IPrearo/PPOFs/README.md

# FIBRAS ÓPTICAS POR IMPRESSÃO 3D
Repositório para compartilhamento de dados do projeto "Fibras Ópticas por Impressão 3D," vigente de setembro de 2026 a agosto de 2029.
"PPOFs" é abreviação para "Printed Preform Optical Fibres."
