IPrearo/PPOFs/Relatorios de puxamento/PLT0019_no_core_petghf_vermelho_fdm/relatorio.pdf

Doc ID: PLT0019 Doc tipo: Relatório de fabricação

No core FDM PETG
Page 1 of 3

# 1 Pré-forma

A foto da pré-forma/tubo é mostrada em Fig. 1.

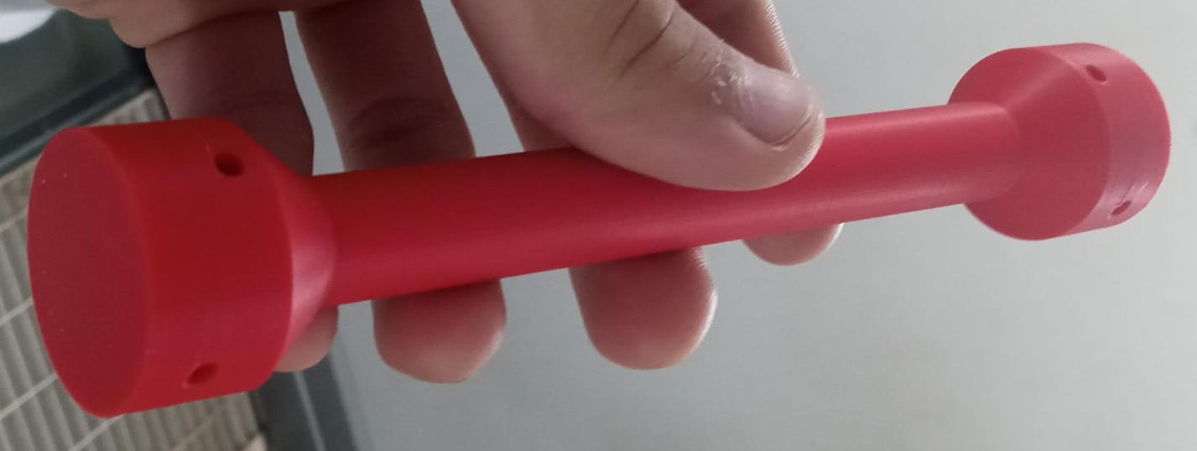
[picture p5: figure]

Figura 1: Tube.

Segue abaixo os principais parâmetros geométricos da pré-forma/do tubo.

- Participante(s) na confecção: Ivan Prearo.
- Objetivo: optimizar temperatura e velocidades de puxamento para amostra de PETG impressa na Bambum por FDM.
- Design: no core.
- As dimensões geométricas da pré-forma são mostrads no esquema da Fig. 2.

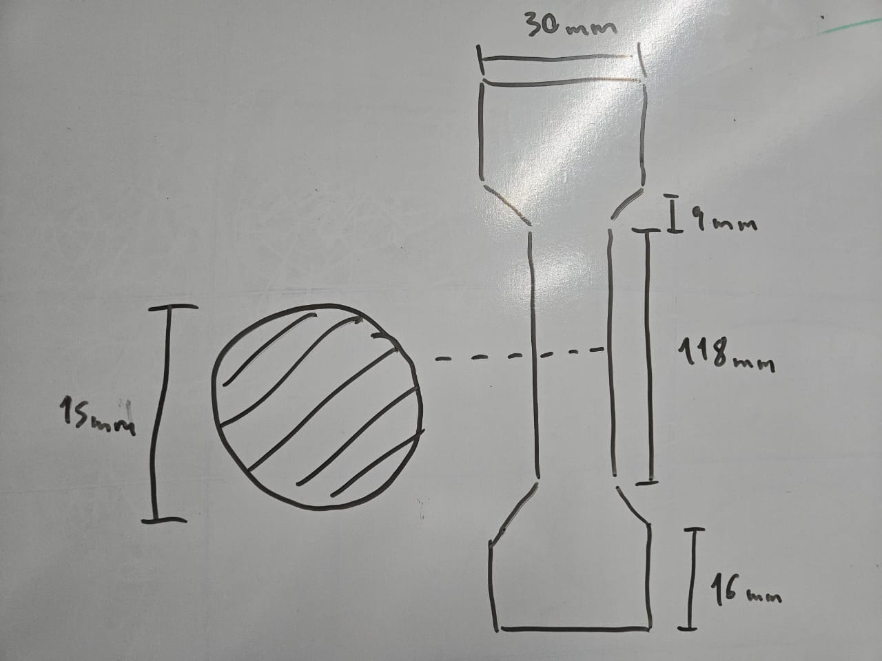
[picture p6: figure]

Figura 2: Tube.

Não houve condicionamento térmico da pré-forma nos fornos fora da torre de polímero, já que esse é um dos testes.

# 2 Primeiro puxamento

Não há primeiro puxamento para esta pré-forma.

# 3 Segundo puxamento

A rampa de temperatura do segundo puxamento é mostrada na Tab. 1.

© 2025 LaFE. All rights reserved. | Ultima data de revisão: 10/10/2025 ´

Doc ID: PLT0019 Doc tipo: Relatório de fabricação

Page 2 of 3
Temperature [°C] | Time [min]
120 130 | 30 5

Tabela 1: Rampa de temperatura no forno da torre para o segundo puxamento.

Segue abaixo alguns comentários gerais sobre o segundo puxamento.

- Data de puxamento: 10/10/2025.
- Participante(s): Eduardo Souza e Ivan Prearo.
- Iniciamos a rampa de temperatura a 120°C e após 30min fizemos o teste do unclamp/clamp. Notamos que a pré-forma começou a escorrer.
- Mudamos para 130°C e após a 5min iniciamos o puxamento.
- vfeed = 0.5mm/min.
- Inicamos vpull em 0.011m/min e fomos aumentando gradualmente.
- A amostra começou a ser puxada bem, no entando estouro depois de um tempo.
- A parte puxada é mostrada em Fig. 3a.
- Em Fig. 3b é possível ver a separação das camadas de impressão melhor, o que indica talvez que seja necessário aumentar o tempo da rampa de temperatura ou realizar condicionamento térmico de pré-rampa nos fornos fora da torre.
- Fig. 3c mostra que as paredes da pré-forma estavam sendo mais puxadas do que o núceo, o que indica uma inhomogeneidade de temperatura na pré-forma.
- Portanto, para o próximo puxamento desta a amostra, sugerimos:
– Realizar a rampa de temperatura proposta em Tab. 2.

– Variar mais lentamente vpull.

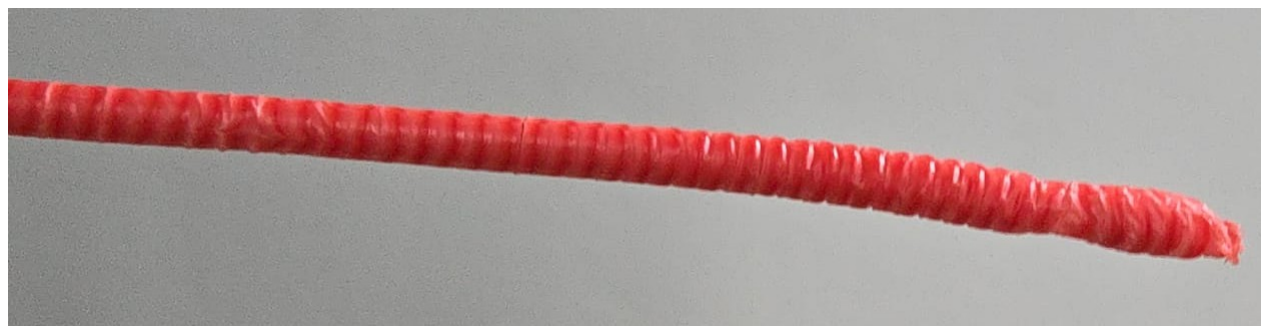
[picture p7: figure]
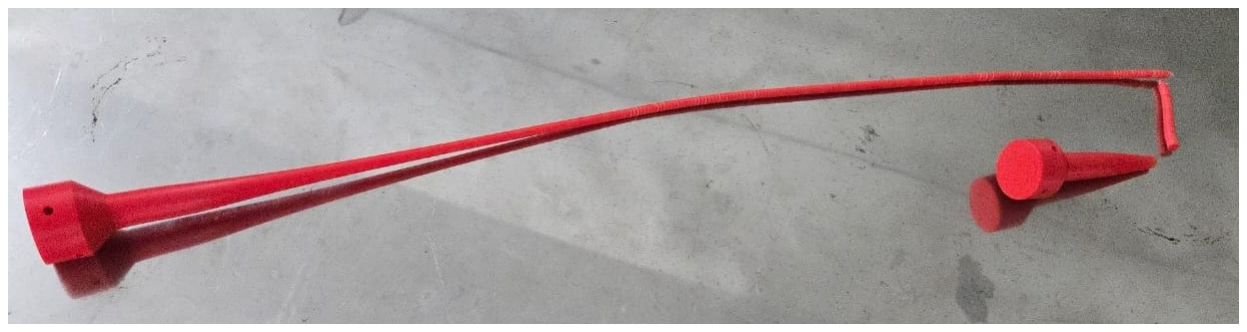
[picture p8: figure]

(a) Parte puxada. | (b) Separação das camadas de impressão.

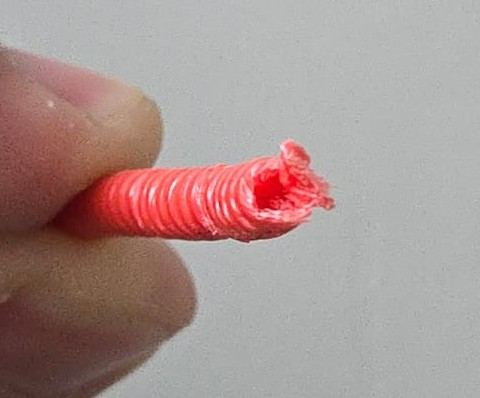
[picture p9: figure]

(c) Inomogeinedade de temperatura.

Figura 3: Fotos do resultado do segundo puxamento.

Doc ID: PLT0019 Doc tipo: Relatório de fabricação

Page 3 of 3
Temperature [°C] | Time [min]
90 100 110 120 130 | 30 30 30 5 2

Tabela 2: Proposta de rampa de temperatura no forno da torre para o próximo puxamento.
