IPrearo/PPOFs/Relatorios de puxamento/PLT0021_no_core_petghf_vermelho_fdm/relatorio.pdf

Doc ID: PLT0021 Doc tipo: Relatório de fabricação

FDM PETG
Page 1 of 4

# 1 Pré-forma

A foto da pré-forma é mostrada em Fig. 1.

Figura 1: Pré-forma.

Segue abaixo os principais parâmetros geométricos da pré-forma.

- Responsável pela confecção: Ivan Prearo.
- As dimensões desta pré-forma são as mesmas do relatório PLT0019 relatorio fabricacao fdm petg.
- Objetivo: optimizar a rampa de temperatura do puxamento, encontrar a temperatura de puxamento ideal e velocidades de alimentação e puxamento.

Não realizamos o condicionamento térmico da pré-forma nos fornos fora da torre de polímero, ou seja, após a impressão 3D a guardamos no armário.

# 2 Primeiro puxamento

Não se aplica!

# 3 Segundo puxamento

A rampa de temperatura do segundo puxamento é mostrada na Tab. 1. Possui uma duração total de 1h37min.
Temperature [°C] | Time [min]
90 100 110 120 130 | 45 30 15 5 2

Tabela 1: Rampa de temperatura no forno da torre para o segundo puxamento.

Segue abaixo alguns comentários gerais sobre o segundo puxamento.

- Data de puxamento: 17/10/2025.
- Participante(s): Eduardo Souza e Ivan Prearo.
- vfeed = 0.5mm/min.
- A amostra começou o puxamento bem, mas partiu após alguns minutos.
© 2025 LaFE. All rights reserved. | Ultima data de revisão: 17/10/2025 ´

Doc ID: PLT0021 Doc tipo: Relatório de fabricação

Page 2 of 4
- O resultado do puxamento é mostrado na Fig. 2
- A ponta partida parece ter sido puxada primariamente nas bordas e menos no centro (Fig. 3)
- A região mais puxada também parece ter separado as camadas de impressão da preforma (Fig. 4)
- Recomendamos realizar o puxamento a temperatura mais alta, possivelmente seguindo a rampa na Tabela 2.
- Para puxamentos a temperaturas maiores, pode ser necessário permitir a descida natural da fibra entre temperaturas da rampa, evitando a deformação vista no PLT0019, mas ainda atingindo temperaturas altas o suficiente para que as camadas de impressão não separem.

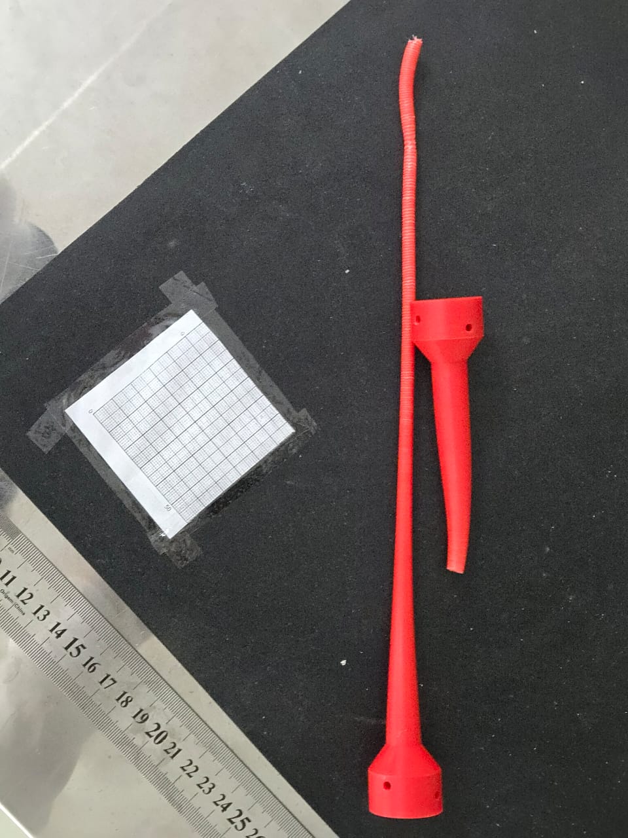
[picture p10: figure]

Figura 2: Resultado final do puxamento, com papel milimetrado para escala.

Doc ID: PLT0021 Doc tipo: Relatório de fabricação

Page 3 of 4

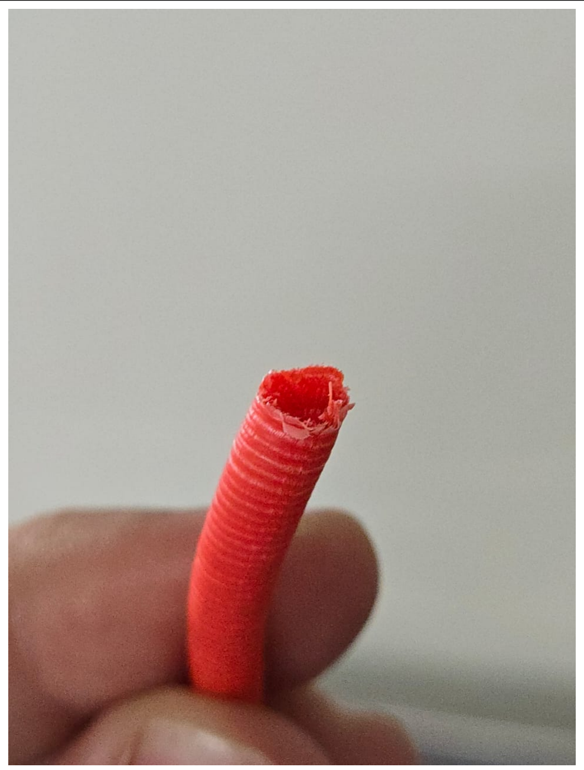
[picture p11: figure]

Figura 3: Ponto de falha do puxamento.

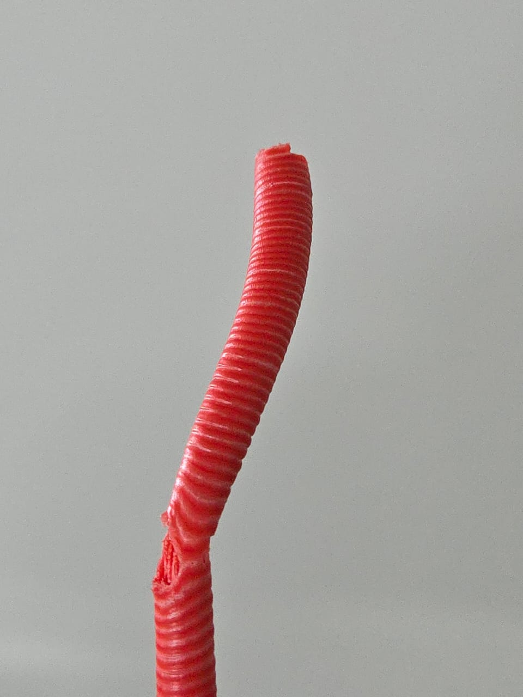
[picture p12: figure]

Figura 4: Região mais puxada do teste.

Doc ID: PLT0021 Doc tipo: Relatório de fabricação

Page 4 of 4
Temperature [°C] | Time [min]
90 110 130 140 150 | 45 30 15 5 2

Tabela 2: Rampa de temperatura no forno da torre recomendada.
