IPrearo/PPOFs/Relatorios de puxamento/PLT0024_no_core_petghf_vermelho_fdm/relatorio.pdf

Doc ID: PLT0024 Doc tipo: Relatório de fabricação

FDM PET-G HF Vermelho
Page 1 of 2

# 1 Pré-forma

A foto da pré-forma é mostrada em Fig. 1.

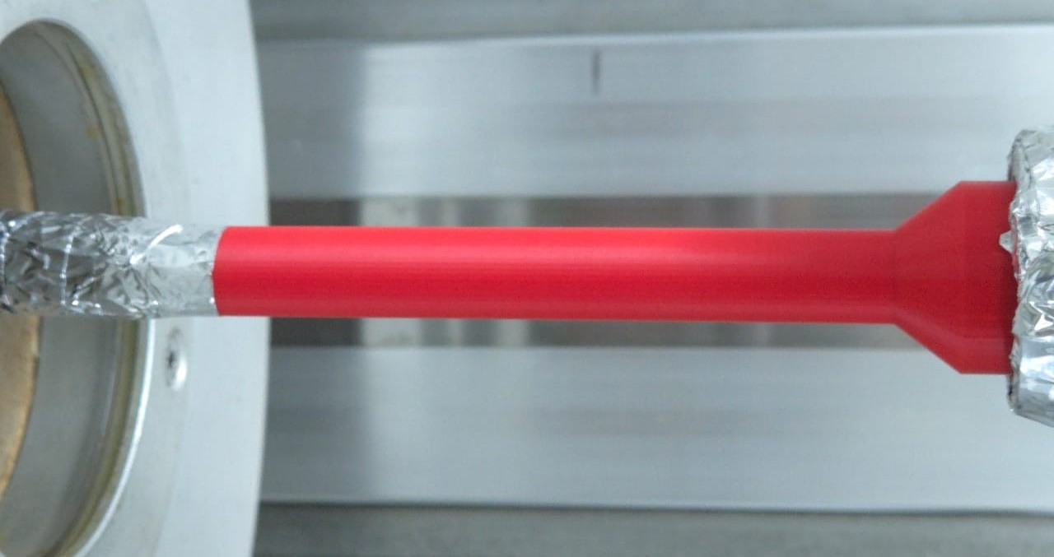
[picture p16: figure]

Figura 1: Pré-forma.

Segue abaixo os principais parâmetros geométricos da pré-forma.

- Participante(s) na confecção: Ivan Prearo;
- Design da pré-forma: no-core.
- Medidas semelhantes às descritas em PLT0019 preforma fdm petg hf vermelho, porém sem a parte de transição para 30mm na parte inferior para passar pelo Zumbach.
- Material: PET-G HF.
- Cor: vermelho.
- Método de fabricação: FDM.
- Objetivo: optimizar rampa de temperatura durante puxamento.

Não houve condicionamento térmico da pré-forma nos fornos fora da torre de polímero.

# 2 Primeiro puxamento

Não se aplica.

# 3 Segundo puxamento

A rampa de temperatura do segundo puxamento é mostrada na Tab. 1.
Temperature [°C] | Time [min]
90 120 150 170 190 | 45 30 15 5 2

Tabela 1: Rampa de temperatura no forno da torre para o segundo puxamento.

© 2025 LaFE. All rights reserved. | Ultima data de revisão: 30/10/2025 ´

Doc ID: PLT0024 Doc tipo: Relatório de fabricação

FDM PET-G HF Vermelho
Page 2 of 2
Podemos perceber por Fig. 2a que ocorre uma competição entre dois fenômenos para temperatura altas: a separação de camadas e a junção entre elas devido ao derretimento do polímero. Em Fig. 2b podemos perceber melhor o resultado final desta competição.

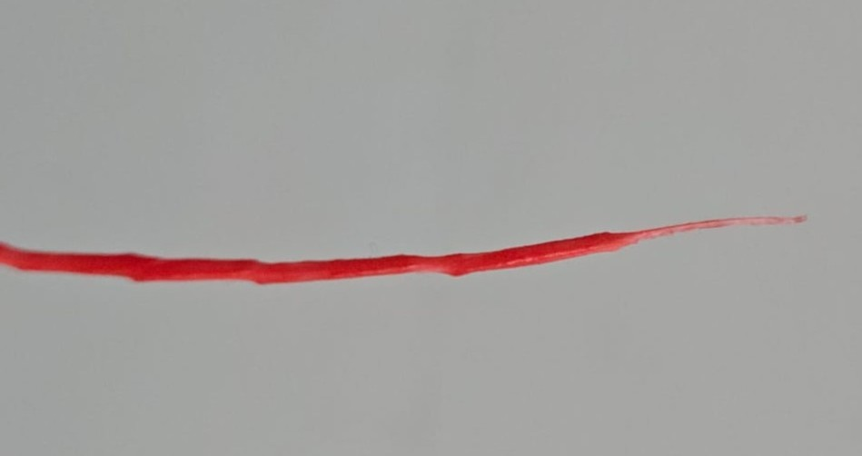
[picture p17: figure]
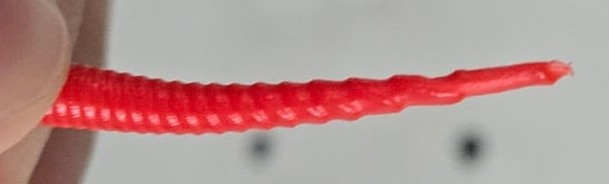
[picture p18: figure]

(a) Competição entre fenômenos. | (b) Separação das camadas.

Segue abaixo alguns comentários gerais sobre o segundo puxamento.

- Data de puxamento: 30/10/2025.
- Participante(s): Eduardo Souza e Ivan Prearo.
- vfeed = 0.5mm/min.
- Iniciamos com vpull = 0.018m/min e fomos aumentando gradualmente.
- A temperatura de puxamento ainda parece baixa pois é perceptível a separação entre as camadas da pré-forma.
- A pré-forma escorreu durante a rampa, ou seja, temos que reduzir o tempo em temperaturas a partir de 120°C e isso fez com que a fibra ficasse mais fina do que o desejado.
- Além disso, a tensão na fibra estava alta devido a baixa temperatura e esta arrebentou (Fig. 3).
- A nova rampa de tempratura é sugerida em Tab. 2.

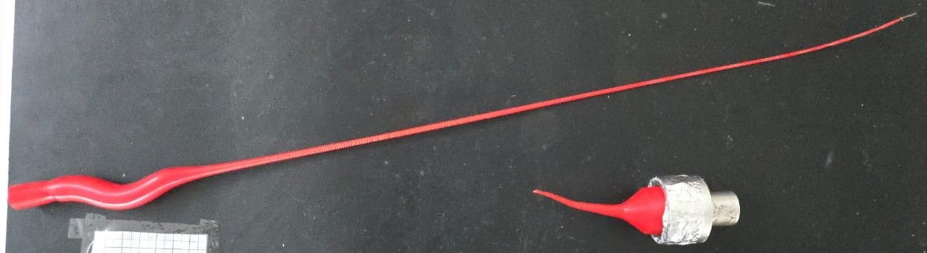
[picture p19: figure]

Figura 3: Rompimento da fibra durante o puxamento.

Temperature [°C] | Time [min]
90 120 150 170 190 200 | 45 15 5 5 2 2

Tabela 2: Rampa de temperatura no forno da torre para o segundo puxamento.

© 2025 LaFE. All rights reserved. | Ultima data de revisão: 30/10/2025 ´
