IPrearo/PPOFs/Relatorios de puxamento/PLT0032_no_core_petg_esverdeado_fdm/relatorio.pdf

Doc ID: PLT0030 Doc tipo: Relatório de fabricação

Título
Page 1 of 3

# 1 Pré-forma

A foto da pré-forma é mostrada em Fig. 1.

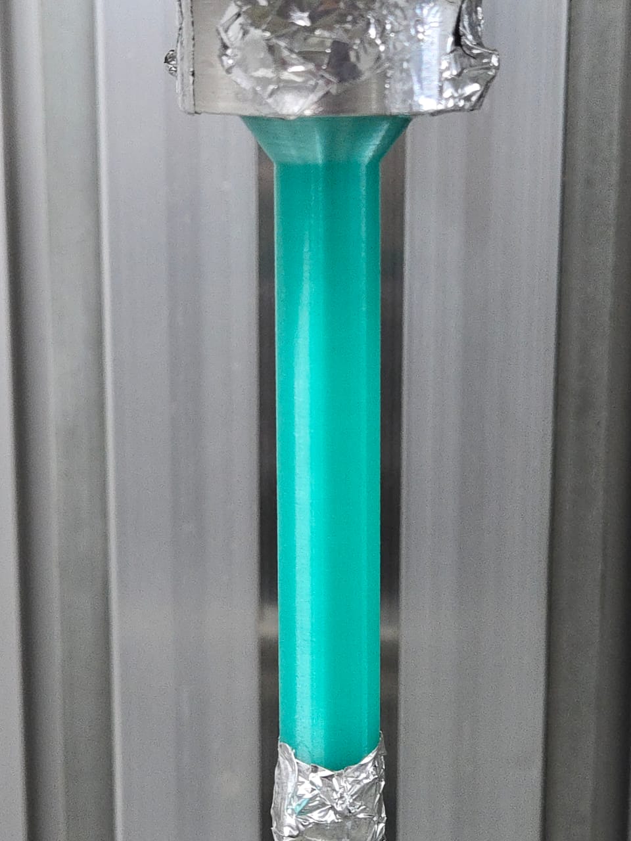
[picture p30: figure]

Figura 1: Pré-forma.

Segue abaixo os principais parâmetros geométricos da pré-forma/do tubo.

- Participante(s) na confecção: Ivan Prearo
- Altura/comprimento: 125 mm
- Diâmetro externo: 15 mm
- Objetivo: Caracterização da rampa de temperatura do material.

# 2 Segundo puxamento

A rampa de temperatura do segundo puxamento é mostrada na Tab. 1.
Temperature [°C] | Time [min]
90 120 190 | 60 10 2

Tabela 1: Rampa de temperatura no forno da torre para o segundo puxamento.

A foto das fibras produzidas é mostrada na Fig. 2.

© 2025 LaFE. All rights reserved. | Ultima data de revisão: 01/12/2025 ´

Doc ID: PLT0030 Doc tipo: Relatório de fabricação

Page 2 of 3

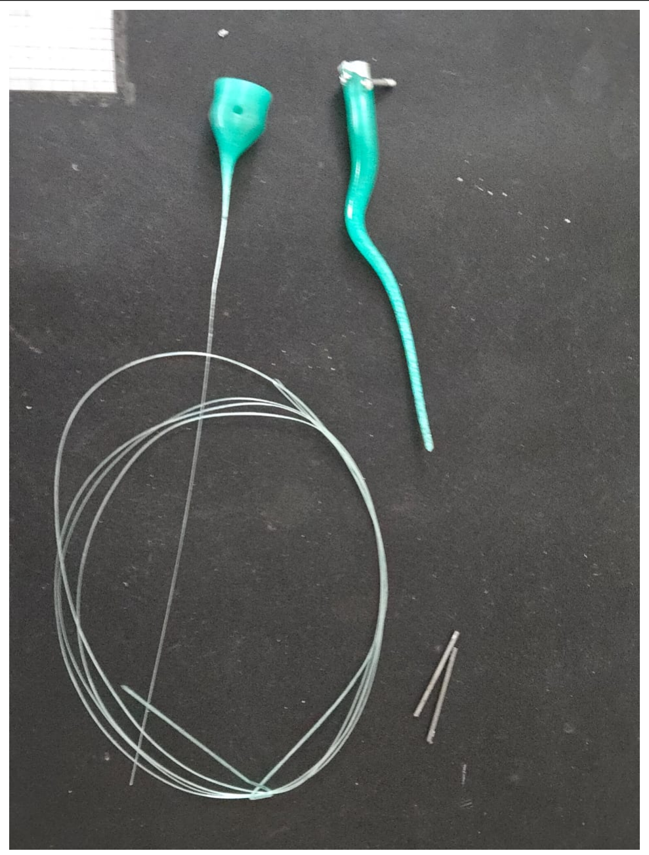
[picture p31: figure]

Figura 2: Fibras produzidas.

Segue abaixo alguns comentários gerais sobre o segundo puxamento.

- Data de puxamento: 29/11/2025
- Participante(s): Ivan Prearo
- A temperatura de puxamento de 200◦C se mostrou alta demais, pois a preforma deformou antes de ser puxada.

As fotos das micrografias são mostradas na Fig. 3. Nota-se que a fibra apresenta diversas bolhas, mas com geometria assimétrica na direção longitudinal.

Doc ID: PLT0030 Doc tipo: Relatório de fabricação

Page 3 of 3

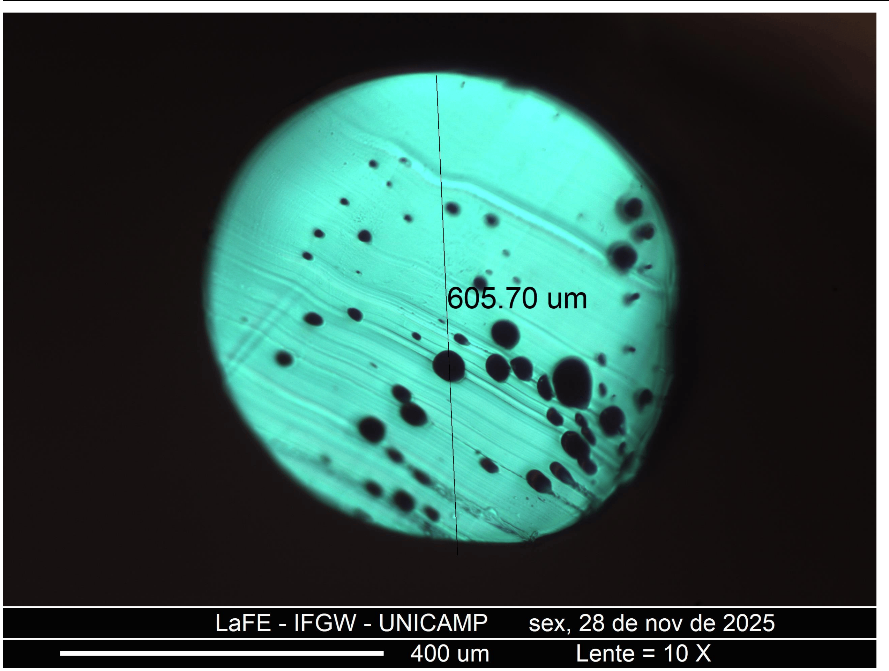
[picture p32: figure]
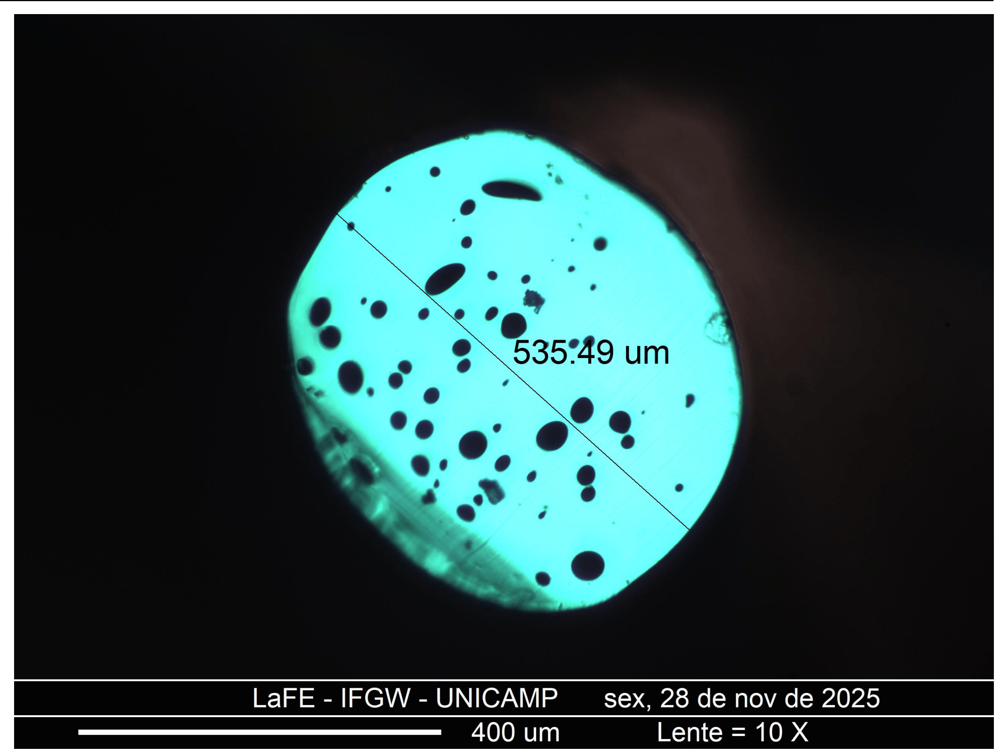
[picture p33: figure]

(a) Primeira clivagem. | (b) Segunda clivagem, maior eixo.

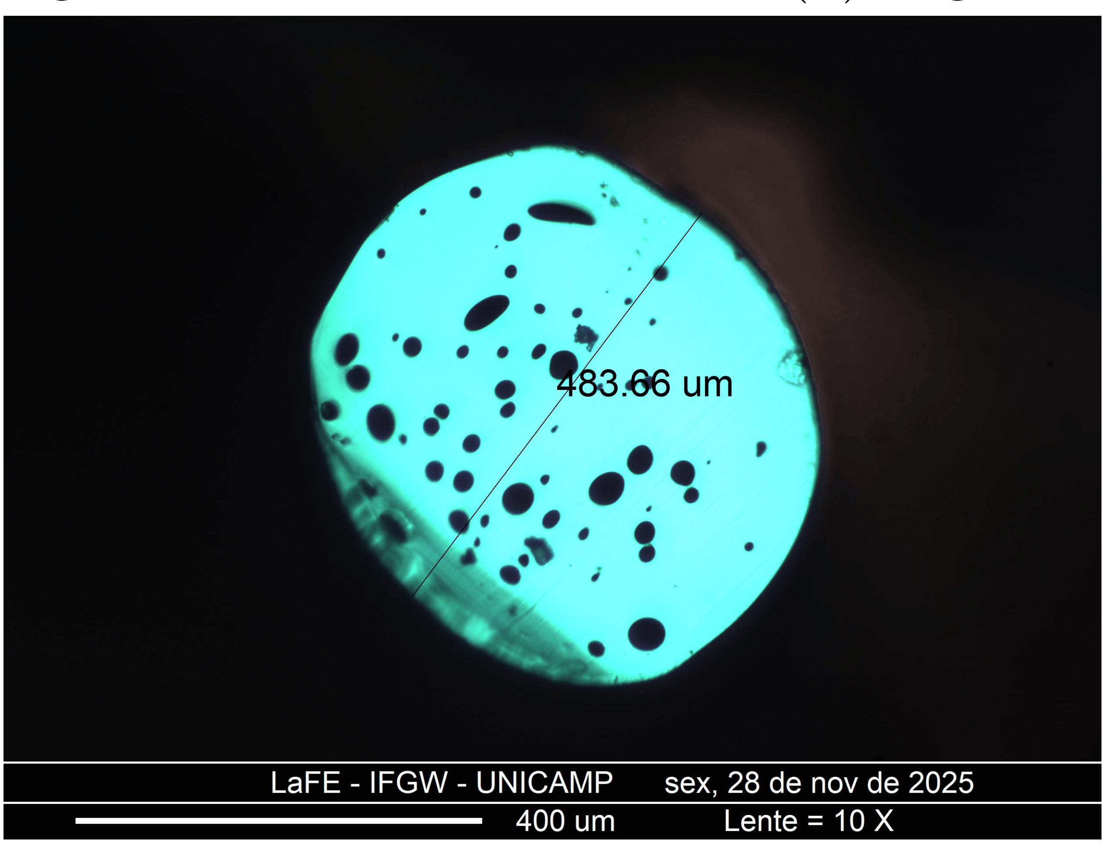
[picture p34: figure]

(c) Segunda clivagem, menor eixo.

Figura 3: Micrografias da fibra produzida em dois pontos próximos (≈ 5cm).
