IPrearo/PPOFs/Relatorios de puxamento/PLT0038_no_core_petg_translucido_fdm/relatorio.pdf

Doc ID: PLT0038 Doc tipo: Relatório de fabricação

No-core - PETG translucido ´ Page 1 of 3

# 1 Pré-forma/tubo

A foto da pré-forma/tubo é mostrada em Fig. 1.

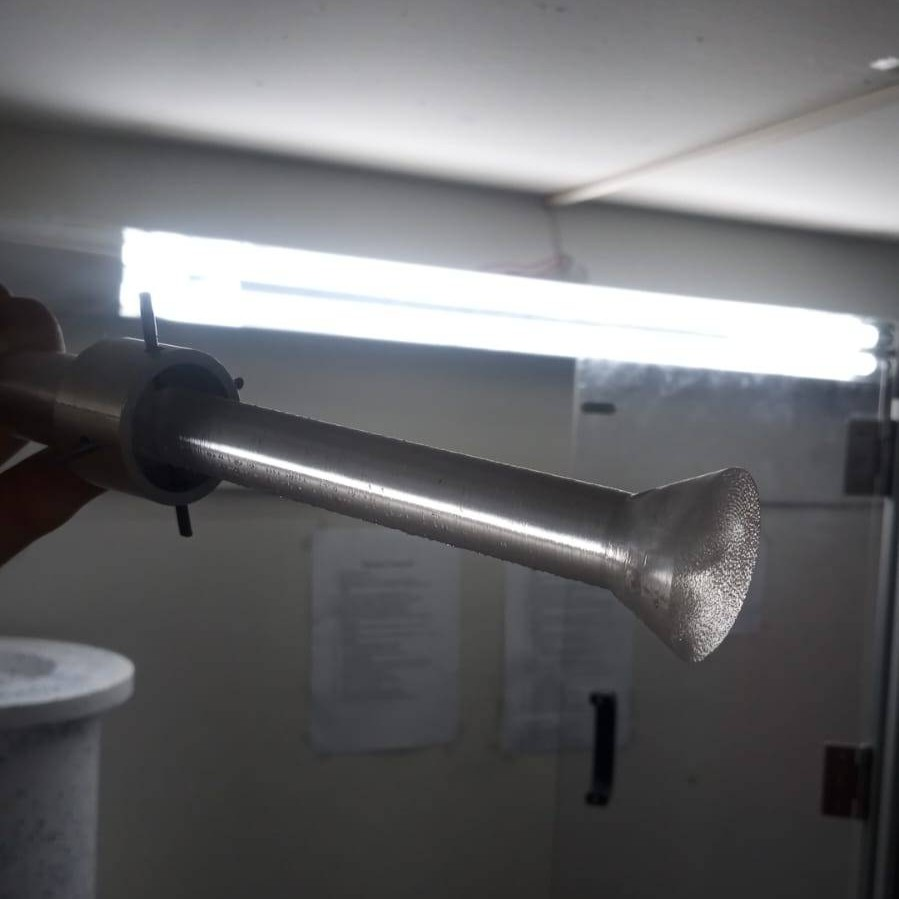
[picture p38: figure]

Figura 1: Pré-forma.

Segue abaixo os principais parâmetros geométricos da pré-forma/do tubo.

- Participante(s) na confecção: Ivan Prearo.
- Altura/comprimento: 100 mm.
- Diâmetro externo: 15 mm (30mm na base).
- Objetivo: Confecção de uma fibra no-core através de impressão 3D da preforma.

Os principais parâmetros de impressão usados para esta preforma são mostradas na Tabela 1.
Parâmetro | Valor
Preenchimento Temperatura de impressão Flow ratio Velocidade de impressão Largura da linha Altura da camada Diâmetro do bico | Concêntrico 280 °C 0.97 20 m/s 0.5/0.55 mm 0.08 mm 0.4 mm

Tabela 1: Principais parâmetros usados na impressão. A ordem dos parâmetros estão, aproximadamente, em importância decrescente para a transparência da amostra.

© 2025 LaFE. All rights reserved. | Ultima data de revisão: 10/02/2026 ´

Doc ID: PLT0038 Doc tipo: Relatório de fabricação

Page 2 of 3

# 2 Segundo puxamento

Segue abaixo alguns comentários gerais sobre o segundo puxamento.

- Data de puxamento: 03/02/2026
- Participante(s): Ivan Prearo, Eduardo Souza, Felipe Thomé.

A rampa de temperatura do segundo puxamento é mostrada na Tab. 2. Como a rampa teve de ser continuada durante o puxamento, a tabela também apresenta uma coluna de velocidade de puxamento para cada temperatura.
Temperature [°C] | Time [min] | vpull [m/min]
90 120 150 180 | 60 10 2 2 | 0 0 0 0

## Início do puxamento

190 | 4 | 0.017-0.04
200 | - | 0.04-0.07

Tabela 2: Rampa de temperatura no forno da torre para o segundo puxamento. vfeed foi mantida constante a 0.5 mm/min a partir do início do puxamento.

A foto das fibras produzidas é mostrada na Fig. 2, e uma foto da transição em Fig.
3. Nota-se que a transição apresentou alta rugosidade, mas a fibra final não.

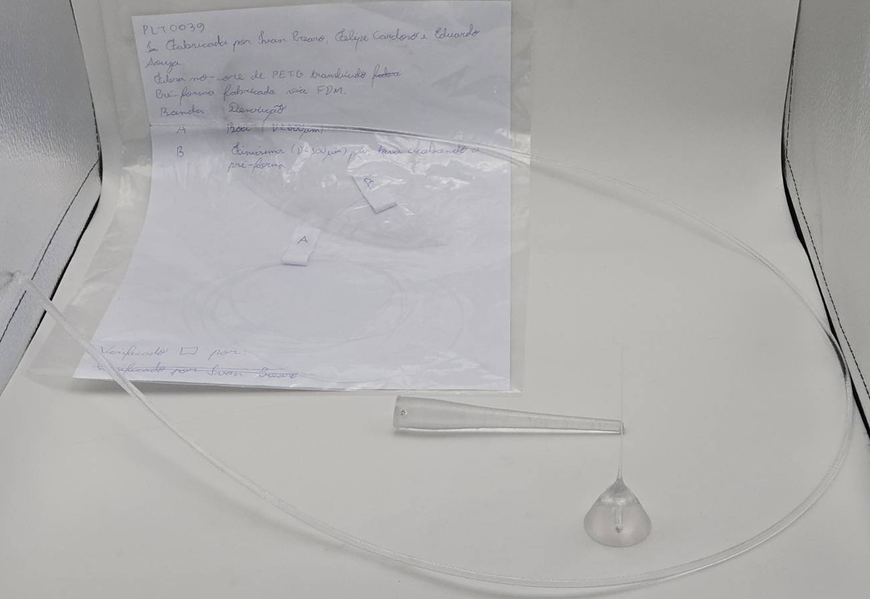
[picture p39: figure]

Figura 2: Fibras produzidas.

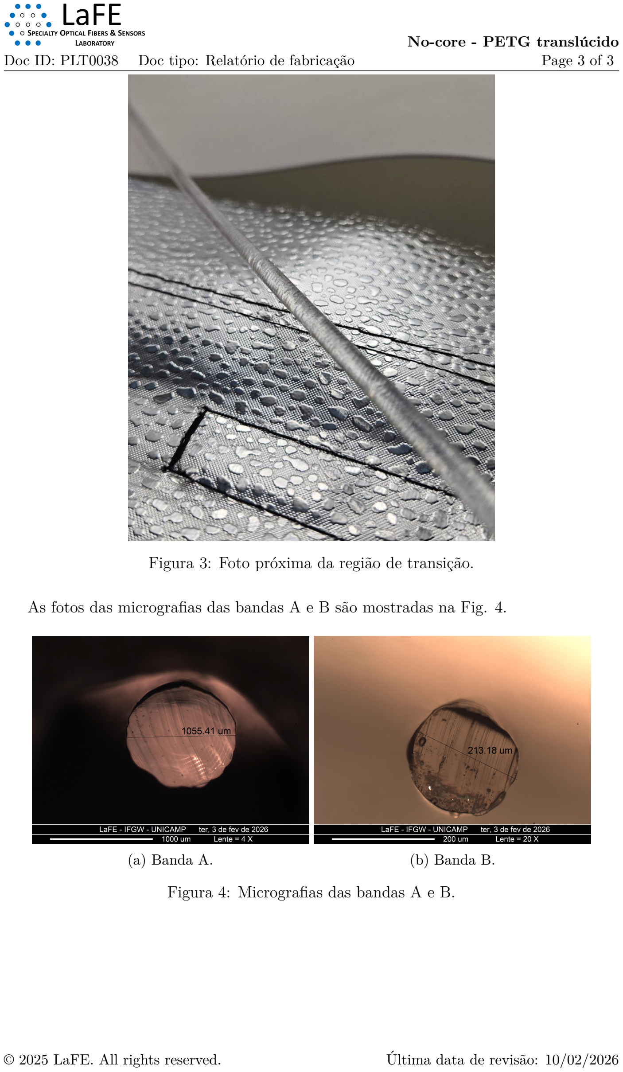
[picture p40: page 3]

Doc ID: PLT0038 Doc tipo: Relatório de fabricação

Page 3 of 3

Figura 3: Foto próxima da região de transição.

As fotos das micrografias das bandas A e B são mostradas na Fig. 4.

(a) Banda A. | (b) Banda B.

Figura 4: Micrografias das bandas A e B.
