IPrearo/PPOFs/Relatorios de puxamento/PLT0073_suspended_core_petg_esverdeado_fdm/relatorio.tex

\documentclass[12pt,a4paper]{article}

\usepackage[margin=2.5cm]{geometry}
\usepackage[utf8]{inputenc}
\usepackage[brazil]{babel}
\usepackage{lmodern}
\usepackage{fancyhdr}
\usepackage{tocloft}
\usepackage{amsmath}
\usepackage{graphicx}
\usepackage{booktabs}
\usepackage{array}
\usepackage{float}
\usepackage{hyperref}
\usepackage{lastpage}
\usepackage{subcaption}
\usepackage{multirow}

\newcommand{\diameter}{\phi}

\graphicspath{{../../../imagens_gerais/} {puxamento/}} 

\pagestyle{fancy}
\fancyhf{} 
\setlength{\headheight}{52pt}
\lhead{
   \\
  \small
  Doc ID: PLT0073 \quad
  Doc tipo: Relatório de fabricação \quad
}
\rhead{
  \small \textbf{PLT0073 Suspended core em PETG esverdeado} \\
  Page \thepage\ of \pageref{LastPage}
}
\lfoot{\small \textcopyright\ 2026 LaFE. All rights reserved.}
\rfoot{\small Última data de revisão: 13/07/2026}

\begin{document}

\tableofcontents
\newpage

  Descrição da participação dos envolvidos na fabricação desta fibra:
  \begin{itemize}
    \item Ivan Prearo: Fabricação e puxamento
  \end{itemize}

  \section{Geometria e material}
  \label{sec:geometria}

  Comentários gerais sobre esta etapa:
  \begin{itemize}
    \item Pré-forma:
    \begin{itemize}
      \item Material: PETG esverdeado;
      \item Comprimento total: \(L_T = 90 mm\);
      \item Comprimento útil: \(L = 58 mm\); 
      \item Diâmetro externo: \(\diameter_e = 70 mm\)
      \item Geometria da secção transversal: \textit{Suspended-core};
      \item Diâmetro do núcleo: \(\diameter_n = 9.6 mm\);
      \item Espessura do cladding: \(L_c = 12 mm\);
      \item Largura dos \textit{struts}: \(L_s = 0.6 mm\);
      \item Número de \textit{struts}: \(N_s = 3\);
      \item Razões entre medidas iniciais na Tabela \ref{tab:puxamento1_razoes_das_dimensoes}
    \end{itemize}
    \item Objetivo: Fabricação de fibra suspended-core com \textit{struts} finos.
    \item O esquema da geometria da secção transversal e a foto da pré-forma são mostrados em Fig.~\ref{fig:puxamento1_geometria_preforma}.
  \end{itemize}

  \begin{table}[H]
  \centering
  \begin{tabular}{c|c|c}
    Dimensão & Medida [mm] & Razão com $\diameter_e$ \\
    \hline
    $\diameter_c$ & 70 & 1 \\
    $\diameter_n$ & 9.6 & 0.137 \\
    $L_s$ & 0.6 & 0.0086 \\
    $L_c$ & 12 & 0.171
  \end{tabular}
  \caption{Relações entre medidas relevantes da preforma}
  \label{tab:puxamento1_razoes_das_dimensoes}
  \end{table}

  \begin{figure}[H]
    \centering
    \begin{subfigure}{0.45\textwidth}
      \centering
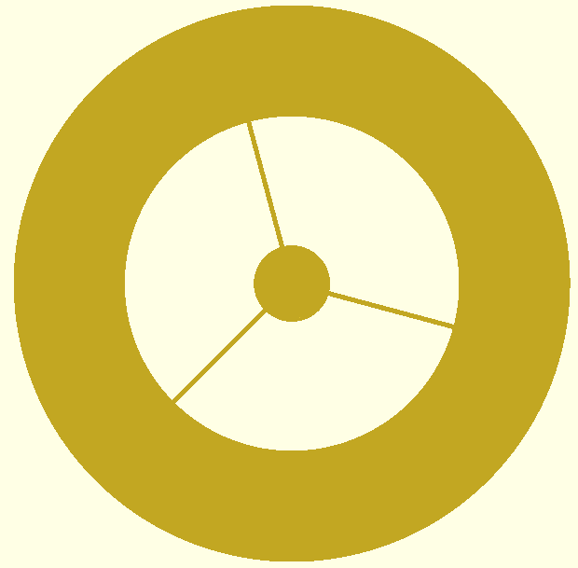
[picture p58: Relatorios de puxamento/PLT0073_suspended_core_petg_esverdeado_fdm/images/Esquema_sec_transversal.png]
      
      \caption{Seção transversal.}
    \end{subfigure}
    \hfill
    \begin{subfigure}{0.45\textwidth}
      \centering
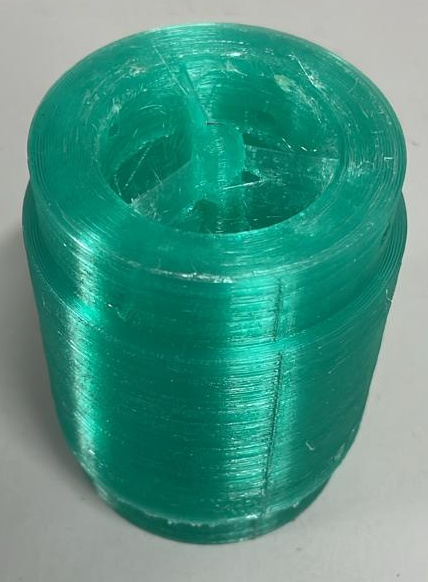
[picture p59: Relatorios de puxamento/PLT0073_suspended_core_petg_esverdeado_fdm/images/Preforma.jpeg]
      
      \caption{Foto.}
    \end{subfigure}
    \caption{Esquema do geometria da secção transversal e foto da pré-forma.}
    \label{fig:puxamento1_geometria_preforma}
  \end{figure}

  \section{Puxamento}
  \label{sec:puxamento}

  Por erros de informação das distâncias entre furos da tampa, não foi possível inserir ambos os pinos nas tampas.
  Portanto, a preforma foi puxada com um pino em cada extremidade.

  \subsection{Primeiro puxamento}
  \label{subsec:puxamento1}

    A rampa de secagem/recozimento é apresentada na Tab.~\ref{tab:puxamento1_fase1_etapa2_rampa}.
    Nota-se que após o primero escoamento, iniciou-se uma tentativa de puxamento que falhou pela preforma não estar na temperatura correta.
    Essa primeira tentativa causou uma deformação significativa na preforma, principalmente na direção sem pino como mostrado na Figura \ref{fig:puxamento_falho}, mas a preforma foi realinhada e mantida a 120$^\circ$C, testando se escoava ou não de 10 em 10 minutos.
    Após mais 40 minutos nessa temperatura, notou-se escoamento e uma nova tentativa de puxamento foi realizada.

    \begin{table}[H]
    \centering
    \begin{tabular}{ccc}   
      \toprule 
      \textbf{Fase} & \textbf{[°C]} & \textbf{Tempo [min]} \\ 
      \midrule
      \multirow{1}{*}{Secagem} & 60 & 60 \\
      \midrule
      \multirow{1}{*}{Amolecimento} & 80 & 60 \\
      \midrule
      \multirow{3}{*}{Escoamento} & 100 & 30 \\
                               & 110 & 15 \\ 
                               & 120 & 5 \\ 
      \midrule
      \multirow{1}{*}{Tentativa de puxamento} & 120 & 10 \\ 
      \midrule
      \multirow{1}{*}{Escoamento 2} & 120 & 40 \\ 
      \midrule
      \multirow{1}{*}{Puxamento} & 120 & \(\infty\) \\
      \bottomrule
    \end{tabular}
    \caption{Rampa de temperatura no forno da torre antes e durante o puxamento.}
    \label{tab:puxamento1_fase1_etapa2_rampa}
  \end{table}

  \begin{figure}[H]
    \centering
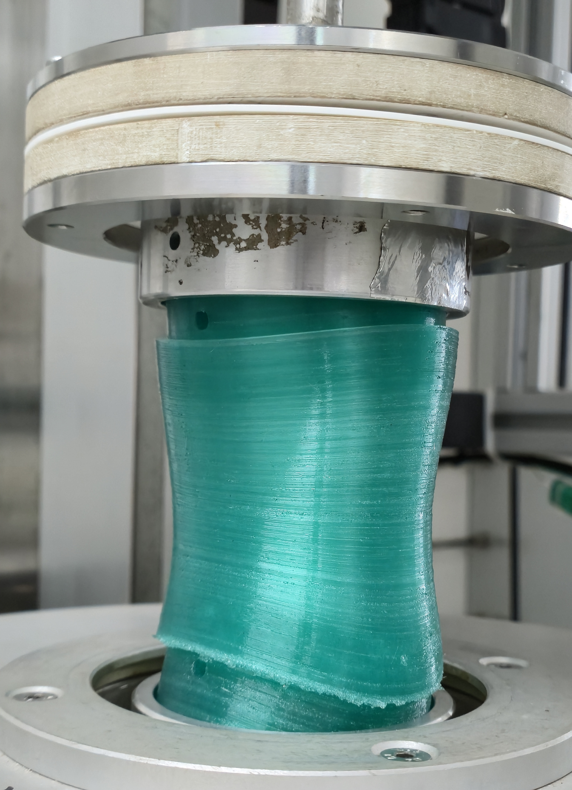
[picture p60: Relatorios de puxamento/PLT0073_suspended_core_petg_esverdeado_fdm/images/Falha_puxamento.jpg]
    
    \caption{Puxamento falho por rampa de temperatura curta demais.}
    \label{fig:puxamento_falho}
  \end{figure}

  Após a rampa total mostrada na Tabela \ref{tab:puxamento1_fase1_etapa2_rampa}, o puxamento ocorreu normalmente e o resultado foi um \textit{cane} de 56 cm de comprimento homogêneo com diâmetro de 9 a 11 cm (Fig. \ref{fig:cane_total}).

  \begin{figure}[H]
    \centering
    
    \begin{subfigure}{0.9\linewidth}
      \centering
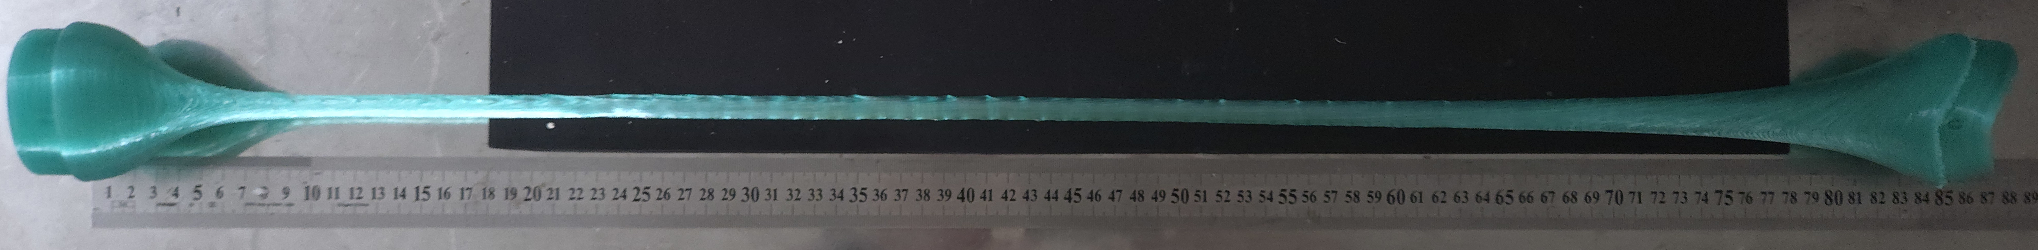
[picture p61: Relatorios de puxamento/PLT0073_suspended_core_petg_esverdeado_fdm/images/Cane_produzido.jpg]
      
      \caption{\textit{Cane} total.}
      \label{fig:cane_total}
    \end{subfigure}
    
    \begin{subfigure}{0.9\linewidth}
      \centering
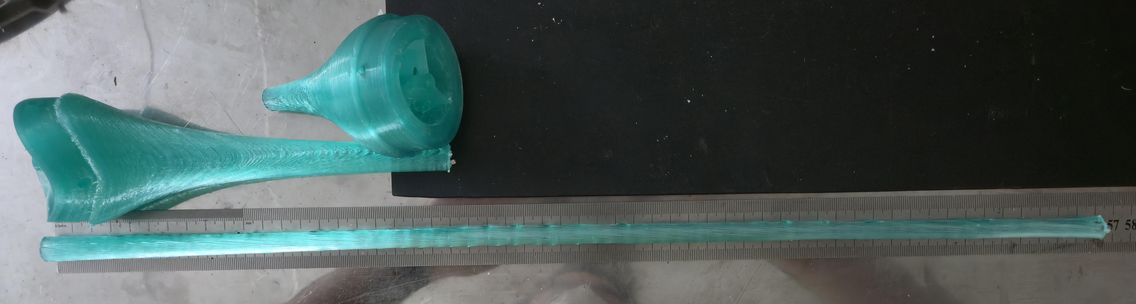
[picture p62: Relatorios de puxamento/PLT0073_suspended_core_petg_esverdeado_fdm/images/Cane_cortado_medida.jpg]
      
      \caption{Medida do \textit{cane} homogêneo.}
      \label{fig:cane_medida}
    \end{subfigure}

    \begin{subfigure}{0.9\linewidth}
      \centering
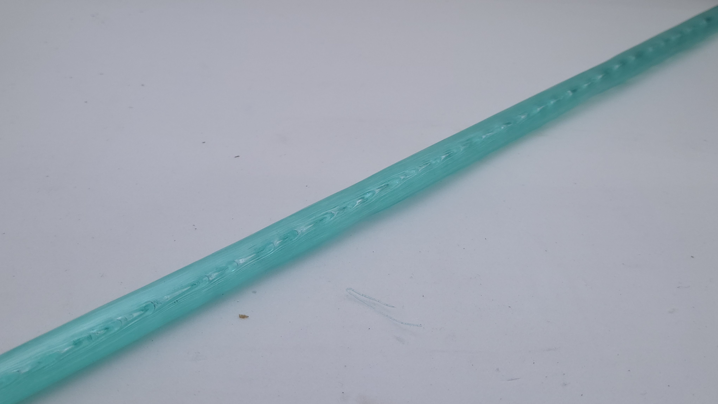
[picture p63: Relatorios de puxamento/PLT0073_suspended_core_petg_esverdeado_fdm/images/Cane_final.jpg]
      
      \caption{Foto aproximada.}
      \label{fig:cane_foto}
    \end{subfigure}

    \caption{\textit{Cane} produzido e sua respectiva medida de comprimento total.}
    \label{fig:cane_puxado}

  \end{figure}

  Durante o puxamento, por conta das deformações ocorridas antes do segundo período de escoamento, uma das struts se desfez (Fig. \ref{fig:sec_transversal_cane}).
  Além disso, é notável que os outros \textit{struts} ficaram demasiadamente finos e, em alguns locais, quebrados.
  Para amostras futuras, é recomendada a impressão de struts maiores.

  \begin{figure}[H]
    \centering
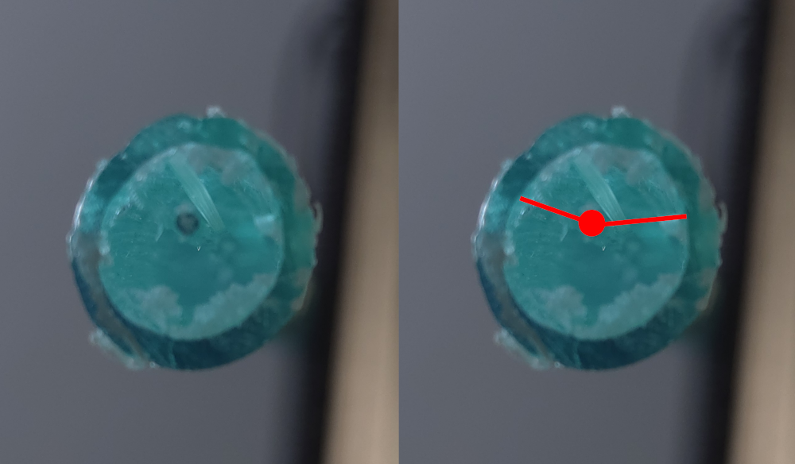
[picture p64: Relatorios de puxamento/PLT0073_suspended_core_petg_esverdeado_fdm/images/Cane_anotado.png]
    
    \caption{Seção transversal produzida. Em vermelho está anotada a estrutura restante no \textit{cane}.}
    \label{fig:sec_transversal_cane}
  \end{figure}

  \subsection{Armazenamento}
  \label{subsubsec:puxamento1_fase1_etapa3}

  \textit{Descrição desta etapa:} armazenamento da amostra

  Comentários gerais sobre esta etapa:
  \begin{itemize}
    \item Amostra armazenada a 60$^\circ$C, sem apresentar sinais de deterioração durante os 8 dias que foi mantida na estufa.
  \end{itemize}

  \subsection{Segundo puxamento}
  \label{subsec:puxamento2}

  \subsubsection{Primeira tentativa}
  \label{subsubsec:puxamento2_tentativa1}

  Comentários gerais sobre esta tentativa:
  \begin{itemize}
    \item Data de puxamento: 11/06/2026.
    \item A rampa de puxamento é mostrada na Tabela \ref{tab:puxamento1_fase2_tentativa1_rampa}.
    \item Resultou em falha.
  \end{itemize}

  O \textit{cane} produzido durante o primeiro puxamento teve furos feitos utilizando uma microrretífica para a inserção da tampa do extensor.
  Após os 10 minutos de escoamento a 120$^\circ$C, abriu-se o clamp do tractor a fim de testar a velocidade de escoamento pelo peso do extensor.
  Neste momento, o escoamento era rápido demais e, após 5 minutos de puxamento foi tomada a decisão de diminuir a temperatura ligeiramente, para 115$^\circ$C.
  No entanto, após a transição do extensor para a fibra no tractor, notou-se uma força contrária forte o suficiente para impedir o puxamento apenas do tractor.
  Após alguns minutos disso, a fibra sendo puxada com cerca de 1mm de diâmetro se rompeu (Figura \ref{fig:primeira_tentativa_res}).
  Há a teoria de que isso ocorreu pelo resfriamento da seção que estava sendo puxada, enquanto a tensão era mantida.
  Esse resfriamento foi primariamente atribuído à diminuição da temperatura durante o puxamento, mas há a possibilidade de que a amostra não estava sendo aquecida o suficiente durante a passagem pelo forno, diminuindo a temperatura real da amostra.

  \begin{table}[H]
    \centering
    \begin{tabular}{ccc}   
      \toprule 
      \textbf{Fase} & \textbf{[°C]} & \textbf{Tempo [min]} \\ 
      \midrule
      \multirow{1}{*}{Secagem} & 60 & 60 \\
      \midrule
      \multirow{1}{*}{Amolecimento} & 80 & 60 \\
      \midrule
      \multirow{3}{*}{Escoamento} & 100 & 30 \\
                                  & 110 & 15 \\
                                  & 120 & 10 \\
      \midrule
      \multirow{2}{*}{Puxamento} & 120 & 5 \\
                                 & 115 & $\infty$ \\
      \bottomrule
    \end{tabular}
    \caption{Rampa de temperatura no forno da torre antes do puxamento.}
    \label{tab:puxamento1_fase2_tentativa1_rampa}
  \end{table}

  \begin{figure}[H]
    \centering
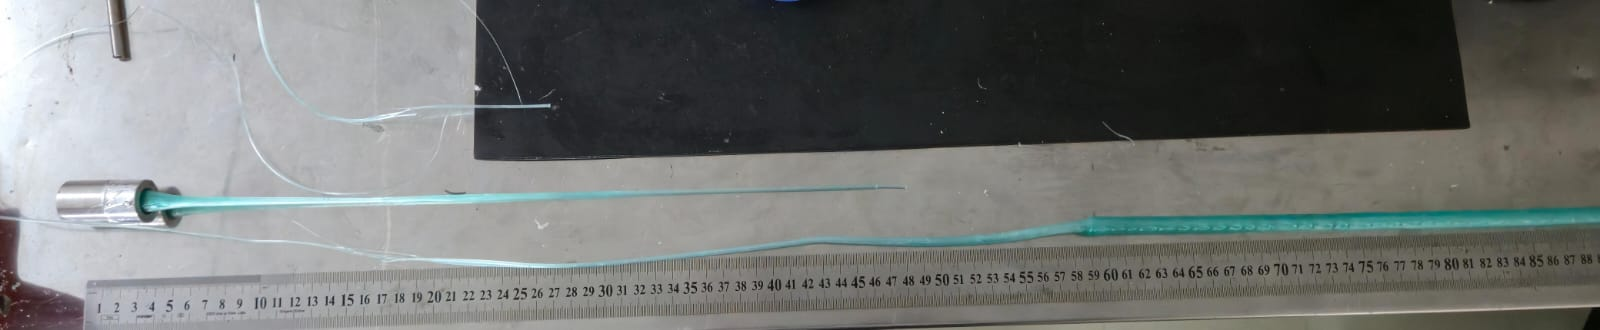
[picture p65: Relatorios de puxamento/PLT0073_suspended_core_petg_esverdeado_fdm/images/Resultado_primeira_tentativa.jpeg]
    
    \caption{Foto do resultado final da primeira tentativa.}
    \label{fig:primeira_tentativa_res}

  \end{figure}

  De qualquer maneira, a amostra foi mantida no forno parada a fim de recomeçar o puxamento, mas após diversos aumentos de temperatura ao longo de 1 hora, o teste de escoamento não demonstrava que a preforma havia chegado no ponto de puxamento.
  Isso indica que houve acúmulo de tensão interna no material, então a amostra foi cortada até a região de diâmetro constante e colocada novamente na estufa a 60$^\circ$C para puxamento posterior.
  O comprimento total de 56cm foi diminuído para 44cm durante este puxamento, o que ainda corresponde a uma amostra significativamente maior do que o atingido pela impressão direta em 15mm.

  \subsubsection{Segunda tentativa}
  \label{subsubsec:puxamento2_tentativa2}

  Comentários gerais sobre esta tentativa:
  \begin{itemize}
    \item Data de puxamento: 10/07/2026.
    \item A rampa de puxamento é mostrada na Tabela \ref{tab:puxamento1_fase2_tentativa2_rampa}.
    \item O puxamento resultou em sucesso parcial, produzindo dezenas de metros de fibra antes do rompimento.
    \item Ainda houve sobra significativa do \textit{cane} produzido no primeiro estágio, suficiente para uma terceira tentativa de puxamento.
  \end{itemize}

  A segunda tentativa de puxamento do \textit{cane} para fibra óptica utilizou uma rampa de temperatura mais demorada, mostrada na Tabela \ref{tab:puxamento1_fase2_tentativa2_rampa}.
  A intenção de uma rampa de temperatura mais longa é o maior amolecimento do \textit{cane} antes de puxá-lo.
  Durante o puxamento também foi verificada a tensão na fibra frequentemente.
  Caso a tensão aumentasse continuamente, a temperatura do forno era aumentada; e caso diminuísse continuamente, a temperatura do forno era diminuída.
  Essas mudanças são melhor visualizadas na Figura \ref{fig:puxamento2_tentativa2_temperaturas}.
  Isso foi feito para evitar a falha catastrófica que ocorreu na primeira tentativa de puxamento.

  \begin{table}[H]
    \centering
    \begin{tabular}{ccc}   
      \toprule 
      \textbf{Fase} & \textbf{[°C]} & \textbf{Tempo [min]} \\ 
      \midrule
      \multirow{1}{*}{Secagem} & 60 & 60 \\
      \midrule
      \multirow{1}{*}{Amolecimento} & 80 & 60 \\
      \midrule
      \multirow{3}{*}{Escoamento} & 100 & 30 \\
                                  & 110 & 20 \\
                                  & 120 & 15 \\
      \midrule
      \multirow{8}{*}{Puxamento} & 120 & 30 \\
                                 & 125 & 20 \\
                                 & 123 & 15 \\
                                 & 125 & 7 \\
                                 & 128 & 8 \\
                                 & 130 & 37 \\
                                 & 128 & 12 \\
                                 & 125 & -- \\
      \bottomrule
    \end{tabular}
    \caption{Rampa de temperatura no forno da torre antes do puxamento para a segunda tentativa.}
    \label{tab:puxamento1_fase2_tentativa2_rampa}
  \end{table}

  \begin{figure}[H]
    \centering
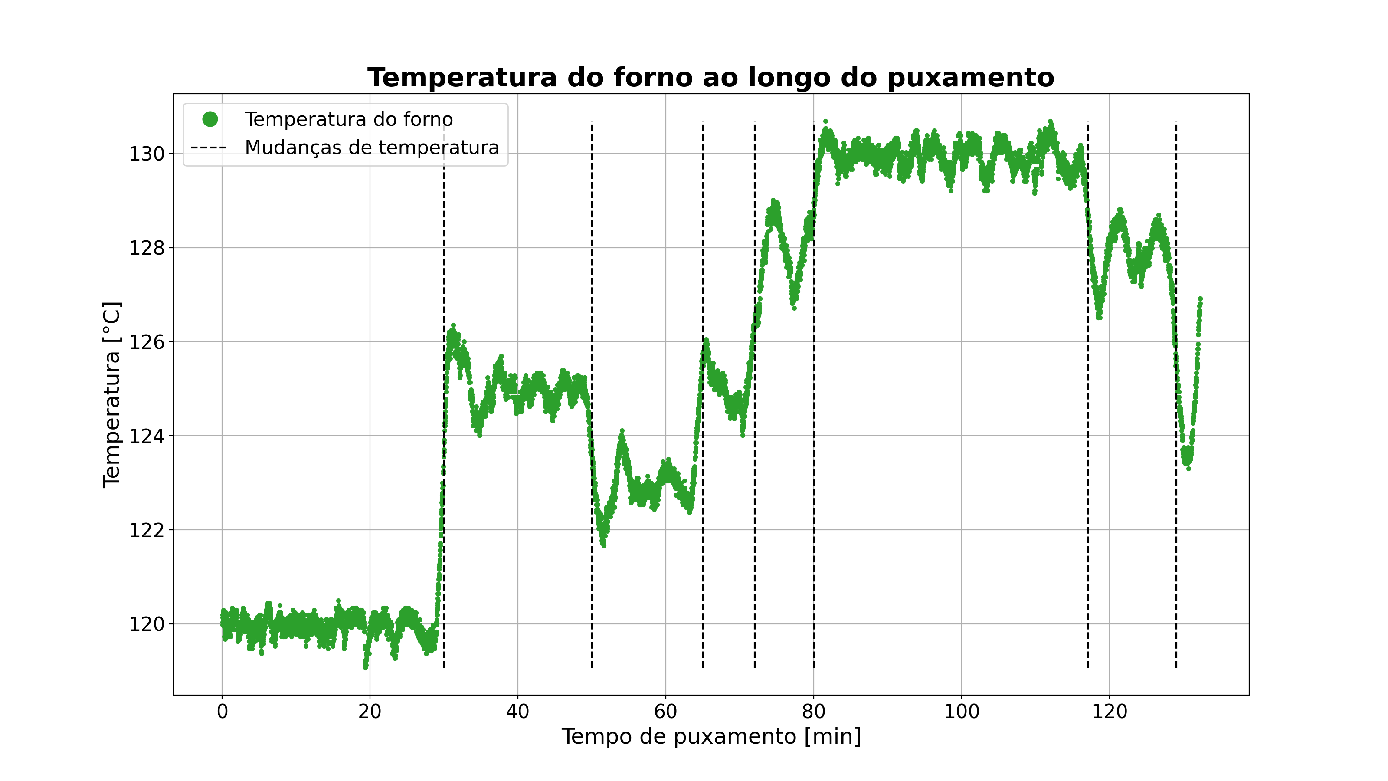
[picture p66: Relatorios de puxamento/PLT0073_suspended_core_petg_esverdeado_fdm/images/Temperatura.png]
    
    \caption{Gráfico de temperatura ao longo da fase de puxamento.}
    \label{fig:puxamento2_tentativa2_temperaturas}
  \end{figure}

  Durante o puxamento, após a transição da tampa no \textit{tractor}, houve o aumento de ambas a velocidades de \textit{feed} e \textit{pull}.
  O aumento dessas velocidades foi feito gradualmente e conjuntamente, a fim de manter a fibra puxada a um diâmetro de 1 mm.
  Essas mudanças de velocidades foram controladas para não coincidir exatamente com as mudanças de temperatura, a fim de deixar o puxamento mais estável, e estão graficadas na Figura \ref{fig:puxamento2_tentativa2_velocidades}.
  Nota-se que a razão entre velocidades não foi realizada de acordo com a teoria quando usa-se conversação de massa para encontrar os valores ideais.
  Isso se deve pela observação experimental da fibra puxada constar consistentemente abaixo do diâmetro previsto para cada par $(v_{feed}, v_{pull})$,
  essa observação pode ser visualizada nas Figuras \ref{fig:puxamento2_tentativa2_razoes} e \ref{fig:puxamento2_tentativa2_desvio} (até a marca de $\approx$60 minutos).

  \begin{table}[H]
    \centering
    \begin{tabular}{ccc}
      \toprule 
      \textbf{Tempo [min]} & $v_{feed}$ [mm/min] & $v_{pull}$ [m/min] \\ 
      \midrule
      5 & 0.05 & 0.01 \\
      3 & 0.05 & 0.015 \\
      3 & 0.05 & 0.02 \\
      2 & 0.05 & 0.025 \\
      33 & 0.05 & 0.03 \\
      7 & 0.6 & 0.035 \\
      5 & 0.75 & 0.04 \\
      5 & 0.85 & 0.045 \\
      10 & 1 & 0.05 \\
      4 & 1 & 0.06 \\
      3 & 1.15 & 0.07 \\
      20 & 1.25 & 0.09 \\
      10 & 1.25 & 0.1 \\
      10 & 1.5 & 0.13 \\
      3 & 2 & 0.3 \\
      3 & 2 & 0.5 \\
      2 & 2 & 0.7 \\
      -- & 2 & 1 \\
      \bottomrule
    \end{tabular}
  \end{table}

  \begin{figure}[H]
    \centering
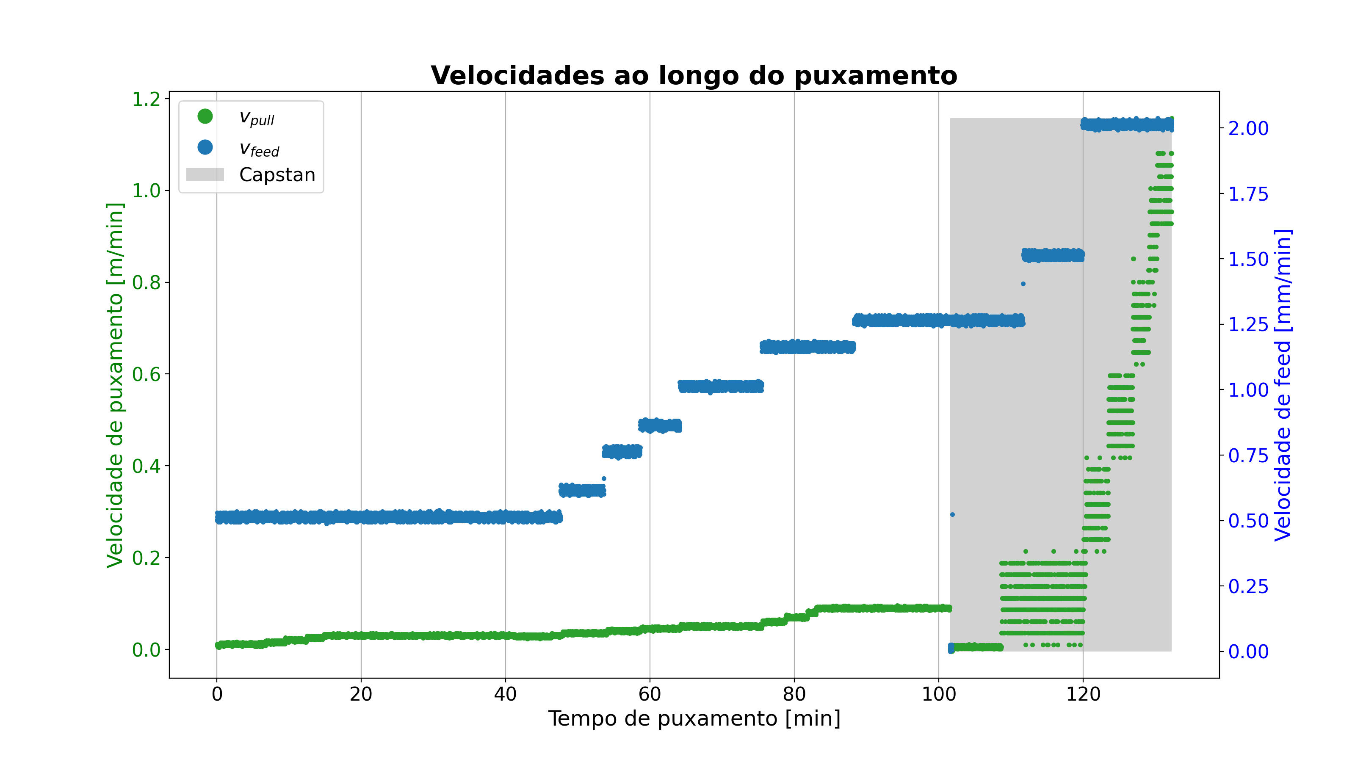
[picture p67: Relatorios de puxamento/PLT0073_suspended_core_petg_esverdeado_fdm/images/Velocidades.png]
    
    \caption{Gráfico de velocidades de \textit{feed} e \textit{pull} ao longo da fase de puxamento. Nota-se que a velocidade de puxamento está nula por um período próximo de 100 min. Isso ocorreu pela troca de puxamento do tractor para capstan e não é condizente com os valores reais.}
    \label{fig:puxamento2_tentativa2_velocidades}
  \end{figure}

  \begin{figure}[H]
    \centering
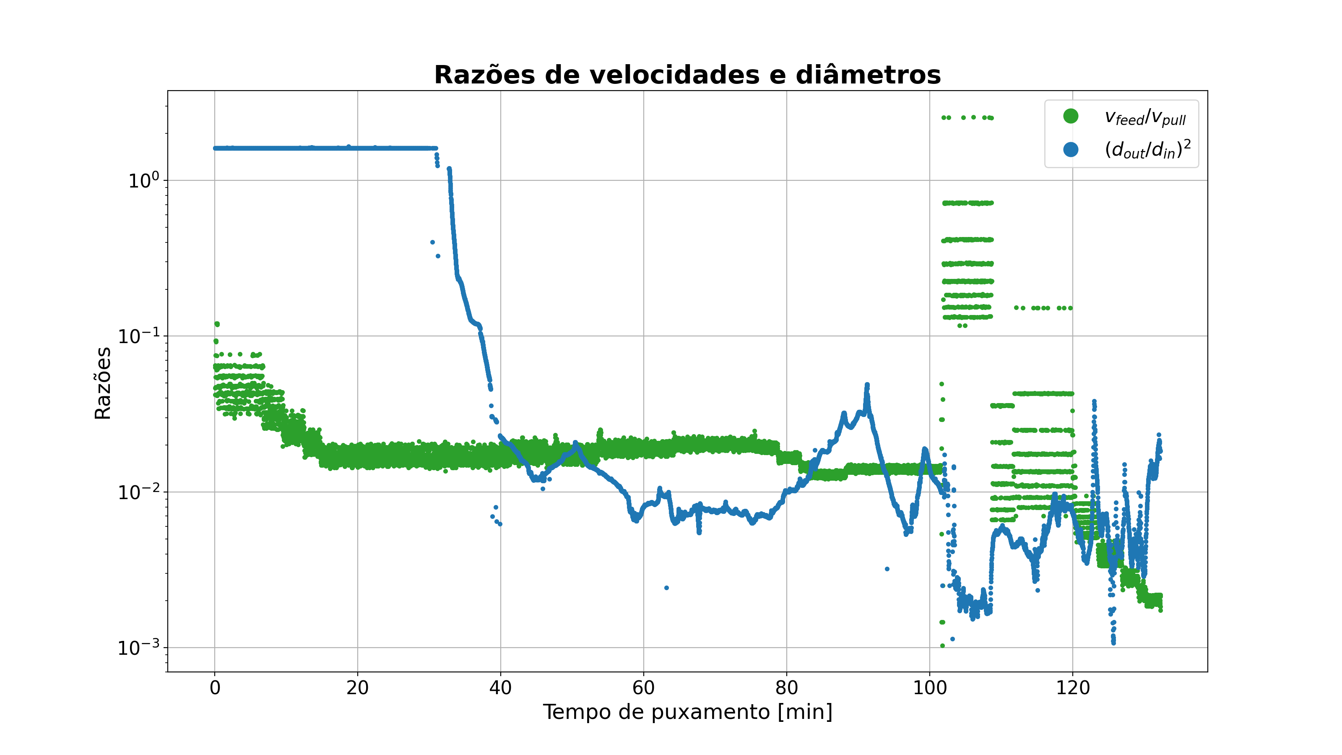
[picture p68: Relatorios de puxamento/PLT0073_suspended_core_petg_esverdeado_fdm/images/Razoes_vel_e_diam.png]
    
    \caption{Gráfico das razões das velocidades de alimentação e puxamento em relação ao diâmetro medido. A razão de diâmetros está quadrada pois a razão teórica depende quadraticamente da razão de velocidades.}
    \label{fig:puxamento2_tentativa2_razoes}
  \end{figure}

  \begin{figure}[H]
    \centering
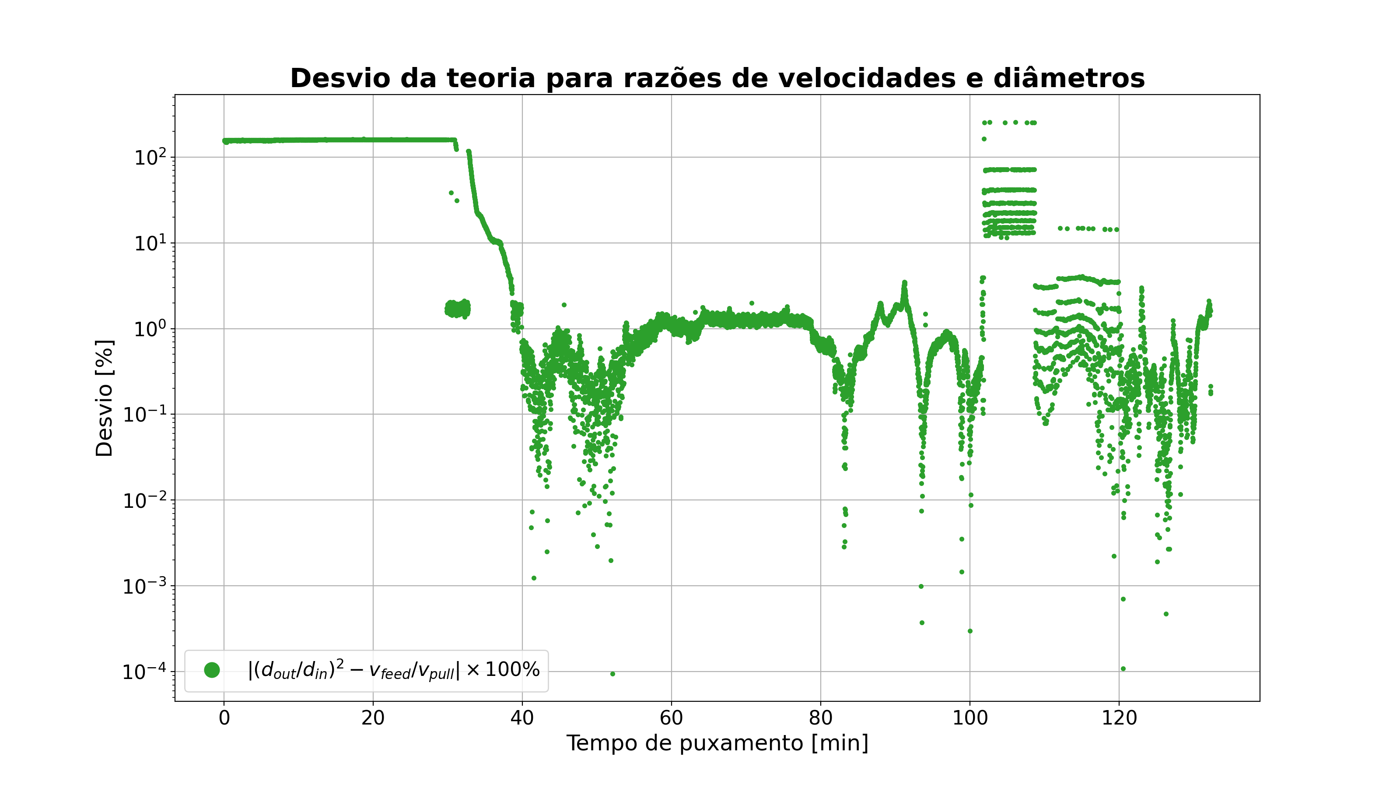
[picture p69: Relatorios de puxamento/PLT0073_suspended_core_petg_esverdeado_fdm/images/Desvio_vel_e_diam.png]
    
    \caption{Desvio dos diâmetros encontrados em relação à teoria.}
    \label{fig:puxamento2_tentativa2_desvio}
  \end{figure}

  A falha do puxamento com um súbito aumento da tensão na fibra após a última mudança de temperatura.
  Imagina-se que a temperatura ideal para o puxamento seja acima de 125$^\circ$C por conta disso.
  Mesmo assim, dezenas de metros de fibra foram fabricados. Mais detalhes serão discutidos na seção \ref{subsec:resultados_segunda_tentativa}.

  \section{Resultados}
  \label{sec:puxamento_resultados}

  A seção de resultados será dividida em subseções relacionadas com as tentativas de segundo puxamento.

  \subsection{Segunda tentativa}
  \label{subsec:resultados_segunda_tentativa}

  Comentários gerais dos resultados:
  \begin{itemize}
    \item As fotos das fibras produzidas estão na Figura \ref{fig:puxamento2_tentativa2}.
    \item A micrografia da Figura \ref{fig:puxamento2_tentativa2_micrografias} demonstra a qualidade e dimensão final da fibra atingida.
  \end{itemize}

  \begin{figure}[H]
    \centering
      \begin{subfigure}{0.7\textwidth}
      \centering
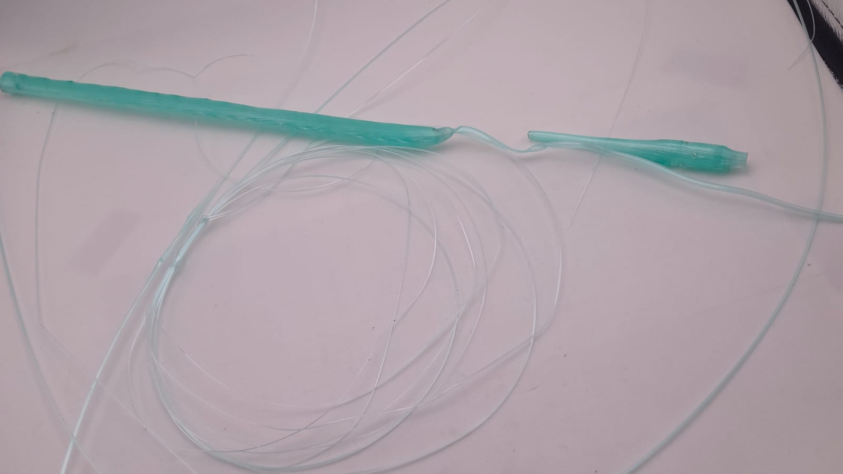
[picture p70: Relatorios de puxamento/PLT0073_suspended_core_petg_esverdeado_fdm/images/Fibras_segunda_tentativa.jpeg]
      
      \caption{Pequena coleção de fibras resultantes da segunda tentativa de puxamento.}
      \label{fig:puxamento2_tentativa2_colecao}
    \end{subfigure}
    \hfill
    \begin{subfigure}{0.9\textwidth}
      \centering
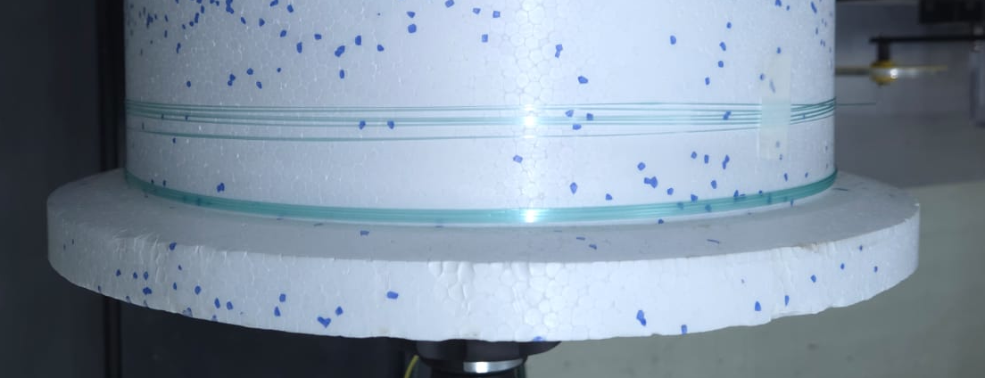
[picture p71: Relatorios de puxamento/PLT0073_suspended_core_petg_esverdeado_fdm/images/Rolo_fibra_segunda_tentativa.png]
      
      \caption{Dezenas de metros de fibra produzida na segunda tentativa.}
      \label{fig:puxamento2_tentativa2_rolo}
    \end{subfigure}
    \caption{Resultado da segunda tentativa de puxamento do \textit{cane}.}
    \label{fig:puxamento2_tentativa2}
  \end{figure}

  \begin{figure}[H]
    \centering
      \begin{subfigure}{0.48\textwidth}
      \centering
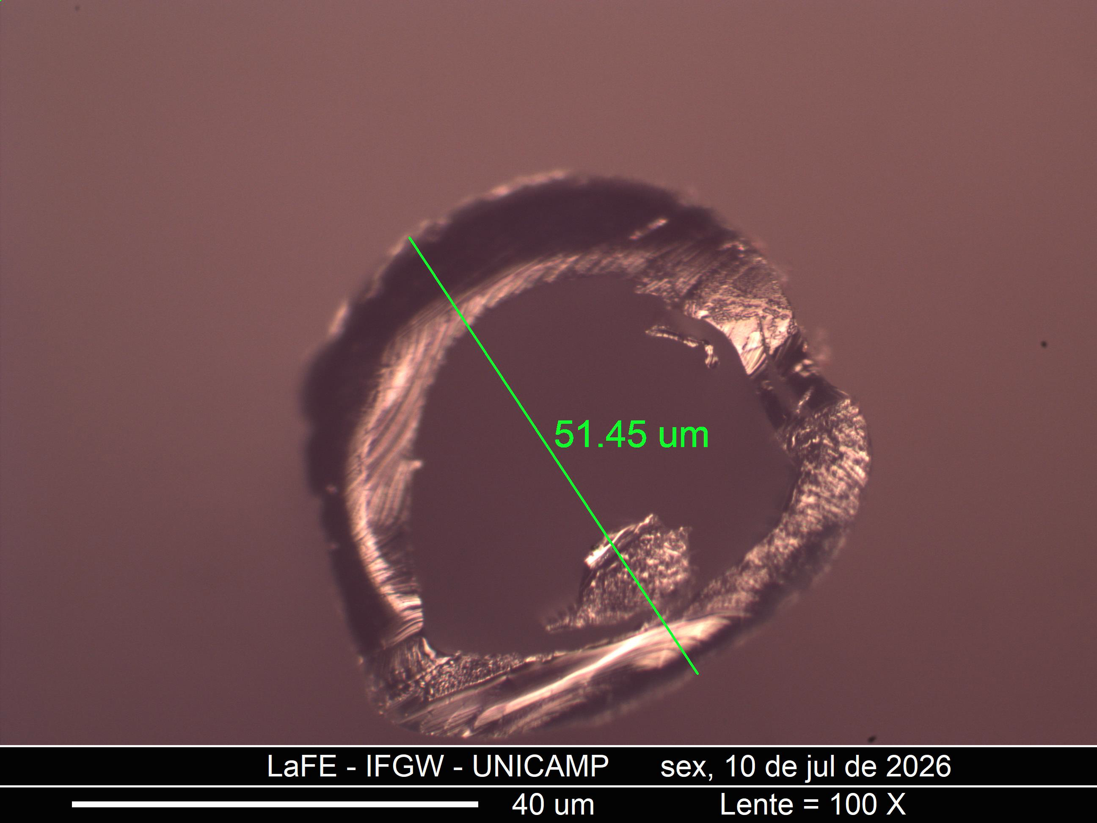
[picture p72: Relatorios de puxamento/PLT0073_suspended_core_petg_esverdeado_fdm/images/Diam_ext.png]
      
      \caption{Medida de um dos diâmetros externos da fibra.}
      \label{fig:puxamento2_tentativa2_micro_diam_ext1}
    \end{subfigure}
    \hfill
      \begin{subfigure}{0.48\textwidth}
      \centering
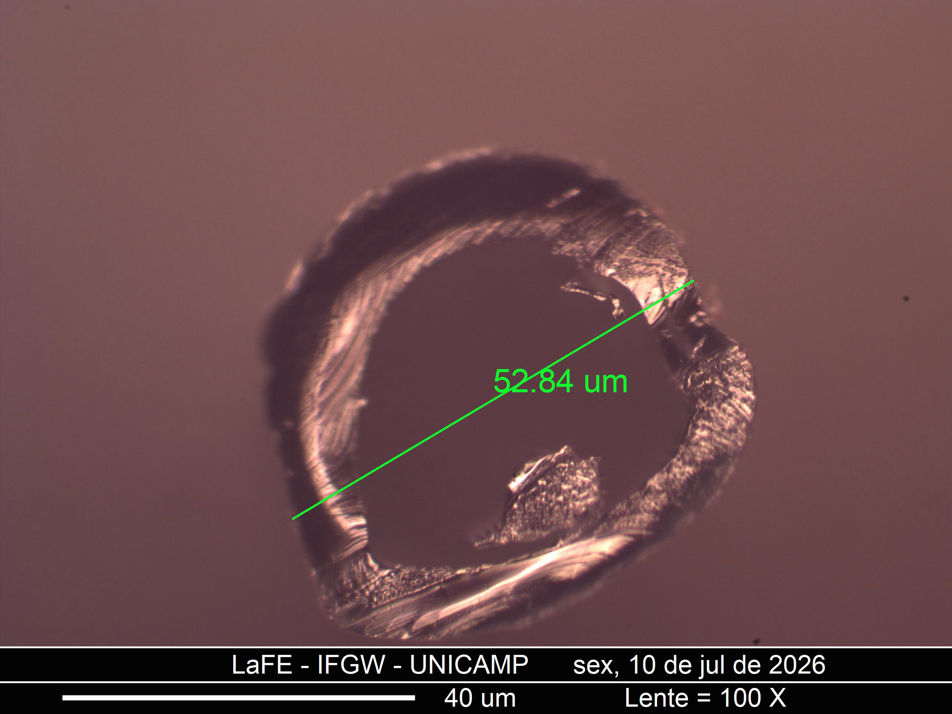
[picture p73: Relatorios de puxamento/PLT0073_suspended_core_petg_esverdeado_fdm/images/Diam_ext2.png]
      
      \caption{Medida do segundo diâmetro externo da fibra.}
      \label{fig:puxamento2_tentativa2_micro_diam_ext2}
    \end{subfigure}
    \hfill
      \begin{subfigure}{0.48\textwidth}
      \centering
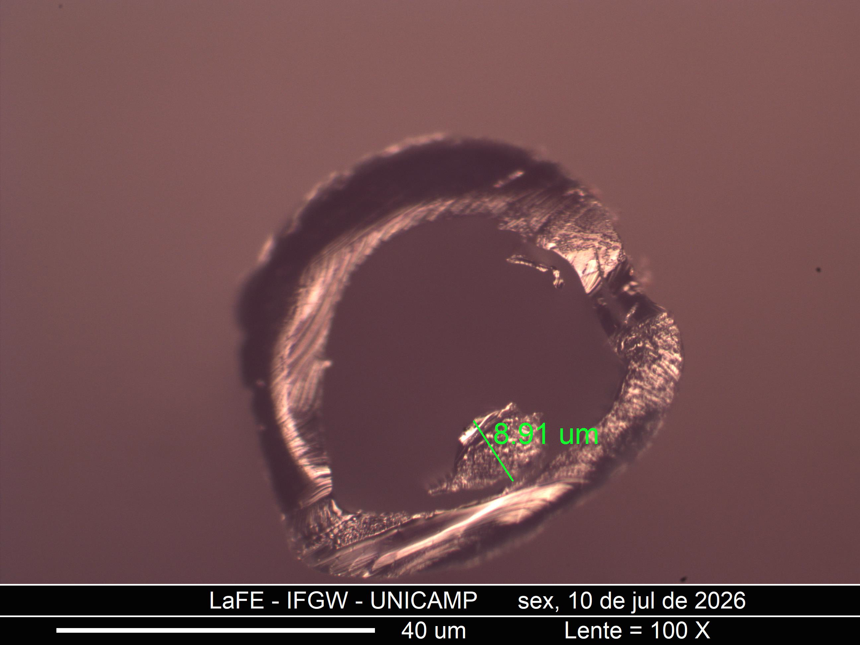
[picture p74: Relatorios de puxamento/PLT0073_suspended_core_petg_esverdeado_fdm/images/Diam_int1.png]
      
      \caption{Medida de um dos diâmetros do núcleo da fibra.}
      \label{fig:puxamento2_tentativa2_micro_diam_int1}
    \end{subfigure}
    \hfill
      \begin{subfigure}{0.48\textwidth}
      \centering
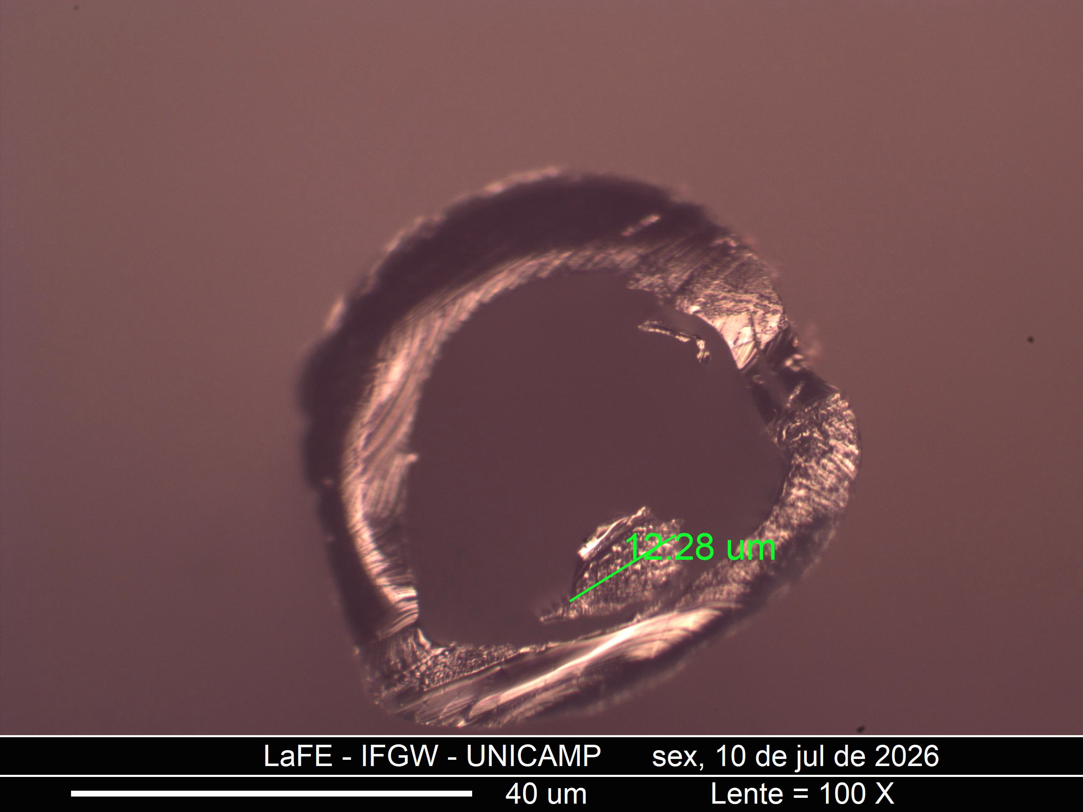
[picture p75: Relatorios de puxamento/PLT0073_suspended_core_petg_esverdeado_fdm/images/Diam_int2.png]
      
      \caption{Medida do segundo diâmetro do núcleo da fibra.}
      \label{fig:puxamento2_tentativa2_micro_diam_int2}
    \end{subfigure}
    \hfill
    \caption{Micrografia de uma seção de fibra da segunda tentativa de puxamento do \textit{cane}.}
    \label{fig:puxamento2_tentativa2_micrografias}
  \end{figure}

  % \section*{Puxamento 2}
  % \label{sec:puxamento2}

  % Data de puxamento: dd/mm/aaaa.

  % A rampa de temperatura do segundo puxamento é mostrada na Tab.~\ref{tab:puxamento2_fase2_rampa}.

  % \begin{table}[H]
  %   \centering
  %     \begin{tabular}{|c|c|} \hline
  %       \textbf{ [°C]} & \textbf{Tempo [min]} \\ \hline
  %       120 & 30 \\
  %       150 & 30 \\
  %       170 & 30 \\ 
  %       190 & 5 \\ 
  %       200 & 2 \\ \hline
  %     \end{tabular}
  %   \caption{Rampa de temperatura no forno da torre para o segundo puxamento.}
  %   \label{tab:puxamento2_fase2_rampa}
  % \end{table}

  % \subsection*{Resultados}
  % \label{subsec:puxamento2_resultados}

  % Comentários gerais dos resultados:
  % \begin{itemize}
  %   \item A foto das fibras catalogadas é mostrada na Fig.~ \ref{fig:puxamento2_fase2_resultados_catalogacao}.
  %   \item As micrografias das bandas ? são mostradas na Fig. ~\ref{fig:puxamento2_fase2_resultados_micrografias}.
  %   \item Os parâmetros de puxamento de cada banda estão organizados na Tab.~\ref{tab:puxamento2_fase2_resultados_parametros}.
  %   \item Os principais gráficos de fabricação gerados pela torre de polímero com todas as bandas juntas são mostrados em Fig.~\ref{fig:puxamento2_fase2_resultados_graficosjuntos}. 
  % \end{itemize}

  % \begin{figure}[H]
  %   \centering
  %   \includegraphics[scale=0.2]{}
  %   \caption{Fibras catalogadas.}
  %   \label{fig:puxamento2_fase2_resultados_catalogacao}
  % \end{figure}

  % \begin{figure}[H]
  %   \centering
  %   \begin{subfigure}{0.45\textwidth}
  %     \centering
  %     \includegraphics[scale=0.1]{}
  %     \caption{Banda ?.}
  %   \end{subfigure}
  %   \begin{subfigure}{0.45\textwidth}
  %     \centering
  %     \includegraphics[scale=0.1]{}
  %     \caption{Banda ?.}
  %   \end{subfigure}
  %   \caption{Micrografias das bandas ?.}
  %   \label{fig:puxamento2_fase2_resultados_micrografias}
  % \end{figure}

  % \begin{table}[H]
  %   \centering
  %     \begin{tabular}{|c|c|c|c|c|c|c|} \hline
  %       \textbf{Band} & $\mathbf{D_{ext} [\mu m]}$ & \textbf{T [°C]} & \textbf{P [mbar]} & $\mathbf{\tau [g]}$ & $\mathbf{\epsilon_{norm}}$ & $\mathbf{\epsilon_{geo}}$ \\ \hline
  %       ? & $ \pm  $ & $  \pm  $ & $  \pm  $ & $ \pm  $ & $ \pm  $ & $ \pm  $ \\
  %       ? & $ \pm $ & $ \pm $ & $ \pm $ & $ \pm $ & $ \pm  $ & $ \pm  $ \\ \hline
  %     \end{tabular}
  %   \caption{Parâmetros de puxamentos para bandas ?.}
  %   \label{tab:puxamento2_fase2_resultados_parametros}
  % \end{table}

  % \begin{figure}[H]
  %   \centering
  %   \begin{subfigure}{0.45\textwidth}
  %     \centering
  %     \includegraphics[scale=0.5]{}
  %     \caption{Pressão.}
  %   \end{subfigure}
  %   \hfill
  %   \begin{subfigure}{0.45\textwidth}
  %     \centering
  %     \includegraphics[scale=0.5]{}
  %     \caption{Tensão.}
  %   \end{subfigure}
  %   \begin{subfigure}{0.45\textwidth}
  %     \centering
  %     \includegraphics[scale=0.5]{}
  %     \caption{Diâmetro médio.}
  %   \end{subfigure}
  %   \caption{Principais gráficos dos parâmetros de puxamentos com todas bandas juntas.}
  %   \label{fig:puxamento2_fase2_resultados_graficosjuntos}
  % \end{figure}

\end{document}
