IPrearo/PPOFs/Relatorios de puxamento/PLT0079_HC4_eliptico_petg_translucido/relatorio.pdf

lafe_logo_ingles.jpg
Doc ID: PLT0079 Doc tipo: Relatório de fabricação PLT0079 Hollow-core elíptica (4 internos) - PETG translucido ´ Page 1 of ??

Descrição da participação dos envolvidos na fabricação desta fibra:

- Ivan Prearo: Fabricação e puxamento

# 1 Geometria e material

Comentários gerais sobre esta etapa:

- Pré-forma:

– Material: PETG esverdeado;

– Geometria da secção transversal: Hollow-core elíptica;

– Comprimento total: LT = 132mm;

– Comprimento útil: L = 100mm;

– Diâmetro externo: ϕout = 15mm

– Espessura do cladding: Lc = 3mm;

– Diâmetro dos capilares internos (eixo menor): ϕin = 3.98mm

– Espessura dos capilares internos: Lin = 0.6mm;

– Número de capilares internos: Nin = 3;

– Excentricidade dos capilares internos: ein = 2;

– Distância entre capilares internos¹
: Din = 0.2mm
– Raio do eixo maior de rin ≡ ein · ϕin/2 = 3.98mm;

– Razões entre medidas iniciais na Tabela ??

- Objetivo: Fabricação de fibra hollow-core com capilares elípticos e pressurização.
- O esquema da geometria da secção transversal e a foto da pré-forma são mostrados em Fig. ??.
Dimensão | Medida [mm] | Razão com ϕe
ϕout | 70 | 1
Lc | 12 | 0.171
ϕin | 9.6 | 0.137
Lin | 0.6 | 0.0086

Tabela 1: Relações entre medidas relevantes da preforma

1Essa distância é calculada como se os capilares internos fossem cilíndricos (ein = 1), no entanto a distância real é, em geral, maior do que a escrita aqui. Estout trabalhando para obter cálculos mais precisos.

© 2026 LaFE. All rights reserved. | Ultima data de revisão: 30/07/2026 ´

Doc ID: PLT0079 Doc tipo: Relatório de fabricação

Page 2 of ??

images/Secao_transversal.png

(a) Seção transversal da fibra.

images/Medidas_anotadas.png

(b) Medidas relevantes da estrutura.

Figura 1: Detalhamento da seção transversal da preforma.

Como um dos objetivos principais desse puxamento é a pressurização da amostra de acordo com a Figura ??. Para isso, a parte da preforma voltada à tampa de posicionamento foi fechada de acordo com a Figura ??, mantendo um volume aberto entre os capilares internos para que haja pressurização igual entre eles (Figs. ?? e ??).

Doc ID: PLT0079 Doc tipo: Relatório de fabricação

Page 3 of ??

images/Pressurizacao_anotada.png

(a) Seções de pressurização da fibra.

images/Secao_pressurizacao.png

(b) Tampa da preforma.

images/Vistas.png

(c) Vistas relevantes da preforma.

images/Vistas_anotadas.png

(d) Fig. ?? com anotações.

Figura 2: Detalhamento da seção transversal da preforma.

# 2 Puxamento

Comentários gerais sobre esse puxamento:

- Data de puxamento: 30/07/2026.
- A rampa de puxamento é mostrada na Tabela ??.
- O puxamento resultou em sucesso, produzindo dezenas de metros de fibra a diferentes condições de pressurização antes do rompimento.

O puxamento ocorreu normalmente até a estabilização razoável do diâmetro da fibra enquanto puxada no capstan, que inclui a banda lixo e de transição (Fig. ??). Após a

estabilidade no diâmetro, foram fabricadas três bandas com pressões incrementais, sendo

Doc ID: PLT0079 Doc tipo: Relatório de fabricação

Page 4 of ??

2, 3 e 4 mBar para as bandas A, B e C, respectivamente (Fig. ??). Durante a fabricação

da banda C, próximo ao alvo de pressurização, houve o rompimento da fibra.
Fase | [°C] Tempo [min]
Secagem | 60 | 60
| 80 | 20
Escoamento | 100 | 5
| 110 | 2
Puxamento | 120 | —

Tabela 2: Rampa de temperatura no forno da torre antes e durante o puxamento.

Graficos/Diametro.png

Figura 3: Diâmetro da fibra ao longo do puxamento.

Doc ID: PLT0079 Doc tipo: Relatório de fabricação

Page 5 of ??

Graficos/Pressao.png

Figura 4: Pressão na preforma ao longo do puxamento.

# 3 Resultados

Comentários gerais dos resultados:
- As medidas absolutas e relativas relevantes estão na Tabela ??.
- As micrografias das fibras produzidas estão na Figura ??.
E bastante notável que, de acordo com a Tabela ´ | ??, a excentricidade dos capilares

internos aumentam consistentemente com a pressão. No entanto, é necessário tomar tal informação com cautela, uma vez que a excentricidade dos capilares de uma mesma micrografia variam consideravelmente. No caso da banda C (Fig. ??), a menor excentricidade

encontrada foi 1.34, enquanto a maior foi 1.68. Mesmo com a excentricidade variando para valores inferiores aos sem aplicação de pressão, a média das excentricidades aumentar é significativo.

Doc ID: PLT0079 Doc tipo: Relatório de fabricação

Page 6 of ??

Também é importante manter em mente que os valores de excentricidade são calculados considerando uma elípse (como na Fig. ??), mas algumas micrografias mostram os capilares internos formando formatos mais circulares (Fig. ??), devido a tensão superficial

do PETG.

Medida | Inicial | Transição | Banda A | Banda B | Banda C
| Rel. | Abs. | Rel. | Abs. | Rel. | Abs. | Rel. | Abs. | Rel.
ϕout | 1.000 | 596 | 1.000 | 364 | 1.000 | 369 | 1.000 | 331 | 1.000
rin | 0.265 | 122 | 0.205 | 78.8 0.216 | 76.6 0.208 | 77.4 0.234
ϕin | 0.265 | 176 | 0.296 | 109 | 0.298 | 104 | 0.282 | 101 | 0.306
Lin | 0.040 | 54.8 0.090 | 30.0 0.083 | 34.9 0.095 | 26.3 0.079
Lc | 0.200 | 125 | 0.210 | 72.2 0.198 | 71.7 0.194 | 60.4 0.182
ein | 2.00 | 1.38 | — | 1.45 | — | 1.49 | — | 1.52 | —

Tabela 3: Medidas absolutas e relativas de cada banda para todas as grandezas relevantes. A medida de excentricidade não contém unidades, enquanto as outras medidas absolutas estão em µm.

Doc ID: PLT0079 Doc tipo: Relatório de fabricação

Page 7 of ??

Fotos/Banda_transicao.png

(a) Banda de transição.

Fotos/Banda_A.png

(b) Banda A.

Fotos/Banda_B.png

(c) Banda B.

Fotos/Banda_C.png

(d) Banda C.

Figura 5: Micrografias do final de cada banda.
