IPrearo/PPOFs/Relatorios de puxamento/PLT0077_HC3_eliptico_petg_esverdeado/Dados/Medidas.ods

Banda A |  |  |  |  |  |  | Banda B |  |  |  |  |  |  | Banda C |  |  |  |  |  |  | Banda de transição
Média | 363.97 | 78.78 | 108.61 | 30.05 | 72.16 | 1.45 | Média | 368.91 | 76.65 | 103.87 | 34.89 | 71.67 | 1.49 | Média | 331.37 | 77.40 | 101.30 | 26.31 | 60.35 | 1.52 | Média | 595.58 | 122.23 | 176.01 | 53.85 | 125.10 | 1.38
Medida relativa | 1.000 | 0.216 | 0.298 | 0.083 | 0.198 |  | Medida relativa | 1.000 | 0.208 | 0.282 | 0.095 | 0.194 |  | Medida relativa | 1.000 | 0.234 | 0.306 | 0.079 | 0.182 |  | Medida relativa | 1.000 | 0.205 | 0.296 | 0.090 | 0.210
 | D_out | r_in (a) | D_in (b) | L_in | L_c | Excentricidade |  | D_out | r_in (a) | D_in (b) | L_in | L_c | Excentricidade |  | D_out | r_in (a) | D_in (b) | L_in | L_c | Excentricidade |  | D_out | r_in (a) | D_in (b) | L_in | L_c | Excentricidade
 | 366.83 | 92.36 | 108.93 | 29.55 | 75.91 | 1.70 |  | 370.73 | 77.50 | 105.29 | 27.93 | 58.87 | 1.47 |  | 323.35 | 62.93 | 94.26 | 20.93 | 49.98 | 1.34 |  | 587.13 | 111.69 | 169.52 | 40.54 | 115.70 | 1.32
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
