IPrearo/PPOFs/Relatorios de puxamento/PLT0077_HC3_eliptico_petg_esverdeado/relatorio.pdf

Doc ID: PLT0077 Doc tipo: Relatório de fabricação PLT0077 Hollow-core elíptica (3 internos) - PETG esverdeado Page 1 of 6

Descrição da participação dos envolvidos na fabricação desta fibra:

- Ivan Prearo: Fabricação e puxamento

# 1 Geometria e material

Comentários gerais sobre esta etapa:

- Pré-forma:

– Material: PETG esverdeado;

– Geometria da secção transversal: Hollow-core elíptica;

– Comprimento total: LT = 132mm;

– Comprimento útil: L = 100mm;

– Diâmetro externo: ϕout = 15mm

– Espessura do cladding: Lc = 3mm;

– Diâmetro dos capilares internos (eixo menor): ϕin = 3.98mm

– Espessura dos capilares internos: Lin = 0.6mm;

– Número de capilares internos: Nin = 3;

– Excentricidade dos capilares internos: ein = 2;

– Distância entre capilares internos¹
: Din = 0.2mm
– Raio do eixo maior de rin ≡ ein · ϕin/2 = 3.98mm;

– Razões entre medidas iniciais na Tabela 1

- Objetivo: Fabricação de fibra hollow-core com capilares elípticos e pressurização.
- O esquema da geometria da secção transversal e a foto da pré-forma são mostrados em Fig. 1.
Dimensão | Medida [mm] | Razão com ϕe
ϕout | 70 | 1
Lc | 12 | 0.171
ϕin | 9.6 | 0.137
Lin | 0.6 | 0.0086

Tabela 1: Relações entre medidas relevantes da preforma

1Essa distância é calculada como se os capilares internos fossem cilíndricos (ein = 1), no entanto a distância real é, em geral, maior do que a escrita aqui. Estout trabalhando para obter cálculos mais precisos.

© 2026 LaFE. All rights reserved. | Ultima data de revisão: 30/07/2026 ´

Doc ID: PLT0077 Doc tipo: Relatório de fabricação

Page 2 of 6


(a) Seção transversal da fibra. | (b) Medidas relevantes da estrutura.

Figura 1: Detalhamento da seção transversal da preforma.

Como um dos objetivos principais desse puxamento é a pressurização da amostra de acordo com a Figura 2a. Para isso, a parte da preforma voltada à tampa de posicionamento foi fechada de acordo com a Figura 2b, mantendo um volume aberto entre os capilares internos para que haja pressurização igual entre eles (Figs. 2c e 2d).

Doc ID: PLT0077 Doc tipo: Relatório de fabricação

Page 3 of 6

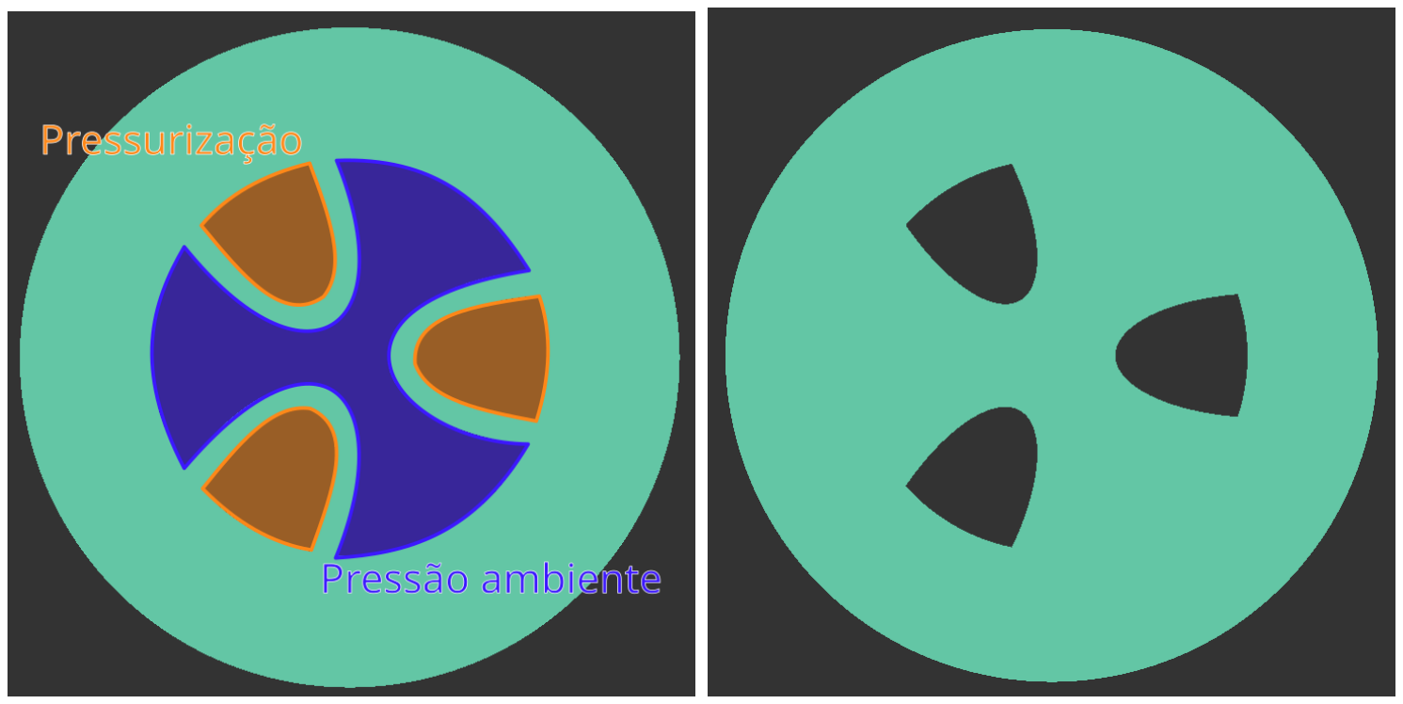
[picture p95: figure]

(a) Seções de pressurização da fibra. | (b) Tampa da preforma.

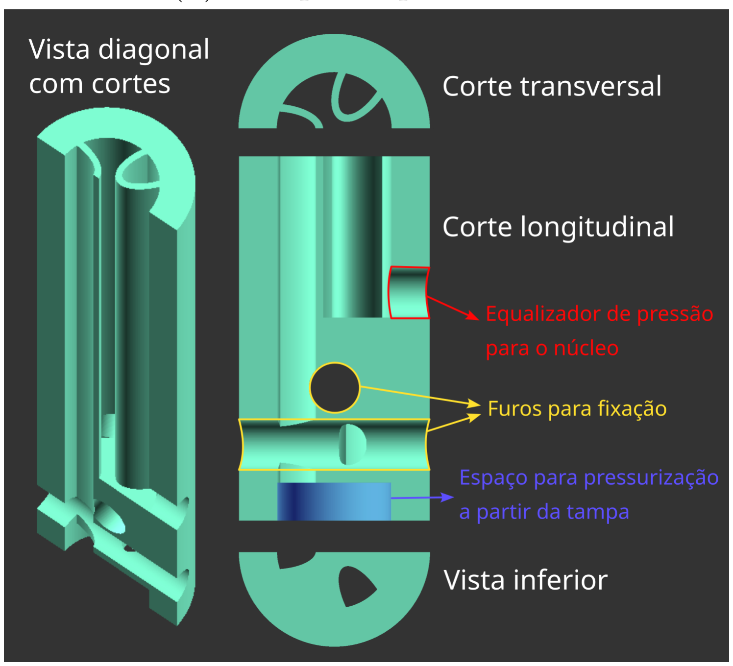
[picture p96: figure]

(c) Vistas relevantes da preforma. | (d) Fig. 2c com anotações.

Figura 2: Detalhamento da seção transversal da preforma.

# 2 Puxamento

Comentários gerais sobre esse puxamento:

- Data de puxamento: 30/07/2026.
- A rampa de puxamento é mostrada na Tabela 2.
- O puxamento resultou em sucesso, produzindo dezenas de metros de fibra a diferentes condições de pressurização antes do rompimento.

O puxamento ocorreu normalmente até a estabilização razoável do diâmetro da fibra enquanto puxada no capstan, que inclui a banda lixo e de transição (Fig. 3). Após a estabilidade no diâmetro, foram fabricadas três bandas com pressões incrementais, sendo

Doc ID: PLT0077 Doc tipo: Relatório de fabricação

Page 4 of 6

2, 3 e 4 mBar para as bandas A, B e C, respectivamente (Fig. 4). Durante a fabricação da banda C, próximo ao alvo de pressurização, houve o rompimento da fibra.
Fase | [°C] Tempo [min]
Secagem | 60 | 60
| 80 | 20
Escoamento | 100 | 5
| 110 | 2
Puxamento | 120 | —

Tabela 2: Rampa de temperatura no forno da torre antes e durante o puxamento.

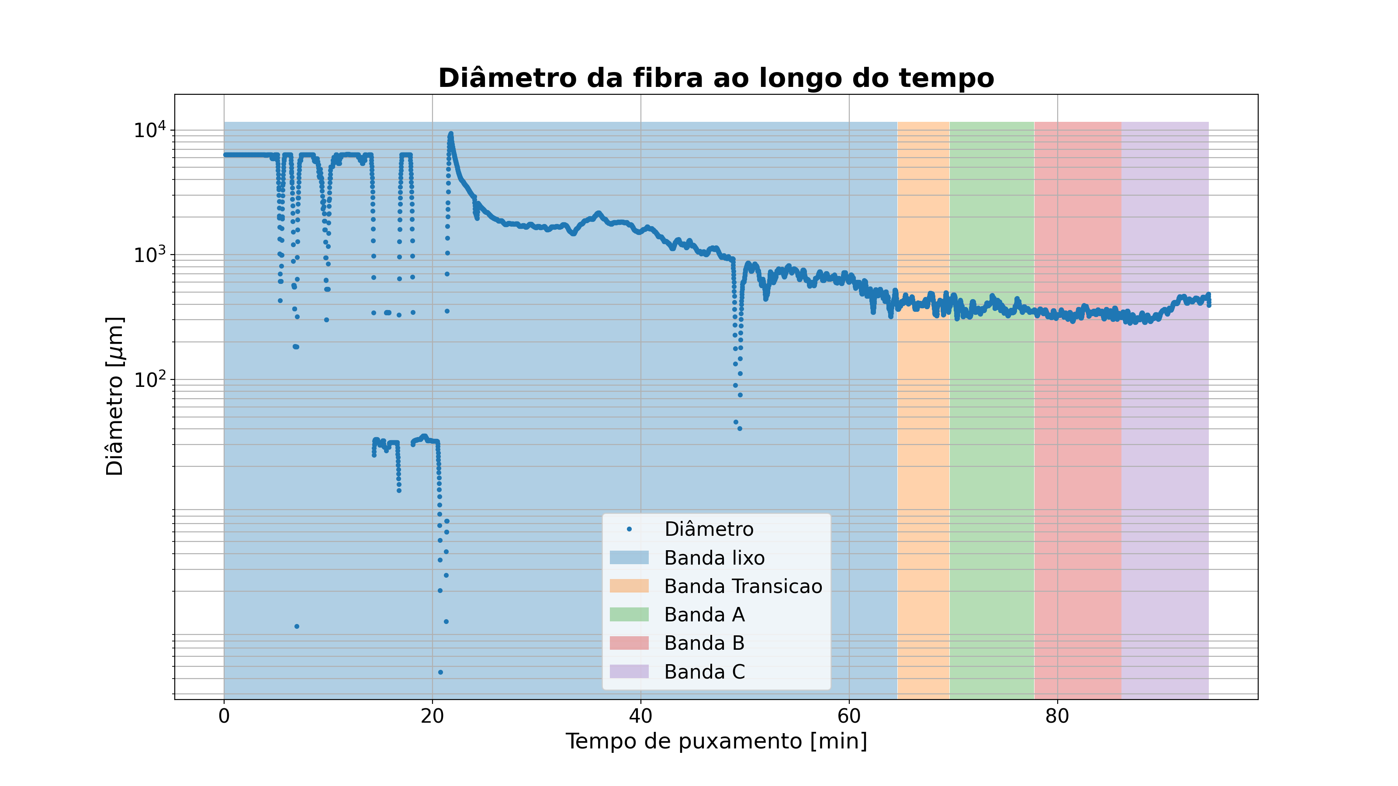
[picture p97: figure]

Figura 3: Diâmetro da fibra ao longo do puxamento.

Doc ID: PLT0077 Doc tipo: Relatório de fabricação

Page 5 of 6


Figura 4: Pressão na preforma ao longo do puxamento.

# 3 Resultados

Comentários gerais dos resultados:

- As medidas absolutas e relativas relevantes estão na Tabela 3.
- As micrografias das fibras produzidas estão na Figura 5.

E bastante notável que, de acordo com a Tabela 3, a excentricidade dos capilares ´ internos aumentam consistentemente com a pressão. No entanto, é necessário tomar tal informação com cautela, uma vez que a excentricidade dos capilares de uma mesma micrografia variam consideravelmente. No caso da banda C (Fig. 5d), a menor excentricidade encontrada foi 1.34, enquanto a maior foi 1.68. Mesmo com a excentricidade variando para valores inferiores aos sem aplicação de pressão, a média das excentricidades aumentar é significativo.
Também é importante manter em mente que os valores de excentricidade são calculados considerando uma elípse (como na Fig. 1b), mas algumas micrografias mostram os capilares internos formando formatos mais circulares (Fig. 5c), devido a tensão superficial do PETG.

Doc ID: PLT0077 Doc tipo: Relatório de fabricação

Page 6 of 6

Medida | Inicial | Transição | Banda A | Banda B | Banda C
| Rel. | Abs. | Rel. | Abs. | Rel. | Abs. | Rel. | Abs. | Rel.
ϕout | 1.000 | 596 | 1.000 | 364 | 1.000 | 369 | 1.000 | 331 | 1.000
rin | 0.265 | 122 | 0.205 | 78.8 0.216 | 76.6 0.208 | 77.4 0.234
ϕin | 0.265 | 176 | 0.296 | 109 | 0.298 | 104 | 0.282 | 101 | 0.306
Lin | 0.040 | 54.8 0.090 | 30.0 0.083 | 34.9 0.095 | 26.3 0.079
Lc | 0.200 | 125 | 0.210 | 72.2 0.198 | 71.7 0.194 | 60.4 0.182
ein | 2.00 | 1.38 | — | 1.45 | — | 1.49 | — | 1.52 | —

Tabela 3: Medidas absolutas e relativas de cada banda para todas as grandezas relevantes. A medida de excentricidade não contém unidades, enquanto as outras medidas absolutas estão em µm.

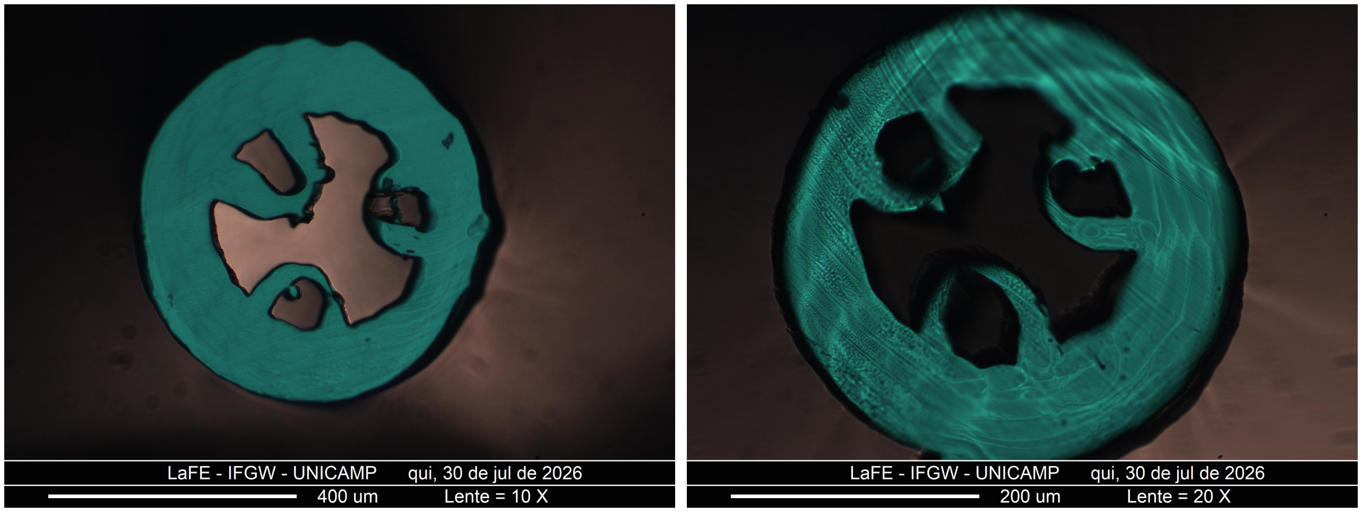
[picture p98: figure]

(a) Banda de transição. | (b) Banda A.

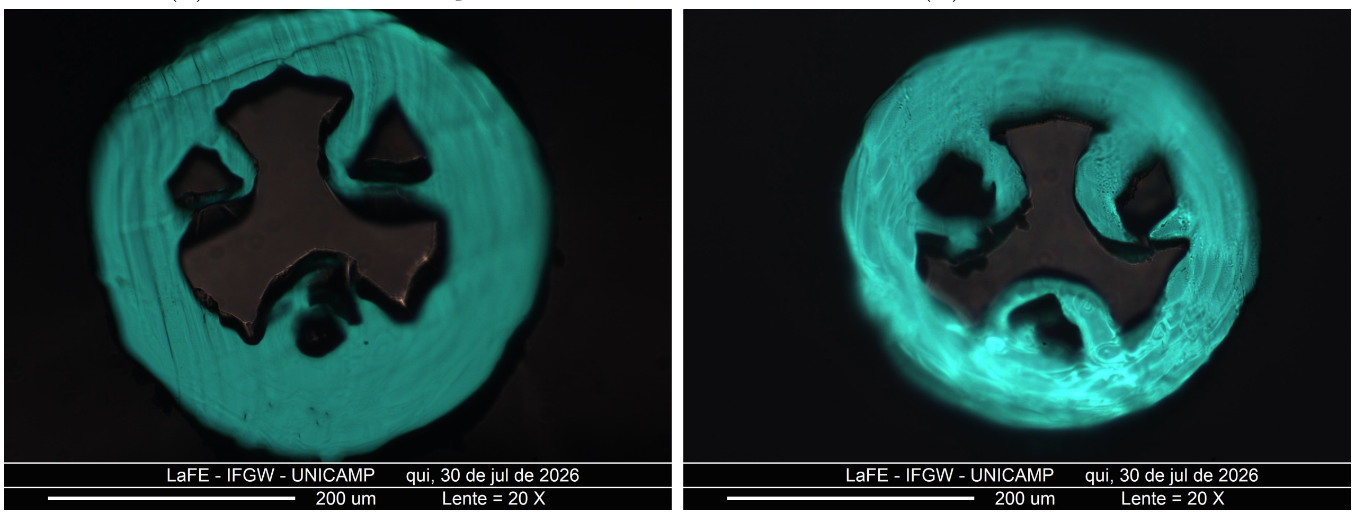
[picture p99: figure]

(c) Banda B. | (d) Banda C.

Figura 5: Micrografias do final de cada banda.
