IPrearo/PPOFs/Relatorios de puxamento/PLT0074_HC3_petg_esverdeado_fdm/relatorio.pdf

Doc ID: PLT0074 Doc tipo: Relatório de fabricação

PLT0074 Suspended core em PETG esverdeado Page 1 of 4
Descrição da participação dos envolvidos na fabricação desta fibra:
- Ivan Prearo: Fabricação e puxamento

# Puxamento

Este puxamento é de uma preforma do tipo hollow-core com dimensões mostradas na Tabela 1, com a notação de cada dimensão mostrada na Fig 1b. A preforma é mostrada na Figura 1c, e tem microestrutura hollow-core da Figura 1a.

## Medida Medida absoluta [mm] Medida relativa

ϕout | 15 | 1.000
Lout | 2.5 | 0.167
ϕin | 1.45 | 0.097
Lin | 0.6 | 0.040
dint | 1 | 0.067

Tabela 1: Medidas na preforma.

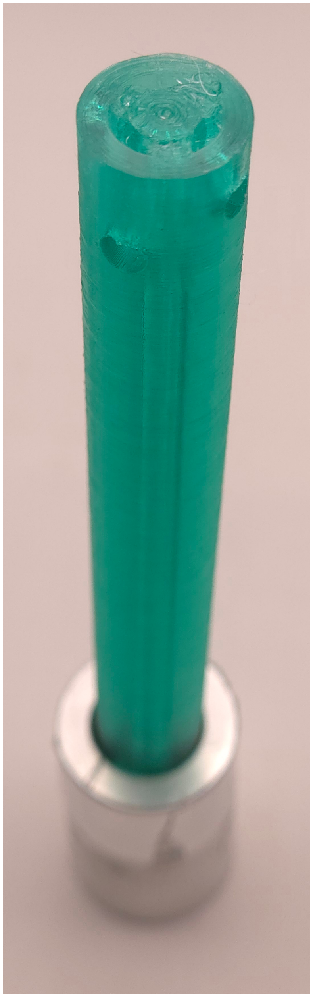
[picture p100: figure]

(a) Seção transversal da preforma. | (b) Dimensões especificadas. | (c) Preforma.

Figura 1: Especificações da microestrutura desenhada. Desenhos em escala.

Para realizar o puxamento utilizamos a rampa de temperatura descrita na Tabela 2.

© 2026 LaFE. All rights reserved. | Ultima data de revisão: 17/07/2026 ´

Doc ID: PLT0074 Doc tipo: Relatório de fabricação

Page 2 of 4
Fase | [°C] Tempo [min]
Secagem | 60 | 60
| 80 | 15
Escoamento | 100 | 5
| 110 | 2
Puxamento | 120 | 15
| 123 | –
Puxamento (Capstan) 120 | –

Tabela 2: Rampa de temperatura no forno da torre antes e durante o puxamento.

# Resultados

Foram produzidos cerca de 17 metros de fibra com diâmetro externo entre 1 mm e 0.2 mm (Fig. 2). Realizamos algumas microscopias para verificar a proporção da microestrutura na fibra final. Para isso, medimos as dimensões de cada atributo da fibra a fim de calcular a razão entre elas (Figura 3). Ambas as micrografias da Figura 3 são da banda A, uma vez que o diâmetro da fibra na banda B era demasiado pequeno e não permitia clivagens razoáveis (Fig. 4). Ainda, a microestrutura na fibra produzida estava irregular e portanto tomamos médias de diversas medições na mesma micrografia; por exemplo, medimos os diâmetros e larguras dos três capilares internos. Os diâmetros da fibra ao longo da fabricação estão graficados na Figura 5.

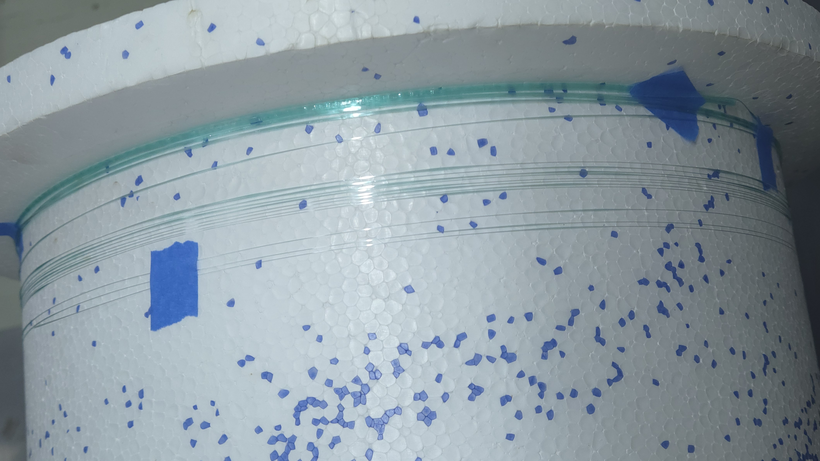
[picture p101: figure]

(a) Resultados avulsos do puxamento. | (b) Resultados do puxamento no drum winder.

Figura 2: Resultados do puxamento.

Doc ID: PLT0074 Doc tipo: Relatório de fabricação

Page 3 of 4

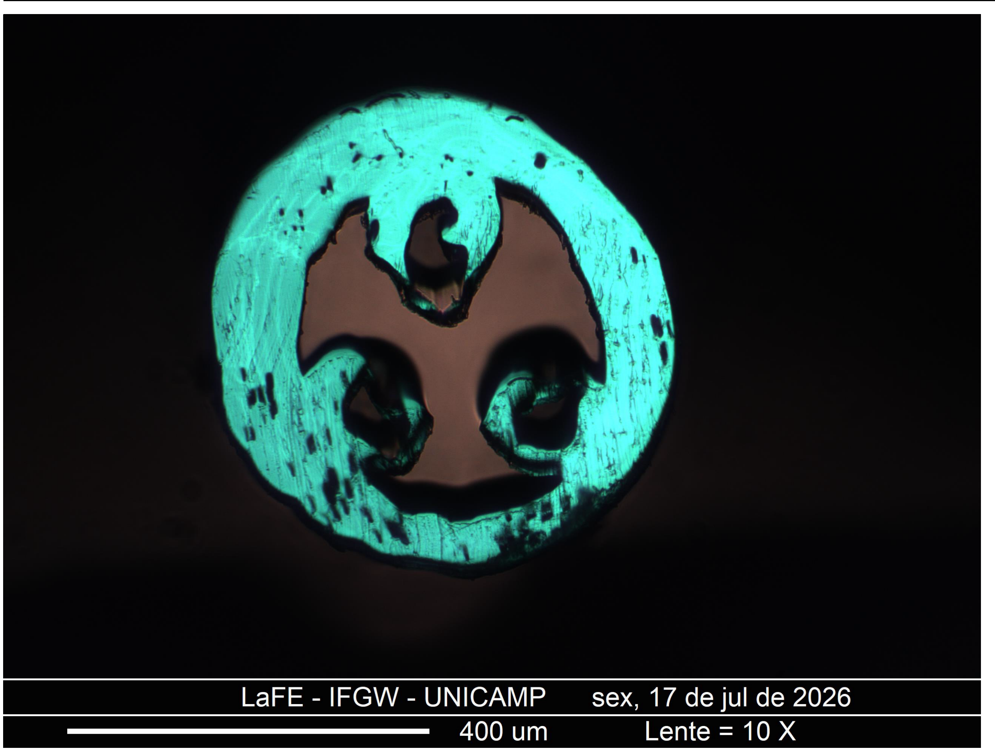
[picture p102: figure]
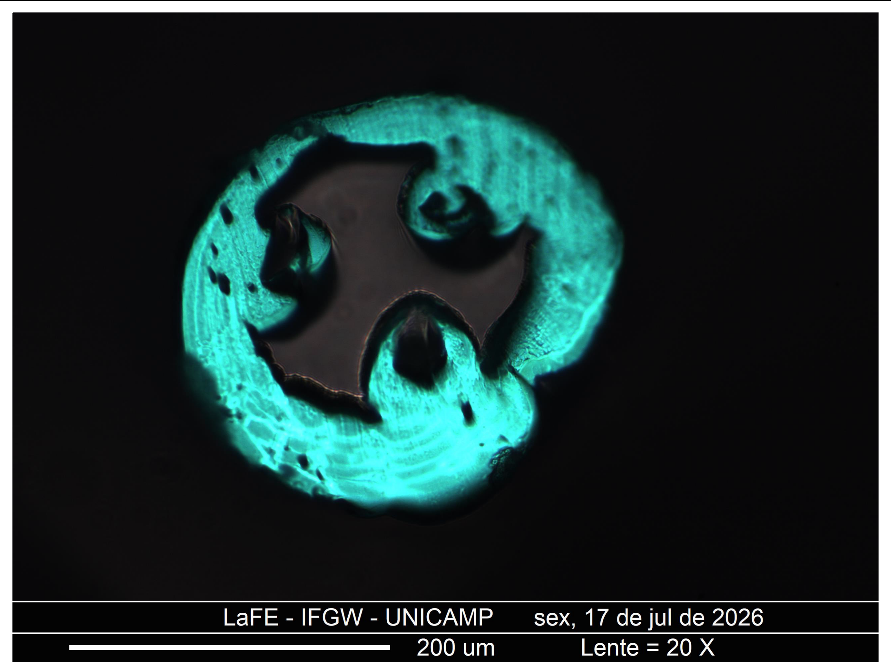
[picture p103: figure]

(a) Micrografia M1. | (b) Micrografia M2.

Figura 3: Micrografias da banda A.

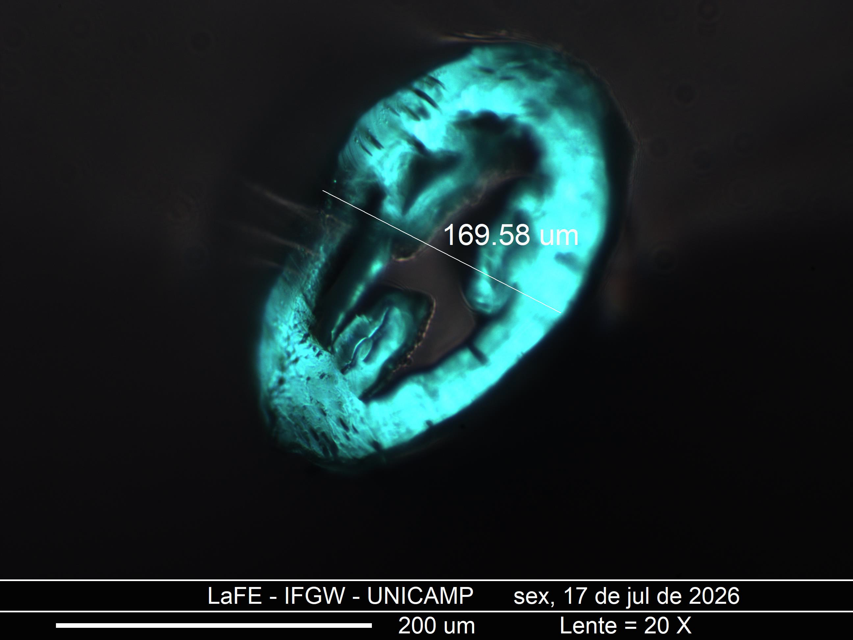
[picture p104: figure]

Figura 4: Micrografia da banda B.

Medida | Medidas relativas
| Inicial | M1 | M2
ϕout | 1.000 | 1.0000 | 1.0000
Lout | 0.167 | 0.195 | 0.197
ϕin | 0.097 | 0.262 | 0.257
Lin | 0.040 | 0.086 | 0.077
dint | 0.067 | 0.128 | 0.131

Tabela 3: Medidas na fibra produzida.

Doc ID: PLT0074 Doc tipo: Relatório de fabricação

Page 4 of 4

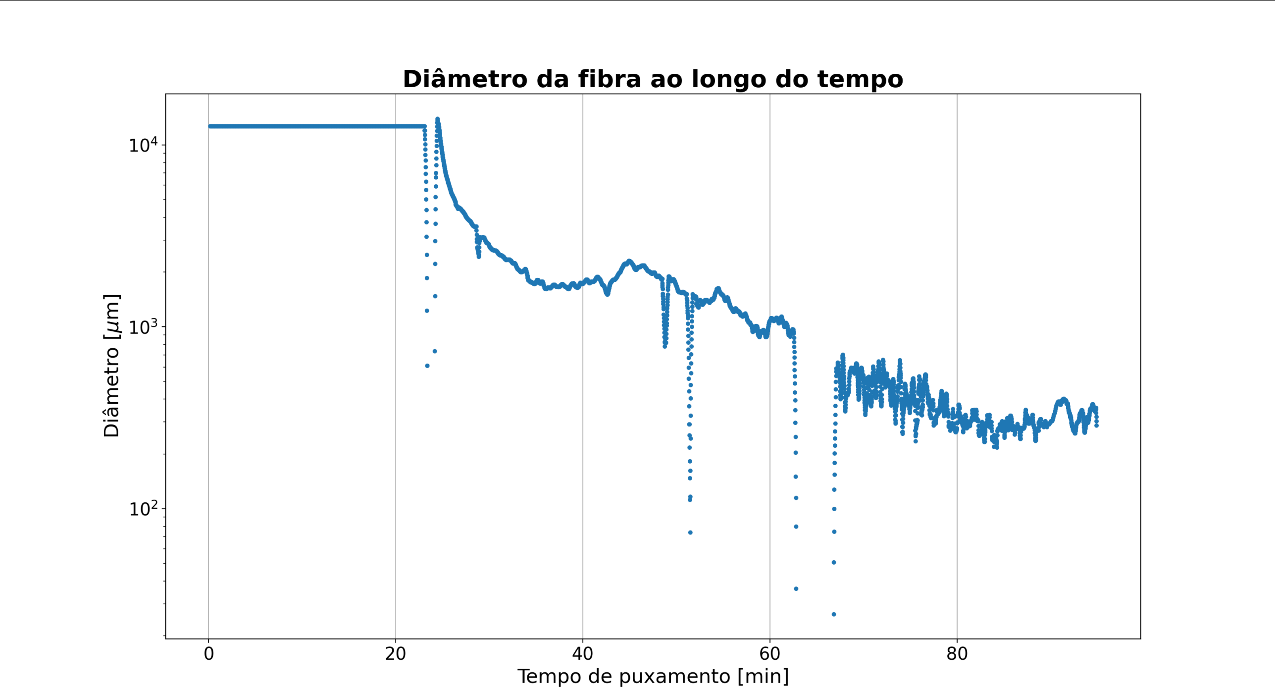
[picture p105: figure]

Figura 5: Diâmetro medido no Zumbach ao longo do puxamento.
