IPrearo/PPOFs/Codigos/Plot_dados_puxamento/Graficos/Desvio_vel_e_diam.png

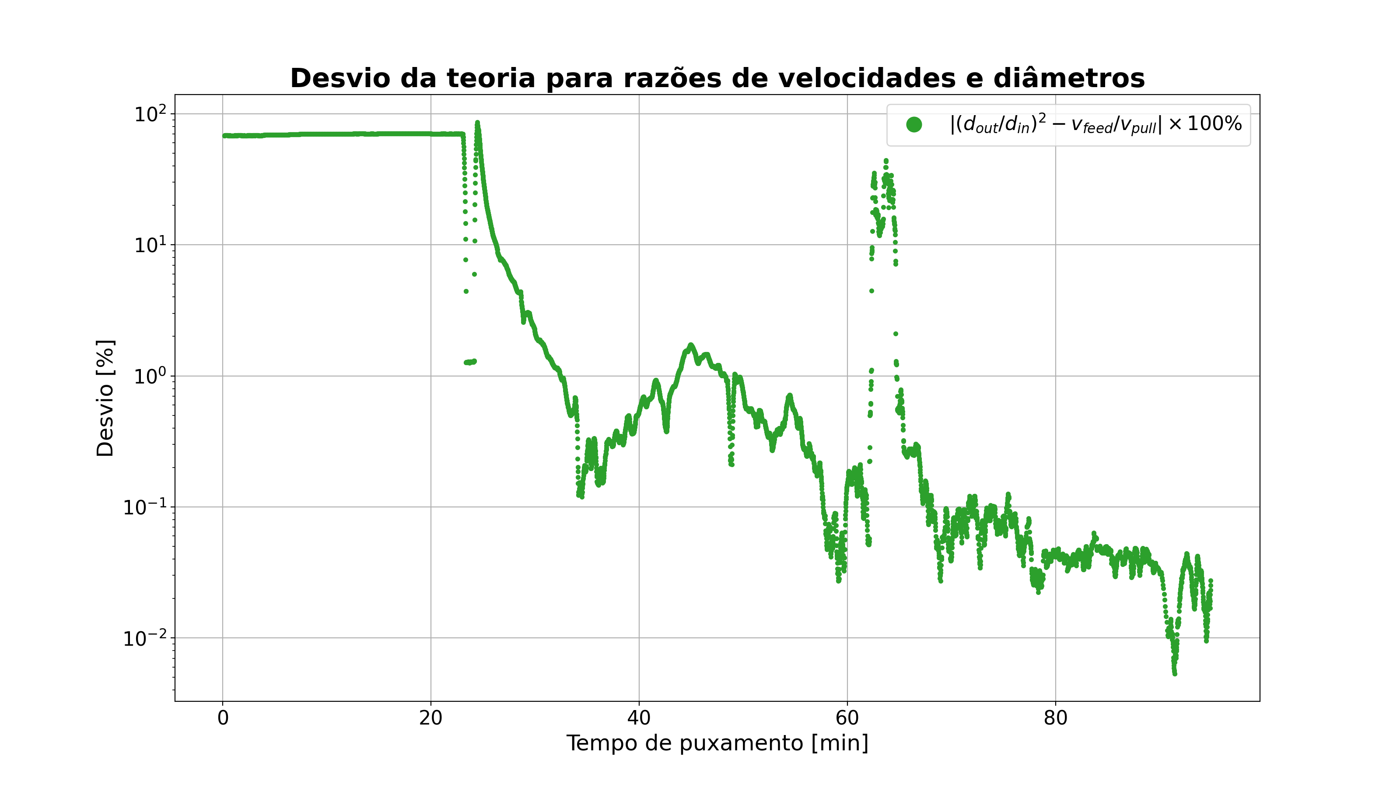
Codigos/Plot_dados_puxamento/Graficos/Desvio_vel_e_diam.png
