IPrearo/PPOFs/Codigos/Plot_dados_puxamento/Graficos/Diametro.png

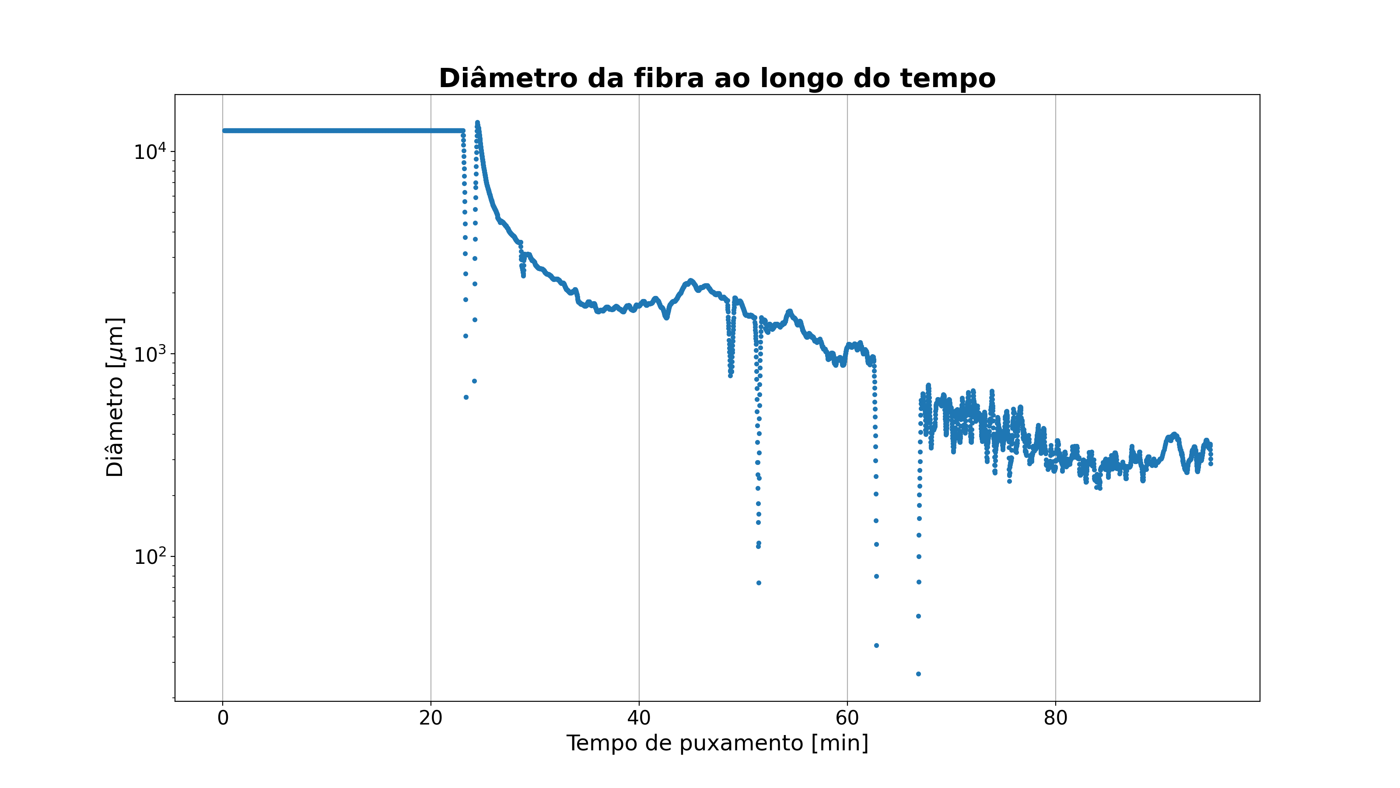
Codigos/Plot_dados_puxamento/Graficos/Diametro.png
