IPrearo/PPOFs/Codigos/Plot_dados_puxamento/Graficos/Razoes_vel_e_diam.png

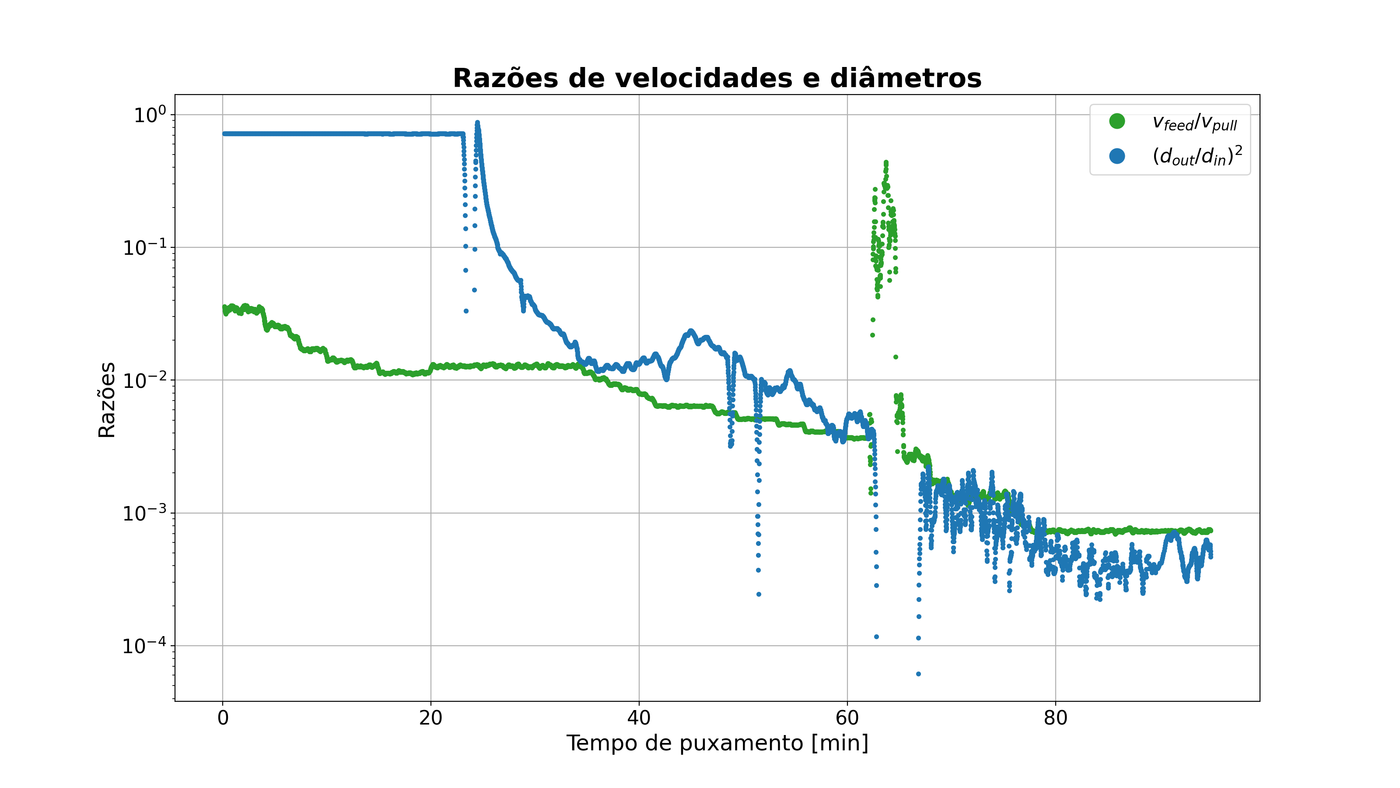
Codigos/Plot_dados_puxamento/Graficos/Razoes_vel_e_diam.png
