IPrearo/PPOFs/Codigos/Plot_dados_puxamento/Graficos/Temperatura.png

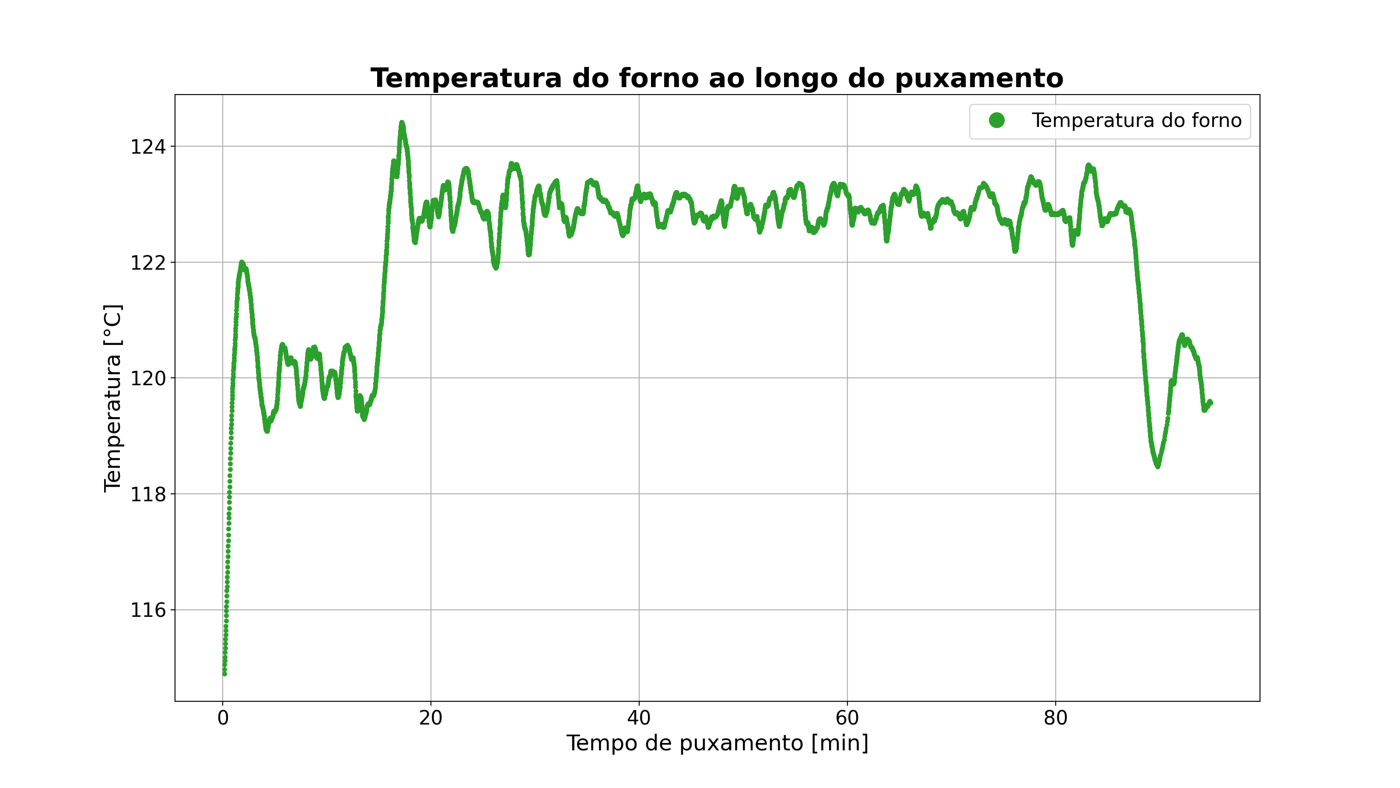
Codigos/Plot_dados_puxamento/Graficos/Temperatura.png
