IPrearo/PPOFs/Codigos/Plot_dados_puxamento/Graficos/Velocidade_e_diametro.png

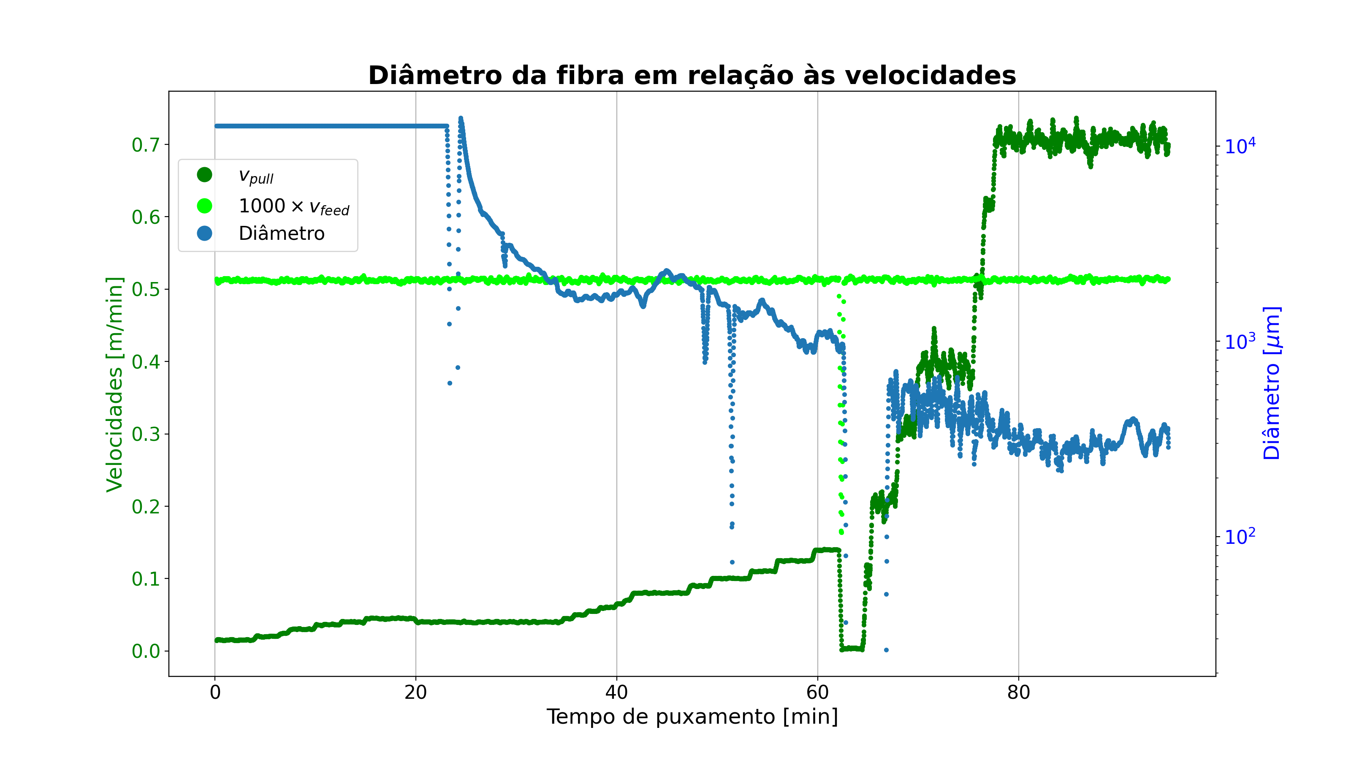
Codigos/Plot_dados_puxamento/Graficos/Velocidade_e_diametro.png
