IPrearo/PPOFs/Codigos/Plot_dados_puxamento/Graficos/Velocidades.png

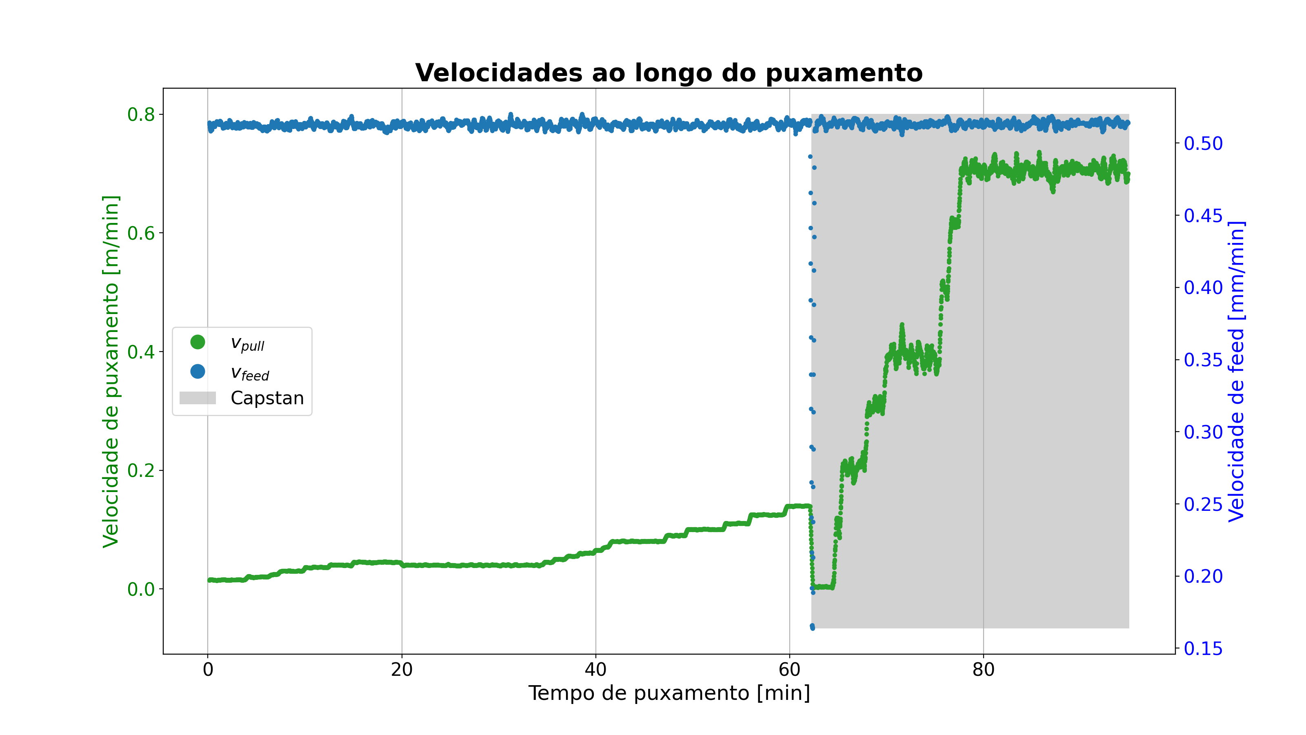
Codigos/Plot_dados_puxamento/Graficos/Velocidades.png
