IPrearo/PPOFs/Relatorios de puxamento/PLT0015_suspended_core_petghf_vermelho_fdm/puxamento/preforma_dimensoes.jpg

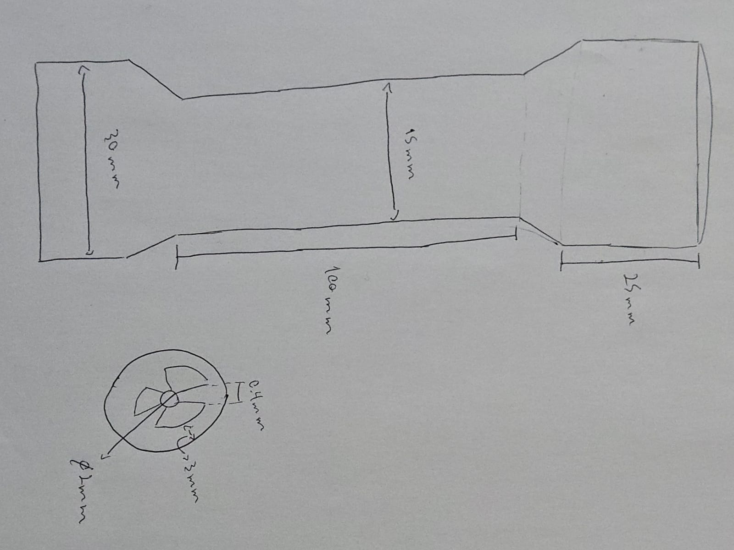
Relatorios de puxamento/PLT0015_suspended_core_petghf_vermelho_fdm/puxamento/preforma_dimensoes.jpg
