IPrearo/PPOFs/Relatorios de puxamento/PLT0019_no_core_petghf_vermelho_fdm/puxamento/degraus.jpg

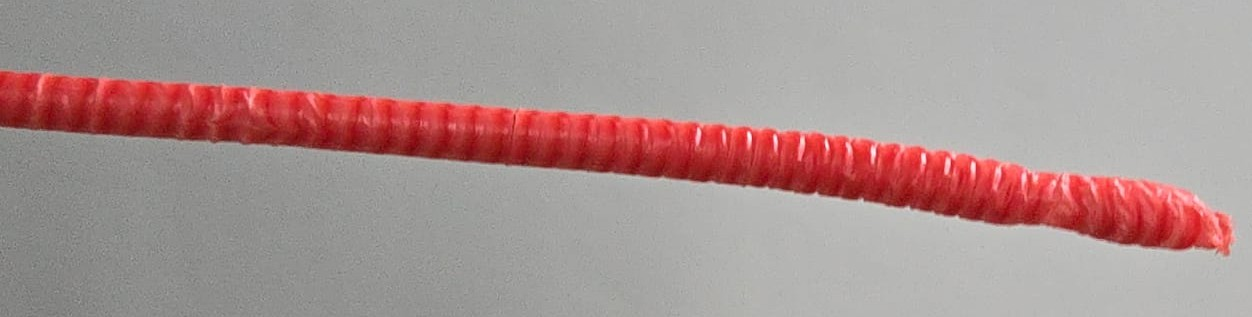
Relatorios de puxamento/PLT0019_no_core_petghf_vermelho_fdm/puxamento/degraus.jpg
