IPrearo/PPOFs/Relatorios de puxamento/PLT0021_no_core_petghf_vermelho_fdm/puxamento/ponto_de_falha.jpeg

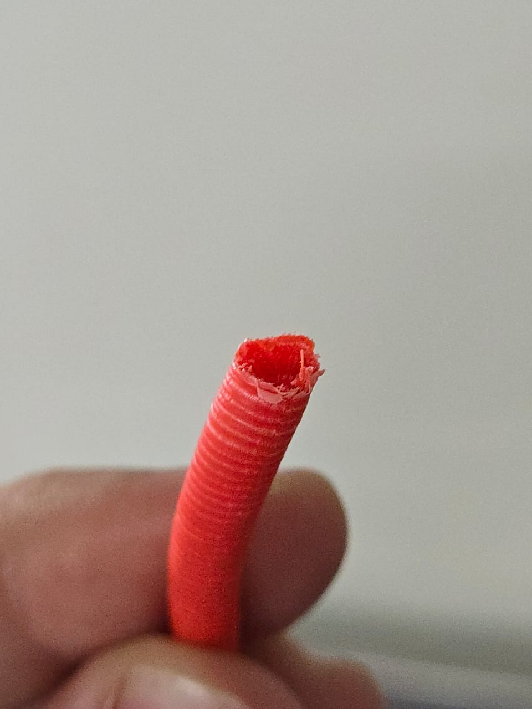
Relatorios de puxamento/PLT0021_no_core_petghf_vermelho_fdm/puxamento/ponto_de_falha.jpeg
