IPrearo/PPOFs/Relatorios de puxamento/PLT0021_no_core_petghf_vermelho_fdm/puxamento/preforma.jpg

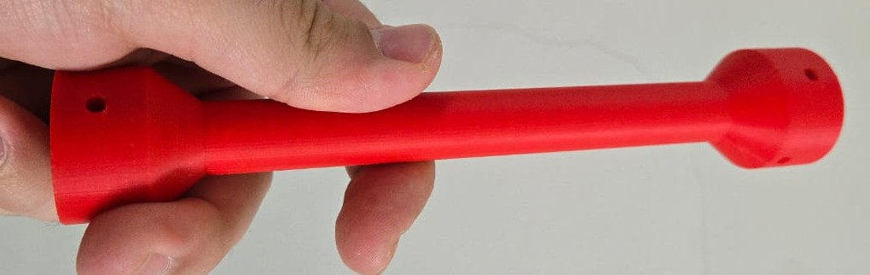
Relatorios de puxamento/PLT0021_no_core_petghf_vermelho_fdm/puxamento/preforma.jpg
