IPrearo/PPOFs/Relatorios de puxamento/PLT0028_no_core_petghf_vermelho_fdm/puxamento/PLT0028_separation_comparison.jpeg

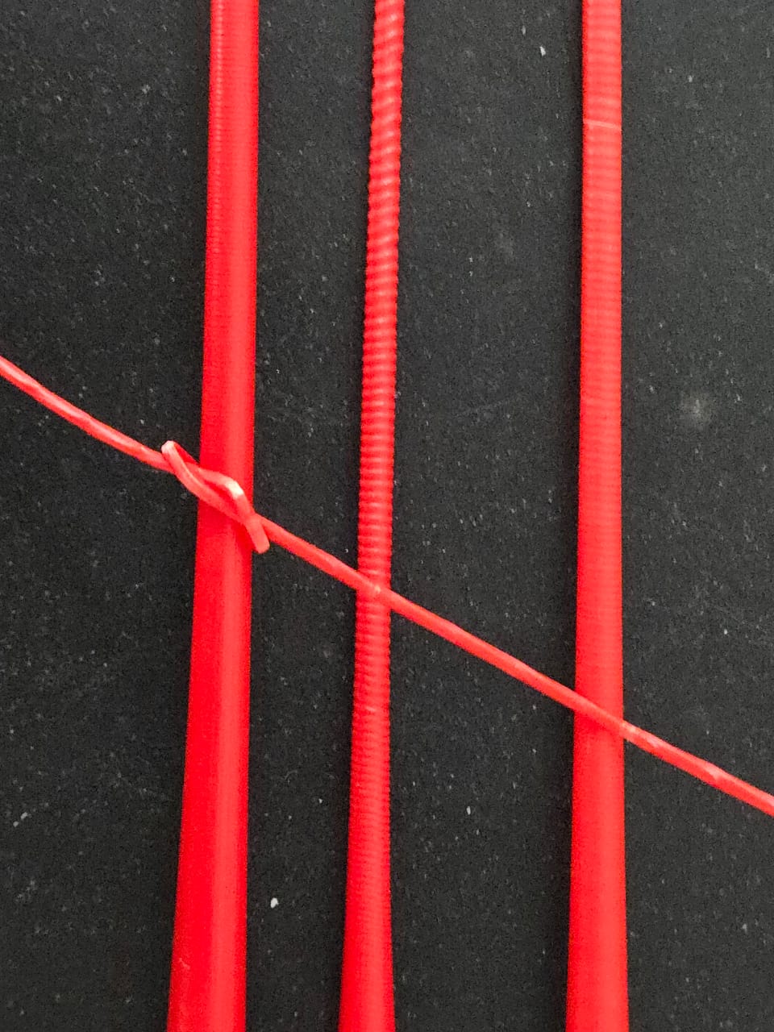
Relatorios de puxamento/PLT0028_no_core_petghf_vermelho_fdm/puxamento/PLT0028_separation_comparison.jpeg
