IPrearo/PPOFs/Relatorios de puxamento/PLT0029_no_core_petg_esverdeado_fdm/microscopia/130um_reflexao.png

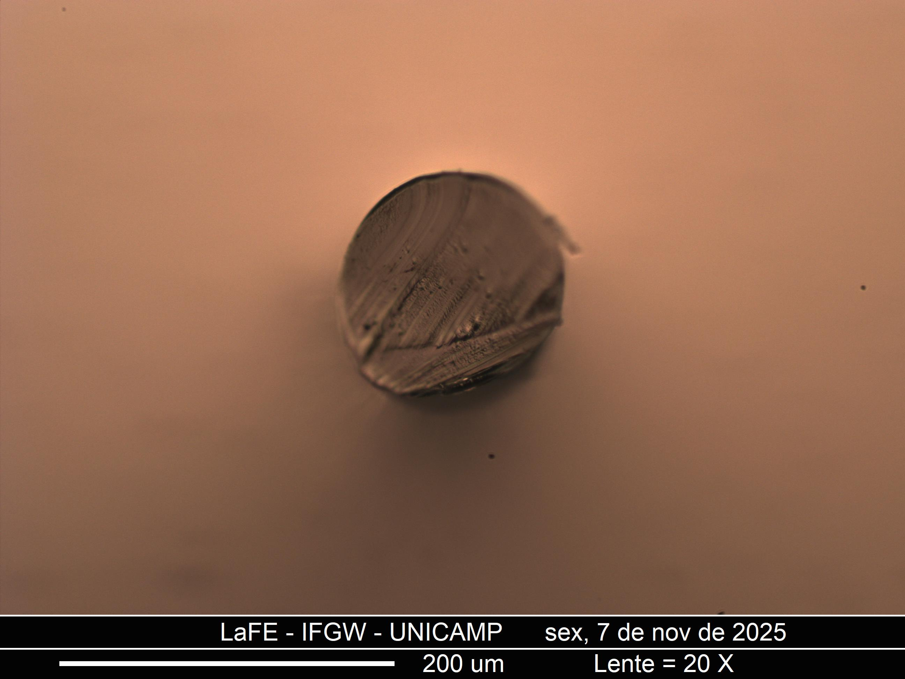
Relatorios de puxamento/PLT0029_no_core_petg_esverdeado_fdm/microscopia/130um_reflexao.png
