IPrearo/PPOFs/Relatorios de puxamento/PLT0029_no_core_petg_esverdeado_fdm/puxamento/cabeca_preforma.jpg

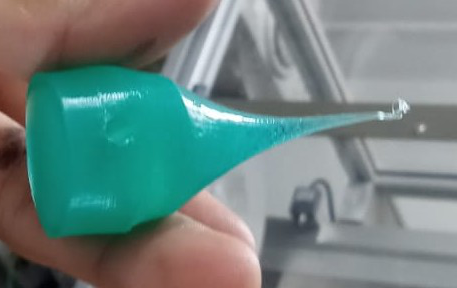
Relatorios de puxamento/PLT0029_no_core_petg_esverdeado_fdm/puxamento/cabeca_preforma.jpg
