IPrearo/PPOFs/Relatorios de puxamento/PLT0029_no_core_petg_esverdeado_fdm/puxamento/inicio_puxamento.jpg

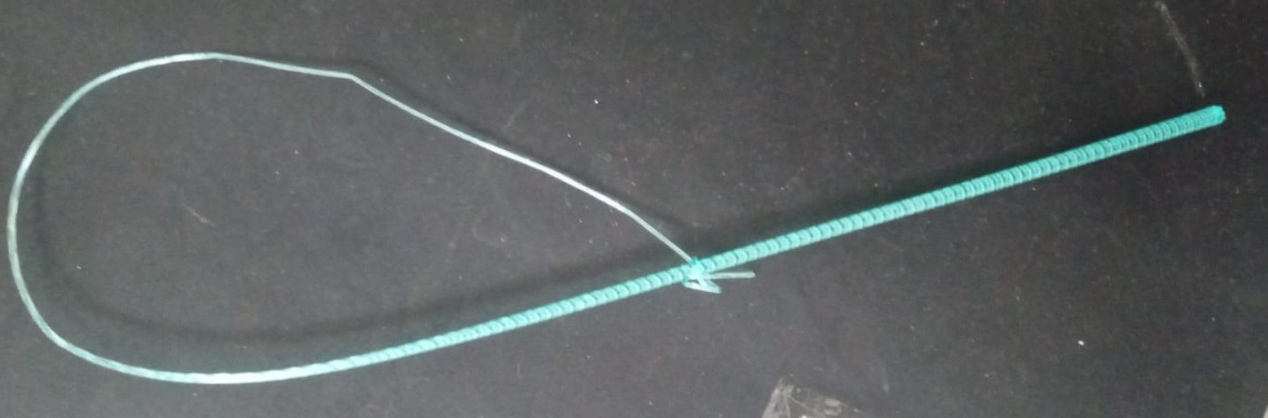
Relatorios de puxamento/PLT0029_no_core_petg_esverdeado_fdm/puxamento/inicio_puxamento.jpg
