IPrearo/PPOFs/Relatorios de puxamento/PLT0029_no_core_petg_esverdeado_fdm/puxamento/preforma_entortou.jpg

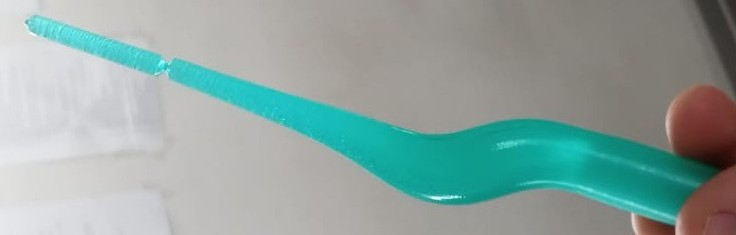
Relatorios de puxamento/PLT0029_no_core_petg_esverdeado_fdm/puxamento/preforma_entortou.jpg
