IPrearo/PPOFs/Relatorios de puxamento/PLT0030_no_core_petghf_vermelho_fdm/microscopia/CS1_foto.png

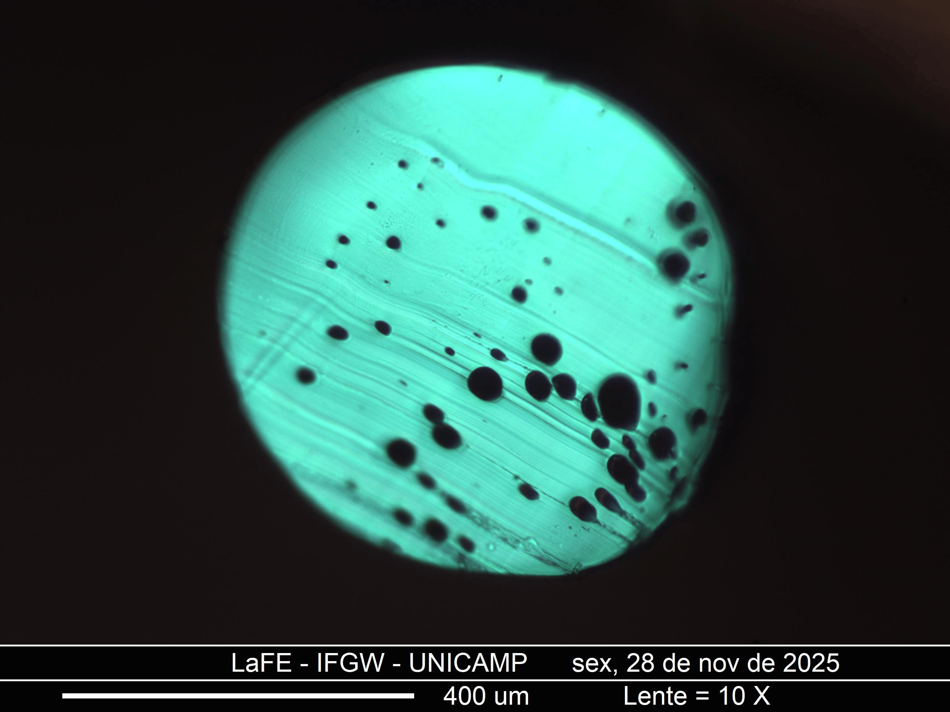
Relatorios de puxamento/PLT0030_no_core_petghf_vermelho_fdm/microscopia/CS1_foto.png
