IPrearo/PPOFs/Relatorios de puxamento/PLT0030_no_core_petghf_vermelho_fdm/microscopia/CS2_diam1.png

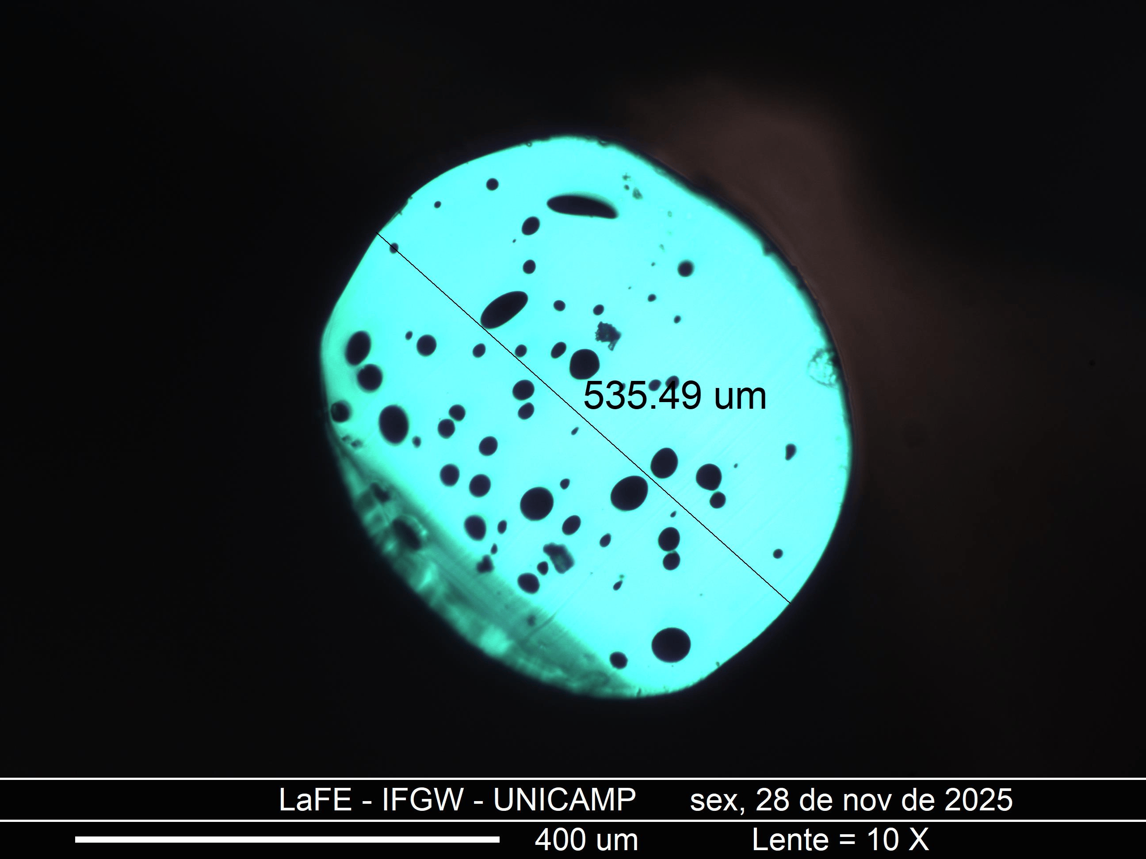
Relatorios de puxamento/PLT0030_no_core_petghf_vermelho_fdm/microscopia/CS2_diam1.png
