IPrearo/PPOFs/Relatorios de puxamento/PLT0038_no_core_petg_translucido_fdm/microscopia/Secao_espessa_medida.png

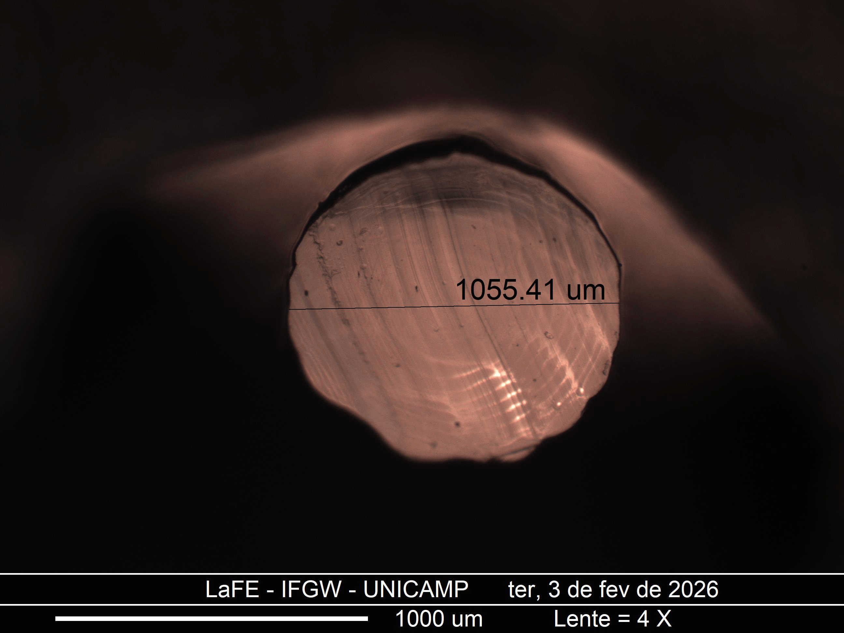
Relatorios de puxamento/PLT0038_no_core_petg_translucido_fdm/microscopia/Secao_espessa_medida.png
