IPrearo/PPOFs/Relatorios de puxamento/PLT0038_no_core_petg_translucido_fdm/microscopia/Secao_fina.png

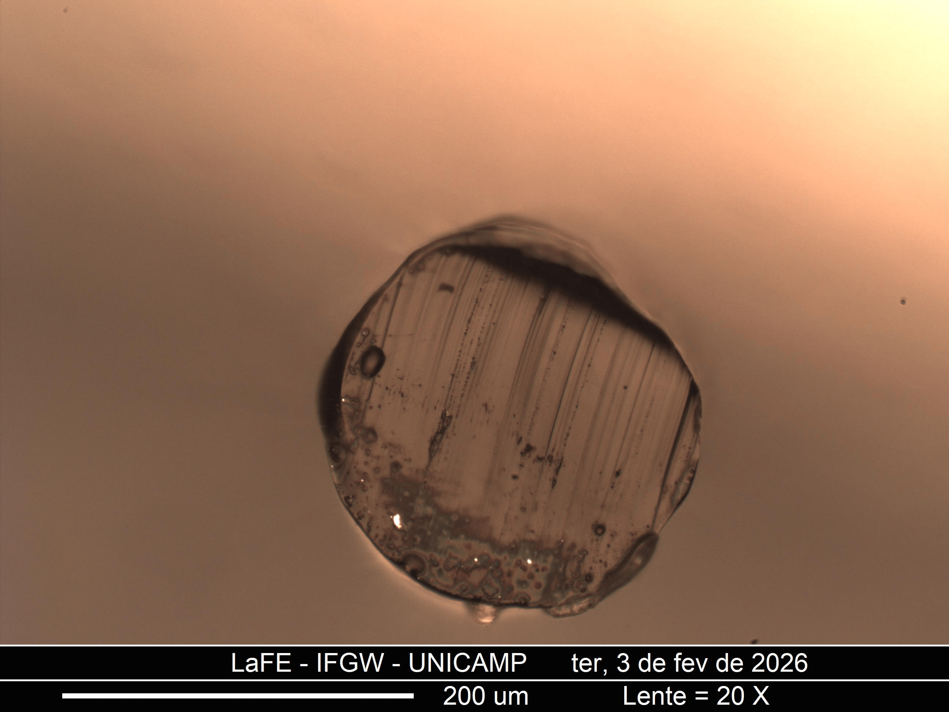
Relatorios de puxamento/PLT0038_no_core_petg_translucido_fdm/microscopia/Secao_fina.png
