IPrearo/PPOFs/Relatorios de puxamento/PLT0065_suspended_core_petg_esverdeado_fdm/images/Total.jpg

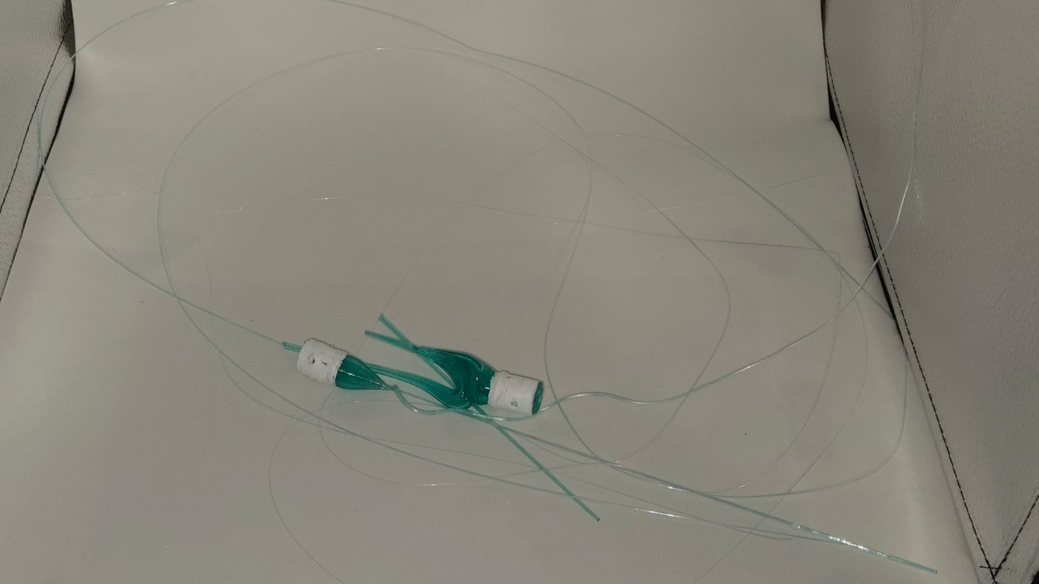
Relatorios de puxamento/PLT0065_suspended_core_petg_esverdeado_fdm/images/Total.jpg
