IPrearo/PPOFs/Relatorios de puxamento/PLT0072_suspended_core_petg_esverdeado_fdm/images/Fibra 1mm.jpeg

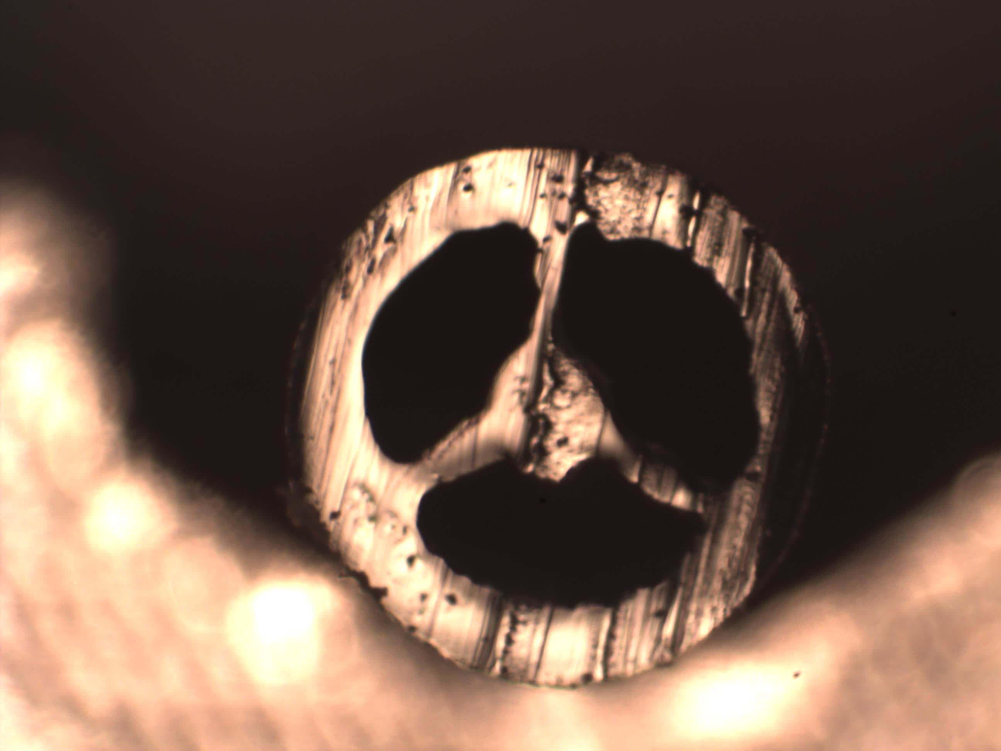
Relatorios de puxamento/PLT0072_suspended_core_petg_esverdeado_fdm/images/Fibra 1mm.jpeg
