IPrearo/PPOFs/Relatorios de puxamento/PLT0074_HC3_petg_esverdeado_fdm/images/Preforma.jpeg

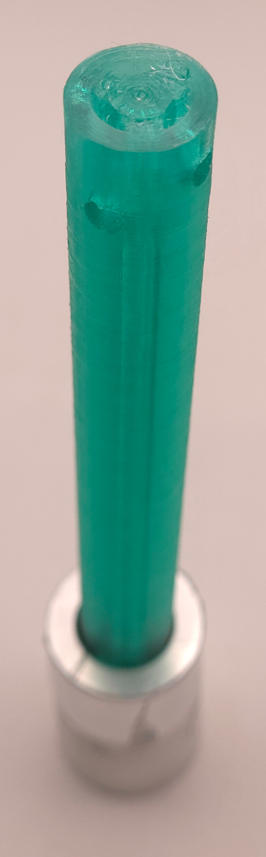
Relatorios de puxamento/PLT0074_HC3_petg_esverdeado_fdm/images/Preforma.jpeg
