IPrearo/PPOFs/Relatorios de puxamento/PLT0077_HC3_eliptico_petg_esverdeado/images/Cortes_long_trans_visao_diagonal.png

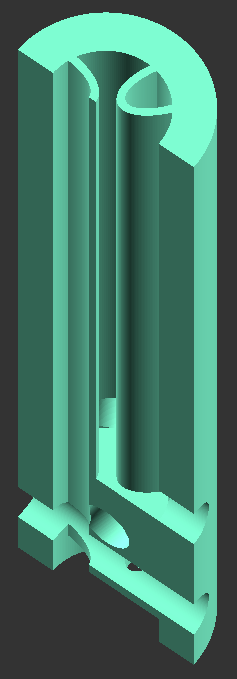
Relatorios de puxamento/PLT0077_HC3_eliptico_petg_esverdeado/images/Cortes_long_trans_visao_diagonal.png
