IPrearo/PPOFs/Relatorios de puxamento/PLT0077_HC3_eliptico_petg_esverdeado/images/Secao_longitudinal_zoom.png

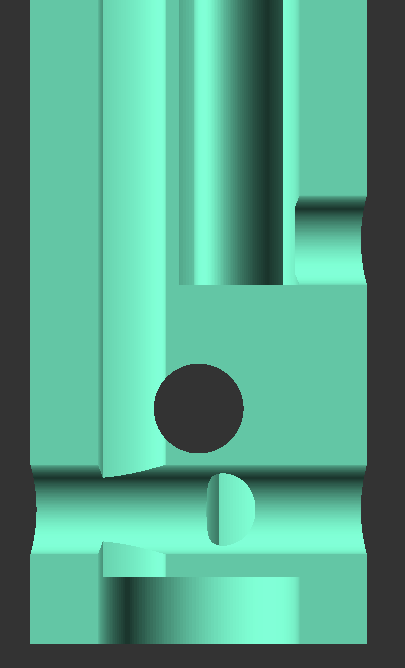
Relatorios de puxamento/PLT0077_HC3_eliptico_petg_esverdeado/images/Secao_longitudinal_zoom.png
