IPrearo/PPOFs/Relatorios de puxamento/PLT0080_staircase_core_petg_translucido/images/Banda_B.png

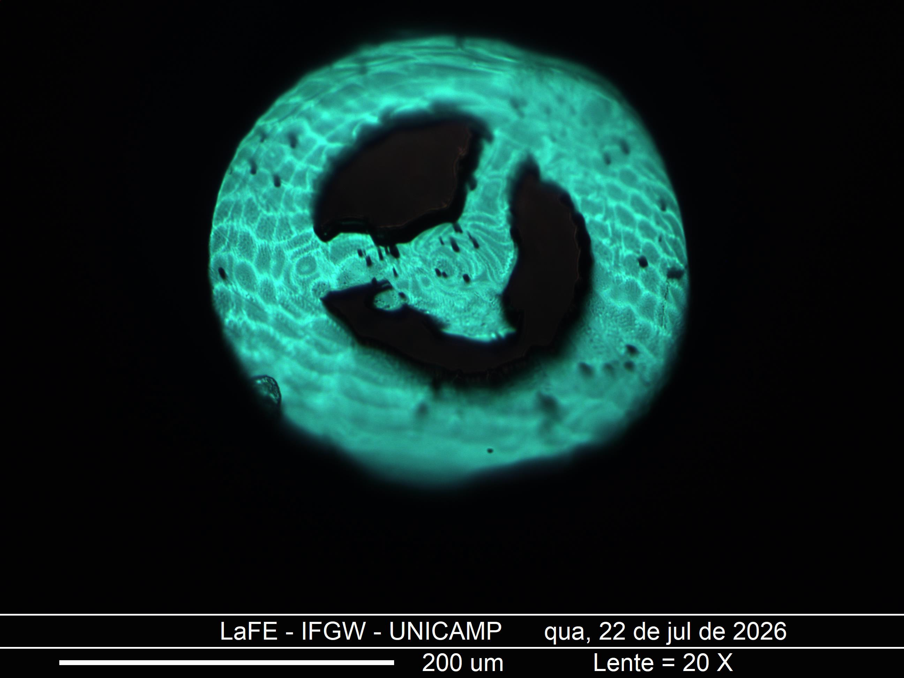
Relatorios de puxamento/PLT0080_staircase_core_petg_translucido/images/Banda_B.png
