IPrearo/PPOFs/Relatorios de puxamento/PLT0080_staircase_core_petg_translucido/images/Preforma.jpeg

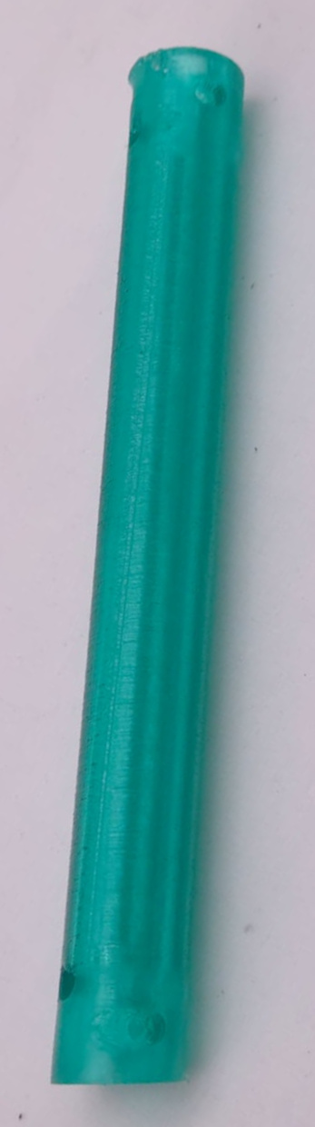
Relatorios de puxamento/PLT0080_staircase_core_petg_translucido/images/Preforma.jpeg
