IPrearo/PPOFs/Modelos de fibra/Staircase-core/Staircase-core/Staircase-core_0deg.3mf

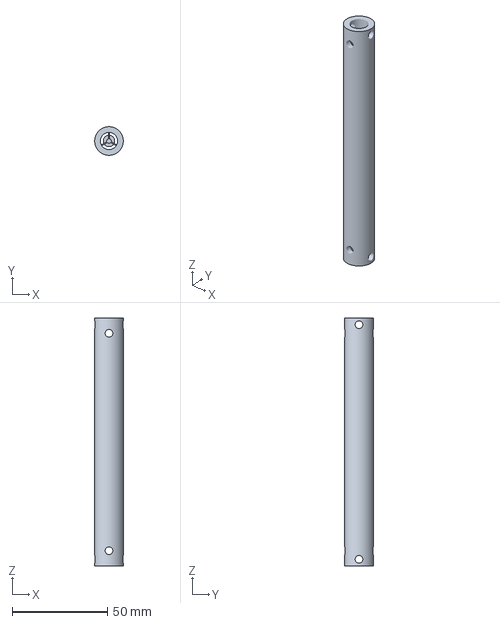
[picture p143: CAD file, 2026-08-21]
Modelos de fibra/Staircase-core/Staircase-core/Staircase-core_0deg.3mf
15.0 x 15.0 x 130.0 mm
