IPrearo/PPOFs/Modelos de fibra/Staircase-core/Tests/RSC_direction_test.3mf

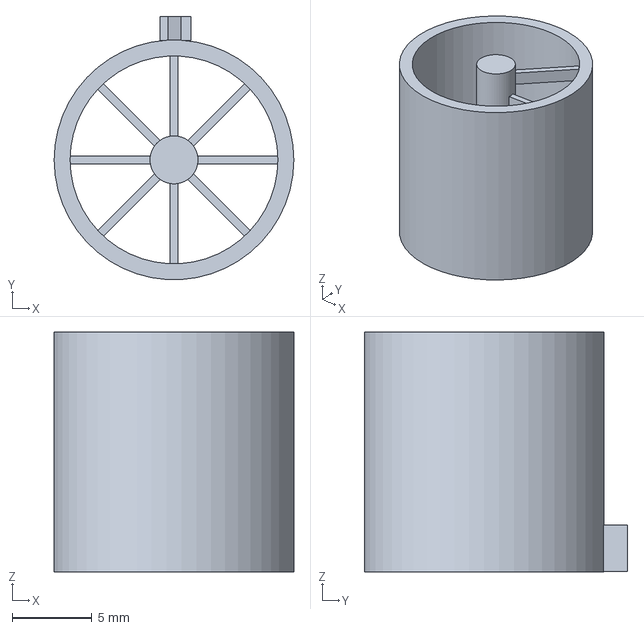
[picture p144: CAD file, 2026-07-07]
Modelos de fibra/Staircase-core/Tests/RSC_direction_test.3mf
15.0 x 16.5 x 15.0 mm
