IPrearo/PPOFs/Modelos de fibra/Staircase-core/Tilted_suspended_core/Tilted_suspended_core_test_V2.0.3mf

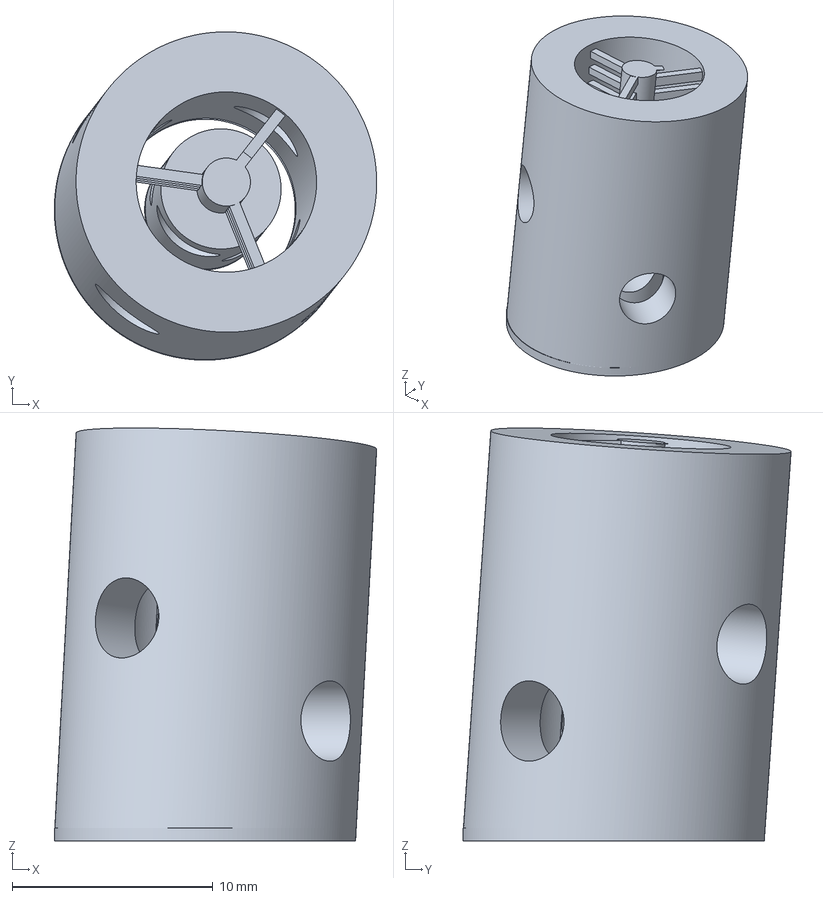
[picture p145: CAD file, 2026-07-07]
Modelos de fibra/Staircase-core/Tilted_suspended_core/Tilted_suspended_core_test_V2.0.3mf
16.1 x 16.4 x 20.6 mm
