IPrearo/PPOFs/Modelos de fibra/V2/Demonstrations/HC3_pressurized.stl

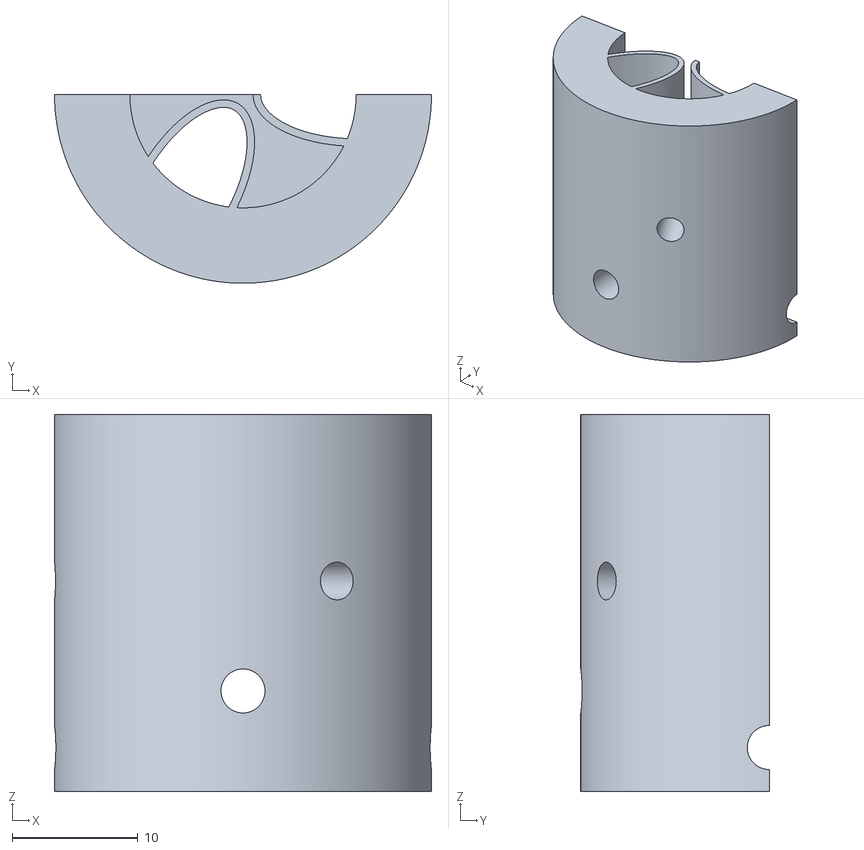
[picture p146: CAD file, 2026-08-21]
Modelos de fibra/V2/Demonstrations/HC3_pressurized.stl
30.0 x 15.0 x 30.0
