IPrearo/PPOFs/Modelos de fibra/V2/V2.4_diversas_dimensoes/V2.4_70mm.3mf

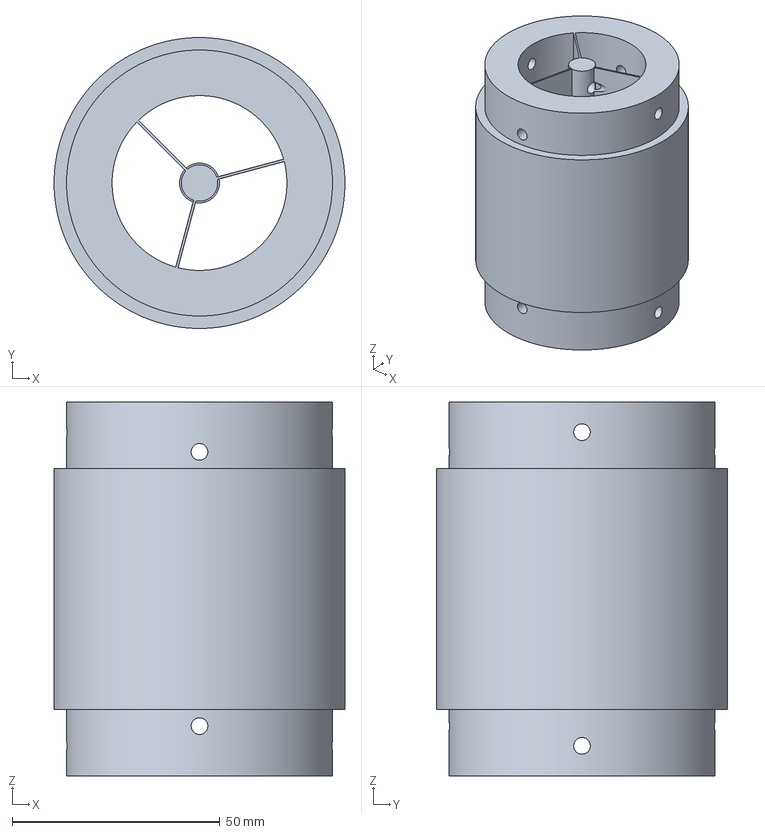
[picture p147: CAD file, 2026-06-10]
Modelos de fibra/V2/V2.4_diversas_dimensoes/V2.4_70mm.3mf
70.0 x 70.0 x 90.0 mm
