IPrearo/PPOFs/Modelos de fibra/V2/V2.5/V2.5_Solid_core_resin.stl

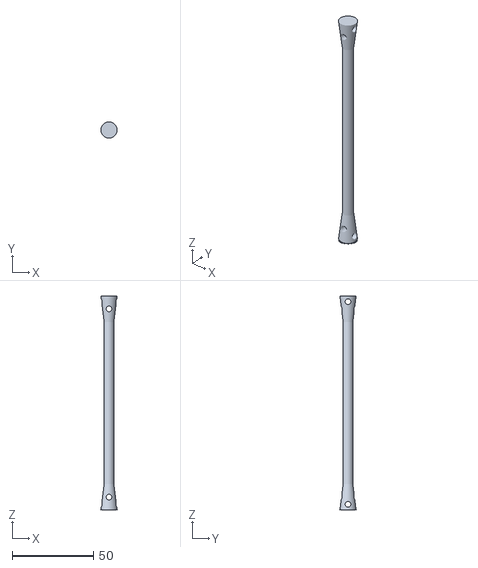
[picture p148: CAD file, 2026-08-20]
Modelos de fibra/V2/V2.5/V2.5_Solid_core_resin.stl
10.0 x 10.0 x 132.0
