IPrearo/PPOFs/Testes de transparência/Structures/Preform_bits/Foot.stl

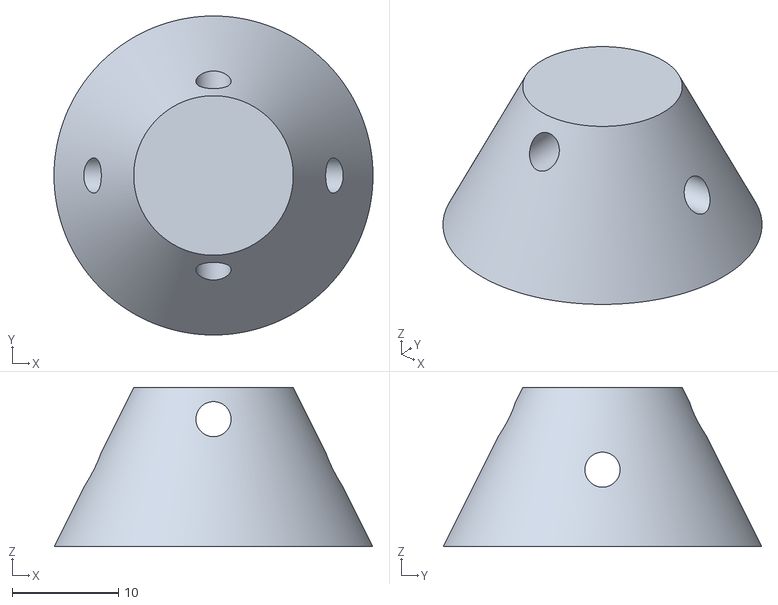
[picture p149: CAD file, 2026-06-10]
Testes de transparência/Structures/Preform_bits/Foot.stl
30.0 x 30.0 x 15.0
