IPrearo/PPOFs/Modelos de fibra/Staircase-core/Demonstrations/Water_test.stl

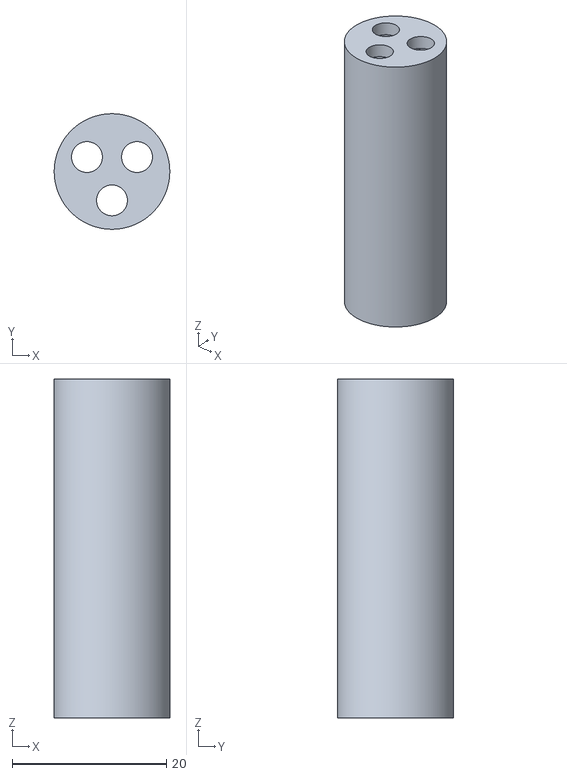
[picture p150: CAD file, 2026-08-25]
Modelos de fibra/Staircase-core/Demonstrations/Water_test.stl
15.0 x 15.0 x 44.0
