IPrearo/PPOFs/Modelos de fibra/Staircase-core/Tilted_suspended_core/Tilted_suspended_core_V2.0.3mf

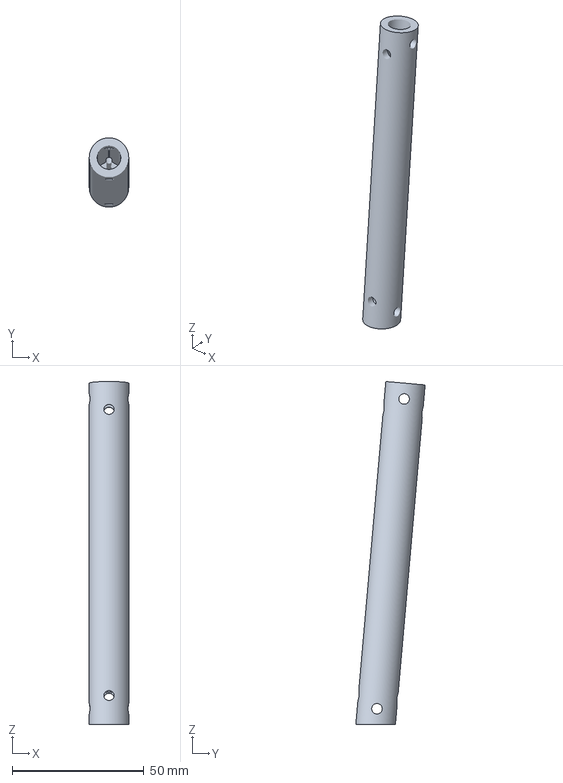
[picture p151: CAD file, 2026-07-07]
Modelos de fibra/Staircase-core/Tilted_suspended_core/Tilted_suspended_core_V2.0.3mf
15.0 x 26.3 x 130.2 mm
