IPrearo/PPOFs/Modelos de fibra/V2/V2.5/V2.5_HC4_15mm_100mm.3mf

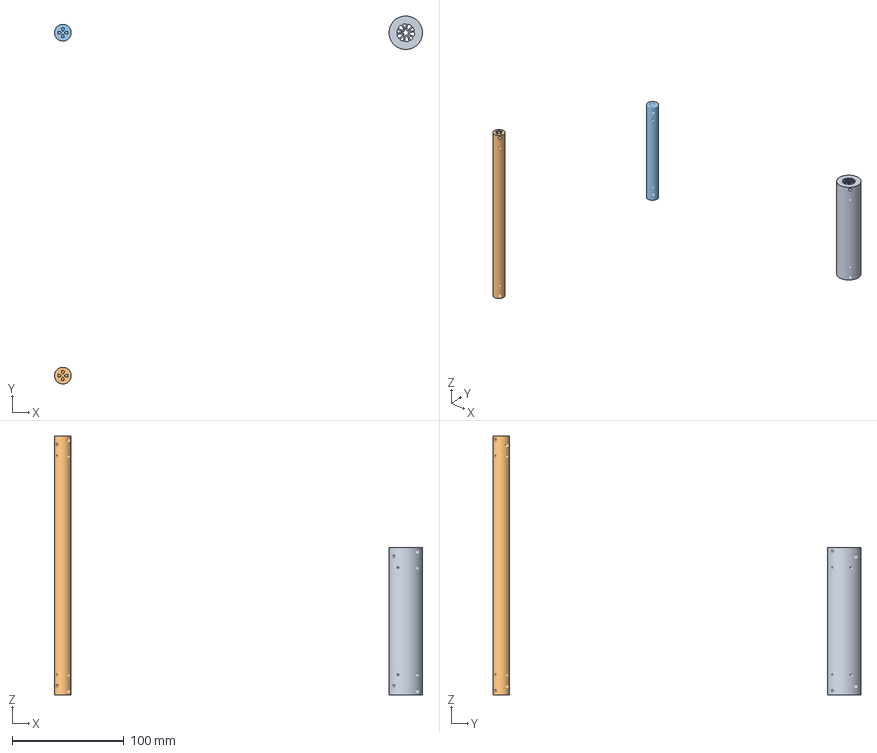
[picture p152: CAD file, 2026-08-20]
Modelos de fibra/V2/V2.5/V2.5_HC4_15mm_100mm.3mf
329.7 x 329.7 x 232.0 mm
V2.5_HC5_30mm_100mm.stl
V2.5_HC4_15mm_200mm.stl
V2.5_HC4_15mm_100mm.stl
