IPrearo/PPOFs/Modelos de fibra/Staircase-core/Tests/Reg_suspended_core.stl

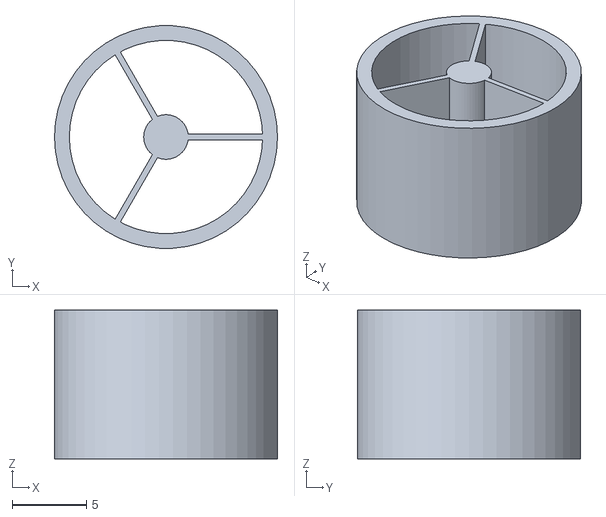
[picture p153: CAD file, 2026-07-07]
Modelos de fibra/Staircase-core/Tests/Reg_suspended_core.stl
15.0 x 15.0 x 10.0
