IPrearo/PPOFs/Testes de transparência/Structures/Cylinder/h40d15.stl

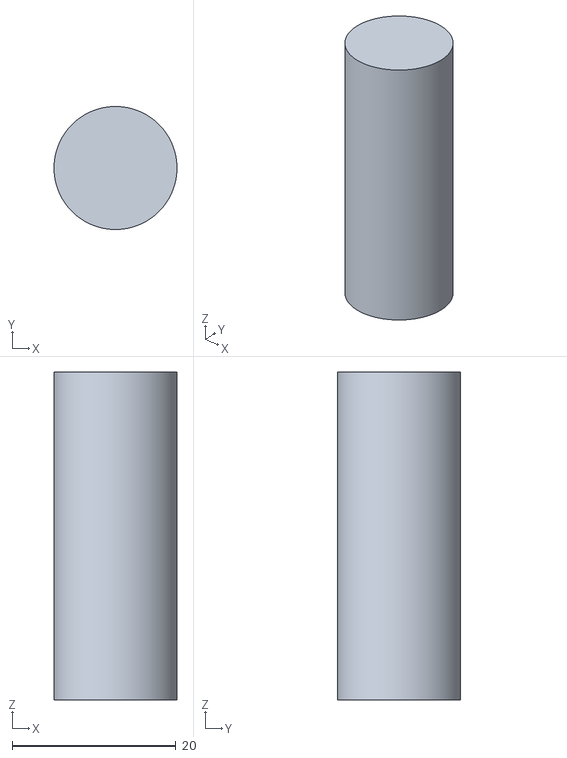
[picture p154: CAD file, 2026-06-10]
Testes de transparência/Structures/Cylinder/h40d15.stl
15.0 x 15.0 x 40.0
