IPrearo/PPOFs/Testes de transparência/Structures/Preform_bits/Head-like.stl

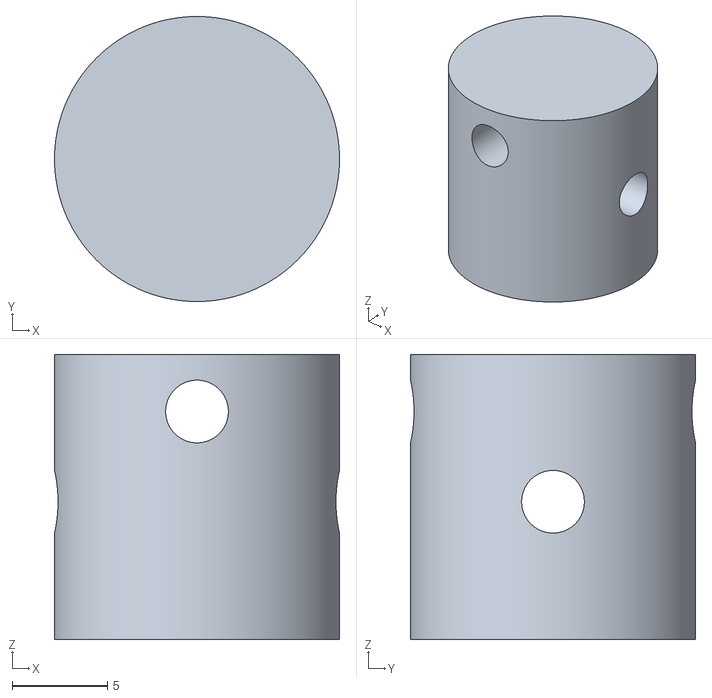
[picture p155: CAD file, 2026-06-10]
Testes de transparência/Structures/Preform_bits/Head-like.stl
15.0 x 15.0 x 15.0
