IPrearo/PPOFs/Modelos de fibra/Staircase-core/Demonstrations/Staircase_core_showmodel_V2.0.3mf

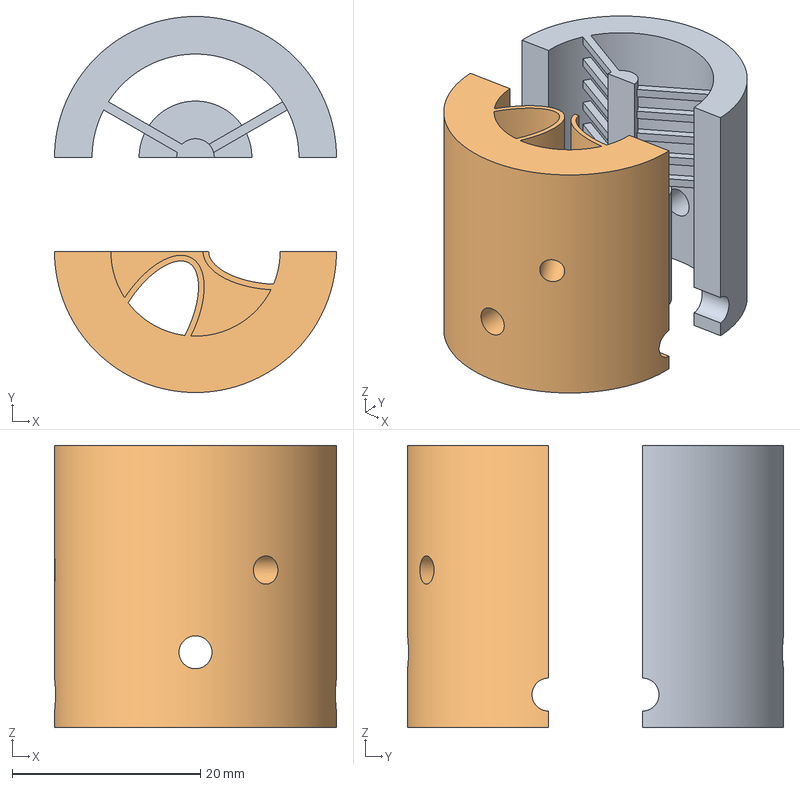
[picture p156: CAD file, 2026-08-21]
Modelos de fibra/Staircase-core/Demonstrations/Staircase_core_showmodel_V2.0.3mf
30.0 x 40.0 x 30.0 mm
Staircase_core_showmodel_V2.0.stl
HC3_pressurized.stl
