IPrearo/PPOFs/Modelos de fibra/Staircase-core/Tests/RSC_direction_test_V2.1.3mf

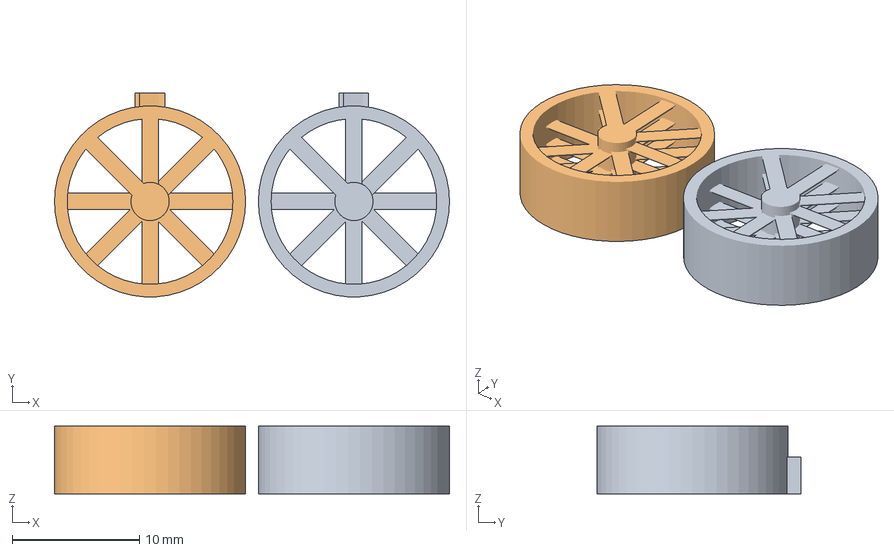
[picture p157: CAD file, 2026-07-07]
Modelos de fibra/Staircase-core/Tests/RSC_direction_test_V2.1.3mf
31.0 x 16.0 x 5.30 mm
RSC_direction_test_V2.1.stl x 2
