IPrearo/PPOFs/Modelos de fibra/V2/V2.5/V2.5_HC.3mf

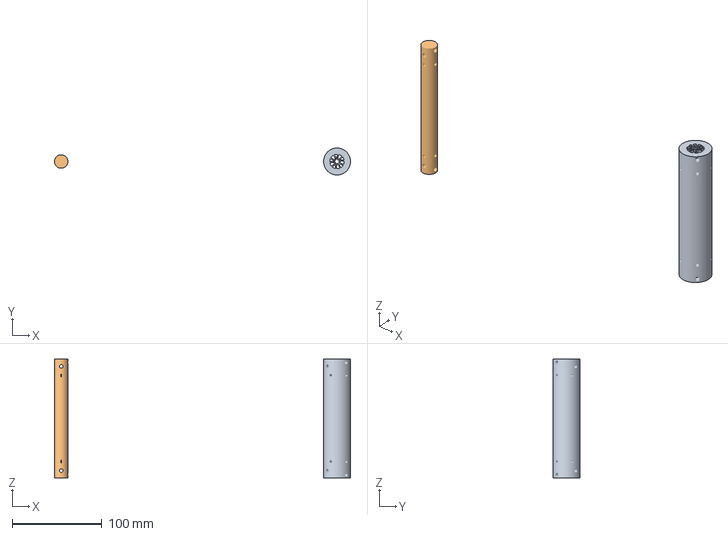
[picture p158: CAD file, 2026-08-20]
Modelos de fibra/V2/V2.5/V2.5_HC.3mf
329.7 x 30.0 x 132.0 mm
V2.5_HC5_30mm_100mm.stl
V2.5_HC4_15mm_100mm.stl
