IPrearo/PPOFs/Testes de transparência/Structures/Cube/Cube.stl

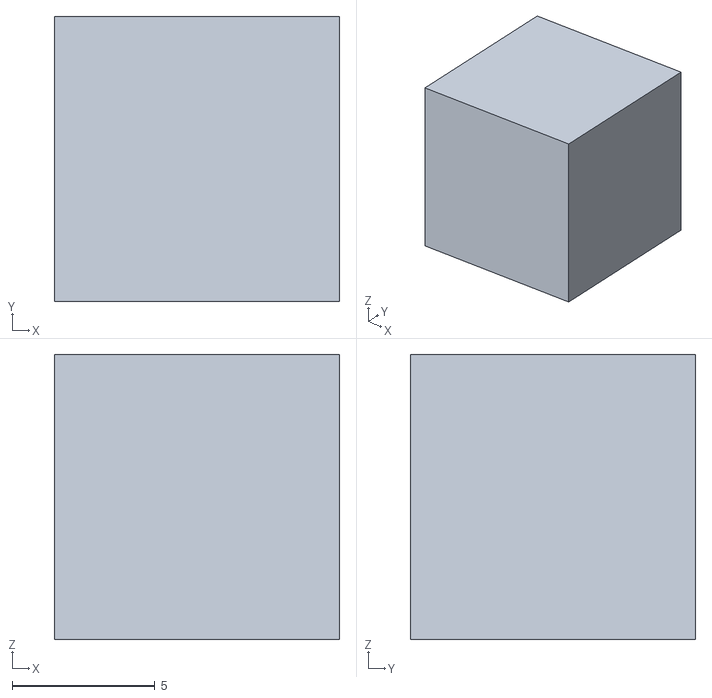
[picture p159: CAD file, 2026-06-10]
Testes de transparência/Structures/Cube/Cube.stl
10.0 x 10.0 x 10.0
