IPrearo/PPOFs/Testes de transparência/Structures/Microstructures/V3.5.3mf

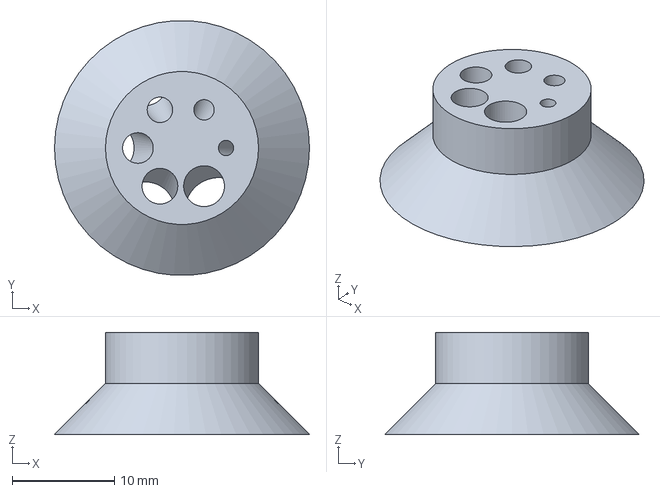
[picture p161: CAD file, 2026-06-10]
Testes de transparência/Structures/Microstructures/V3.5.3mf
25.0 x 25.0 x 10.0 mm
