IPrearo/PPOFs/Modelos de fibra/V2/V2.5/V2.5_HC4_15mm_200mm.stl

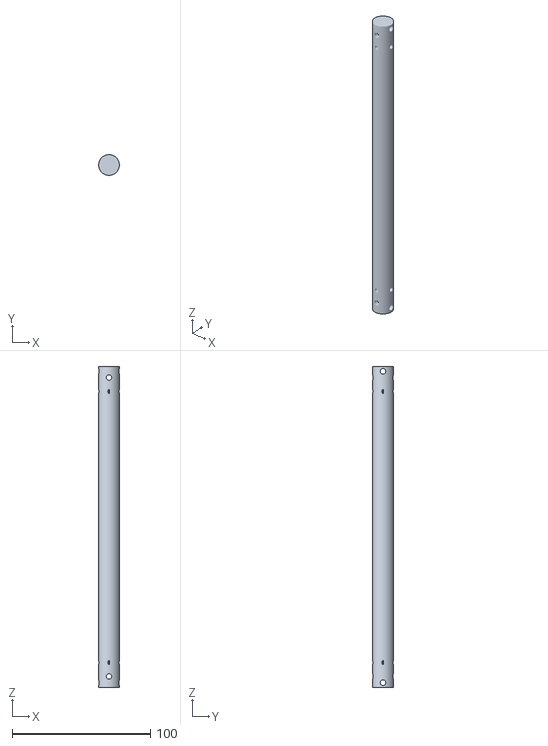
[picture p162: CAD file, 2026-08-20]
Modelos de fibra/V2/V2.5/V2.5_HC4_15mm_200mm.stl
15.0 x 15.0 x 232.0
