IPrearo/PPOFs/Modelos de fibra/Staircase-core/Tests/RSC_rect_V1.0.3mf

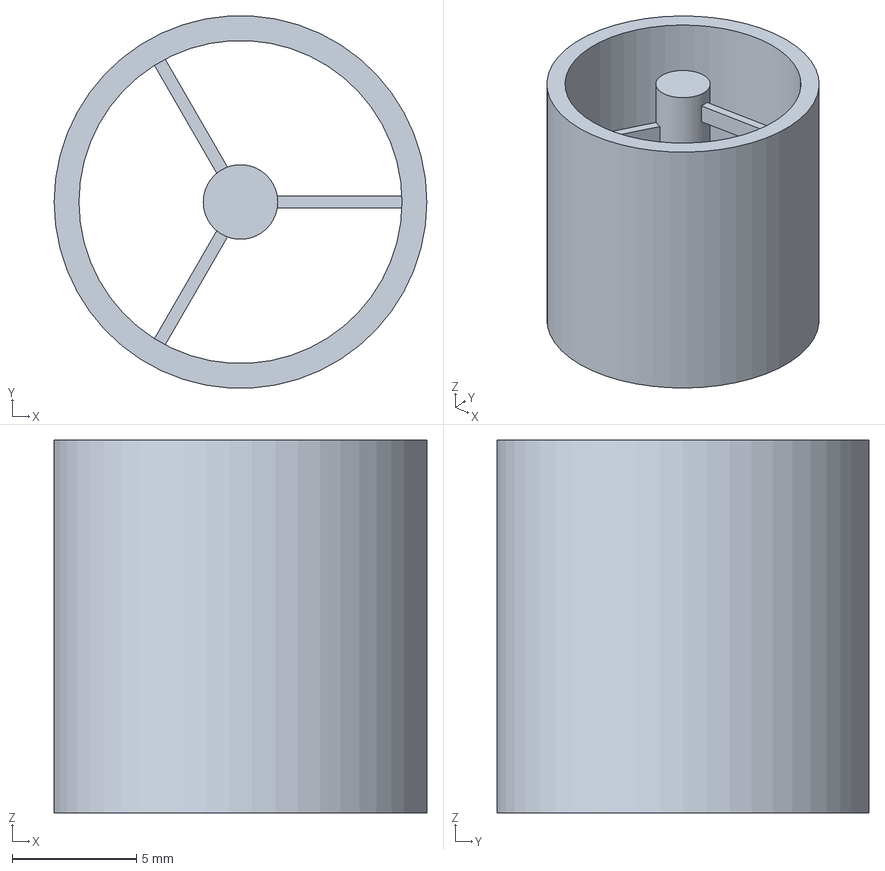
[picture p163: CAD file, 2026-07-07]
Modelos de fibra/Staircase-core/Tests/RSC_rect_V1.0.3mf
15.0 x 15.0 x 15.0 mm
