IPrearo/PPOFs/Modelos de fibra/V2/V2.5/V2.5_HC5_30mm_100mm.stl

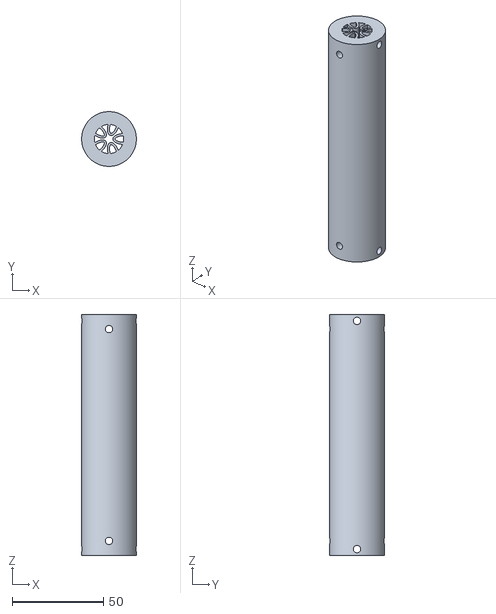
[picture p164: CAD file, 2026-08-20]
Modelos de fibra/V2/V2.5/V2.5_HC5_30mm_100mm.stl
30.0 x 30.0 x 132.0
