IPrearo/PPOFs/Testes de transparência/Structures/Preform_bits/Foot-likeV2.3mf

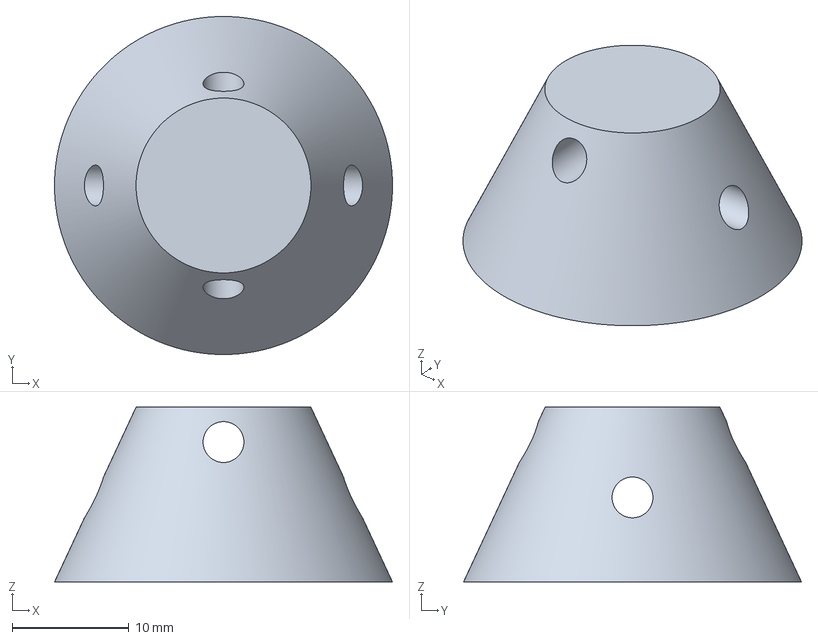
[picture p165: CAD file, 2026-06-10]
Testes de transparência/Structures/Preform_bits/Foot-likeV2.3mf
29.0 x 29.0 x 15.0 mm
