IPrearo/PPOFs/Modelos de fibra/Staircase-core/Tests/RSC_flat_V1.0.stl

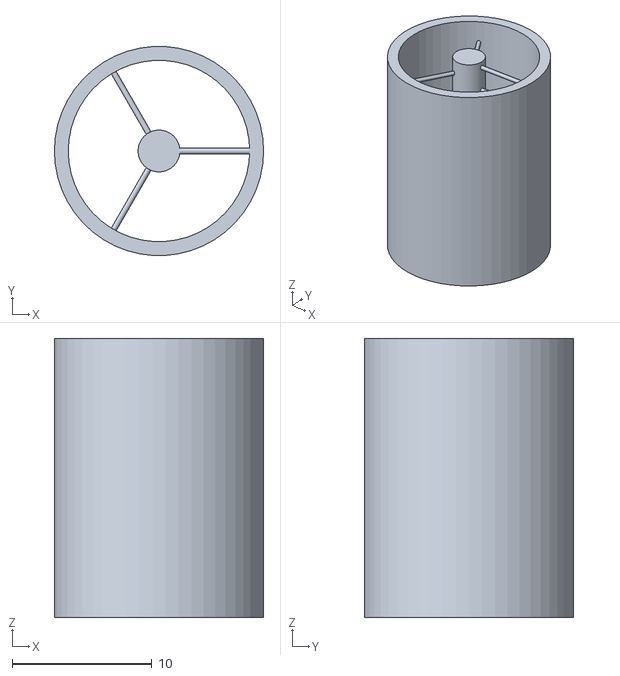
[picture p166: CAD file, 2026-07-07]
Modelos de fibra/Staircase-core/Tests/RSC_flat_V1.0.stl
15.0 x 15.0 x 20.0
