IPrearo/PPOFs/Modelos de fibra/V2/V2.5/V2.5_HC3_15mm.3mf

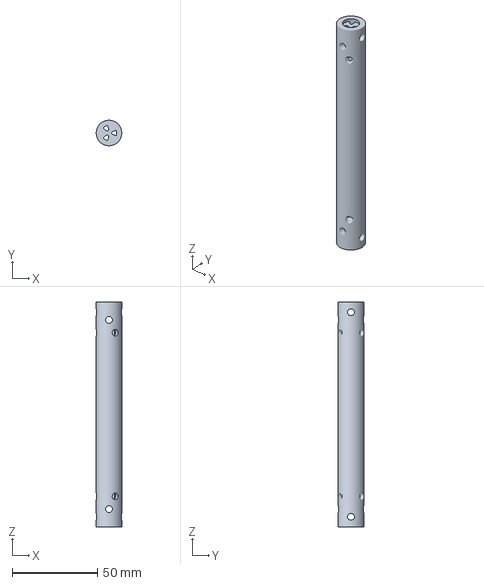
[picture p167: CAD file, 2026-07-29]
Modelos de fibra/V2/V2.5/V2.5_HC3_15mm.3mf
15.0 x 15.0 x 132.0 mm
