IPrearo/PPOFs/Modelos de fibra/Staircase-core/Tests/V1.0_vs_regular.3mf

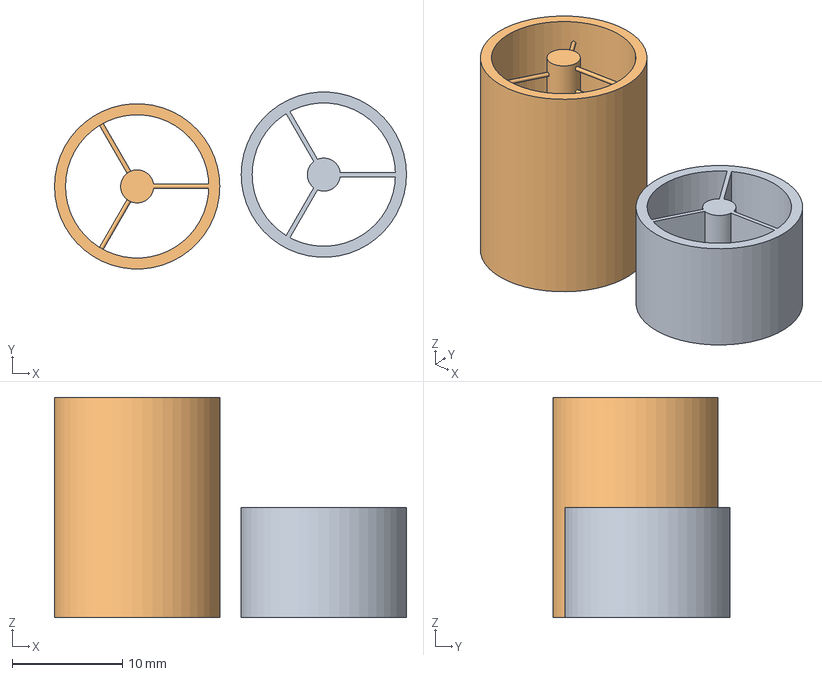
[picture p168: CAD file, 2026-07-07]
Modelos de fibra/Staircase-core/Tests/V1.0_vs_regular.3mf
31.9 x 16.0 x 20.0 mm
Reg_suspended_core.stl
RSC_flat_V1.0.stl
