IPrearo/PPOFs/Modelos de fibra/V2/V2.5/V2.5_HC3_15mm_200mm.stl

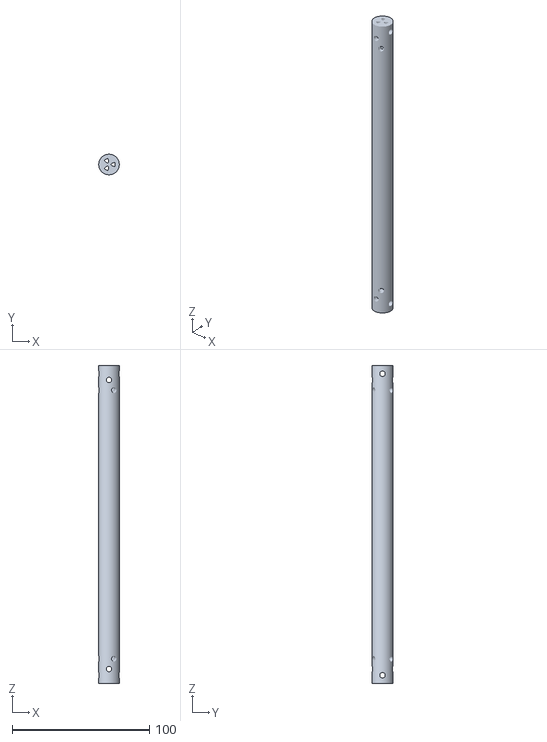
[picture p169: CAD file, 2026-07-29]
Modelos de fibra/V2/V2.5/V2.5_HC3_15mm_200mm.stl
15.0 x 15.0 x 232.0
