IPrearo/PPOFs/Testes de transparência/Structures/Cylinder/V2.4.3mf

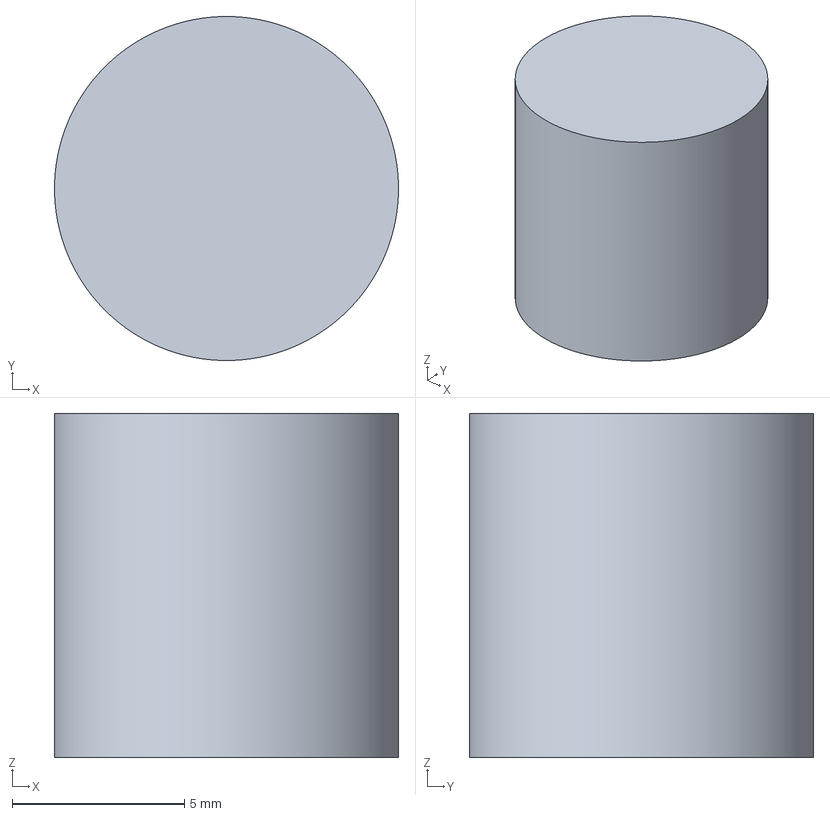
[picture p170: CAD file, 2026-06-10]
Testes de transparência/Structures/Cylinder/V2.4.3mf
10.0 x 10.0 x 10.0 mm
