IPrearo/PPOFs/Modelos de fibra/V2/V2.5/V2.5.3mf

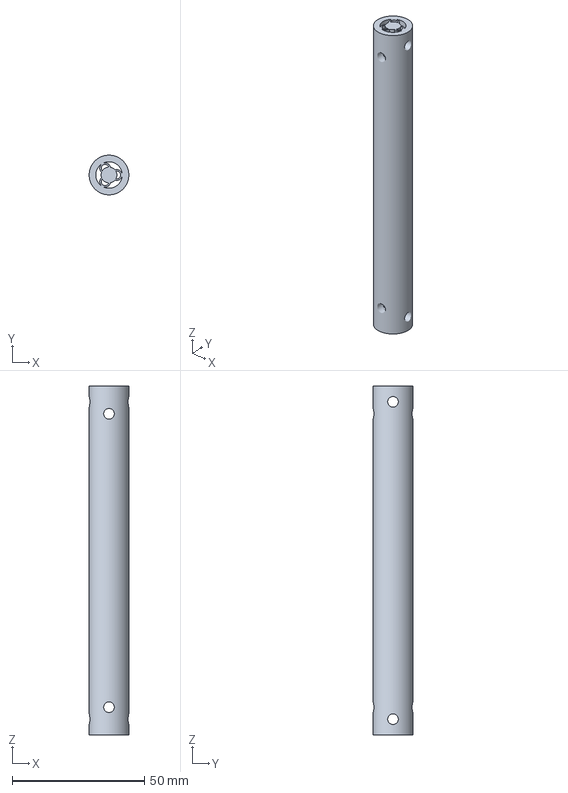
[picture p171: CAD file, 2026-06-10]
Modelos de fibra/V2/V2.5/V2.5.3mf
15.0 x 15.0 x 132.0 mm
