IPrearo/PPOFs/Testes de transparência/Structures/Cylinder/Drawing.scad

$fn = 500;

cylinder(h=40, d=15);
