IPrearo/PPOFs/(list of files, cad)

Other CAD files:
Modelos de fibra/Staircase-core/Demonstrations/Water_test.gcode.3mf
Modelos de fibra/Staircase-core/Staircase-core/Staircase-core_0deg.gcode.3mf
Modelos de fibra/Staircase-core/Tests/V1.0_vs_regular.gcode.3mf
Testes de transparência/Structures/Microstructures/V3.4.gcode.3mf
Modelos de fibra/Staircase-core/Demonstrations/Staircase_core_showmodel_V2.0.gcode.3mf
Modelos de fibra/Staircase-core/Tilted_suspended_core/Tilted_suspended_core_V2.0.gcode.3mf
Modelos de fibra/V2/V2.5/V2.5_HC4_15mm_100mm.gcode.3mf
Modelos de fibra/Staircase-core/Staircase-core/Tilted_suspended_core_V2.0.gcode.3mf
Modelos de fibra/Staircase-core/Tilted_suspended_core/Tilted_suspended_core_test_V2.0.gcode.3mf
Modelos de fibra/Staircase-core/Demonstrations/Staircase_core_and_HC3_showmodel_2x.gcode.3mf
Modelos de fibra/Staircase-core/Staircase-core/Tilted_suspended_core_test_V2.0.gcode.3mf
Modelos de fibra/Staircase-core/Tests/RSC_direction_test_V2.1.gcode.3mf
Testes de transparência/Structures/Cube/V1.10.3mf
Testes de transparência/Structures/Preform_bits/Head-likev2.stl
Modelos de fibra/Staircase-core/Demonstrations/Staircase-core_0deg.gcode.3mf
Modelos de fibra/Staircase-core/Demonstrations/Staircase_core_and_HC3_showmodel.gcode.3mf
Testes de transparência/Structures/Preform_bits/V3.2.3mf
Modelos de fibra/Staircase-core/Tests/RSC_rect_V1.0.gcode.3mf
Modelos de fibra/V2/V2.5/HC3_15mm.gcode.3mf
Testes de transparência/Structures/Cylinder/Drawing.stl
Modelos de fibra/Staircase-core/Tests/RSC_direction_test.gcode.3mf
Testes de transparência/Structures/Cube/V1.3.gcode.3mf
Modelos de fibra/V2/V2.5/15mm_HC_test.gcode.3mf
Modelos de fibra/tilted_suspended_core/Tilted_suspended_core_V2.0.scad
Testes de transparência/Structures/Preform_bits/Foot-likeV2.scad
Modelos de fibra/Staircase-core/Demonstrations/Staircase_core_showmodel_V2.0.stl
Modelos de fibra/Staircase-core/Staircase-core/Staircase-core_0deg.stl
Modelos de fibra/Staircase-core/Staircase-core/Tilted_suspended_core_V2.0.stl
Modelos de fibra/Staircase-core/Staircase-core/Tilted_suspended_core_test_V2.0.stl
Modelos de fibra/Staircase-core/Tests/RSC_direction_test.stl
Modelos de fibra/Staircase-core/Tests/RSC_direction_test_V2.1.stl
Modelos de fibra/Staircase-core/Tests/RSC_direction_test_V2.3mf
Modelos de fibra/Staircase-core/Tests/RSC_direction_test_V2.gcode.3mf
Modelos de fibra/Staircase-core/Tests/RSC_direction_test_V2.stl
Modelos de fibra/Staircase-core/Tests/RSC_rect_V1.0.stl
Modelos de fibra/Staircase-core/Tilted_suspended_core/Tilted_suspended_core_V2.0.stl
Modelos de fibra/Staircase-core/Tilted_suspended_core/Tilted_suspended_core_test_V2.0.stl
Modelos de fibra/V2/V2.0/Preform_V2.0.3mf
Modelos de fibra/V2/V2.0/Supported_V2.0.stl
Modelos de fibra/V2/V2.0/Suspended_V2.0.3mf
Modelos de fibra/V2/V2.1/V2.1-hcore.stl
Modelos de fibra/V2/V2.1/V2.1.stl
Modelos de fibra/V2/V2.2/V2.2-hex2.3mf
Modelos de fibra/V2/V2.2/V2.2-hex2.stl
Modelos de fibra/V2/V2.3/V2.3-susp.3mf
Modelos de fibra/V2/V2.3/V2.3-susp.gcode.3mf
Modelos de fibra/V2/V2.5/V2.5_HC3_15mm.stl
Modelos de fibra/V2/V2.5/V2.5_HC4_15mm_100mm.stl
Testes de transparência/Structures/Cube/V1.1.3mf
Testes de transparência/Structures/Cube/V1.1.gcode.3mf
Testes de transparência/Structures/Cube/V1.2.3mf
Testes de transparência/Structures/Cube/V1.2.gcode.3mf
Testes de transparência/Structures/Cube/V1.3.3mf
Testes de transparência/Structures/Cube/V1.4.3mf
Testes de transparência/Structures/Cube/V1.5.3mf
Testes de transparência/Structures/Cube/V1.6.3mf
Testes de transparência/Structures/Cube/V1.7.3mf
Testes de transparência/Structures/Cube/V1.8.3mf
Testes de transparência/Structures/Cube/V1.9.3mf
Testes de transparência/Structures/Cube/v0.3mf
Testes de transparência/Structures/Cube/v1.0.3mf
Testes de transparência/Structures/Cube/v1.0.gcode.3mf
Testes de transparência/Structures/Cube/v1.3mf
Testes de transparência/Structures/Cylinder/V2.0.3mf
Testes de transparência/Structures/Cylinder/V2.1.3mf
Testes de transparência/Structures/Cylinder/V2.2.3mf
Testes de transparência/Structures/Cylinder/V2.3.3mf
Testes de transparência/Structures/Cylinder/v1.0.3mf
Testes de transparência/Structures/Microstructures/V3.0.3mf
Testes de transparência/Structures/Microstructures/V3.0.stl
Testes de transparência/Structures/Microstructures/V3.1.3mf
Testes de transparência/Structures/Microstructures/V3.1.stl
Testes de transparência/Structures/Microstructures/V3.2.3mf
Testes de transparência/Structures/Microstructures/V3.2.stl
Testes de transparência/Structures/Microstructures/V3.3.3mf
Testes de transparência/Structures/Microstructures/V3.3.gcode.3mf
Testes de transparência/Structures/Microstructures/V3.3.stl
Testes de transparência/Structures/Microstructures/V3.4.3mf
Testes de transparência/Structures/Preform_bits/Foot-likeV2.stl
Testes de transparência/Structures/Preform_bits/V3.0.3mf
Testes de transparência/Structures/Preform_bits/V3.1.3mf
