IPrearo/PPOFs/Relatorios de puxamento/PLT0022_no_core_petghf_vermelho_fdm/puxamento/segunda_tentativa_resultado.jpg

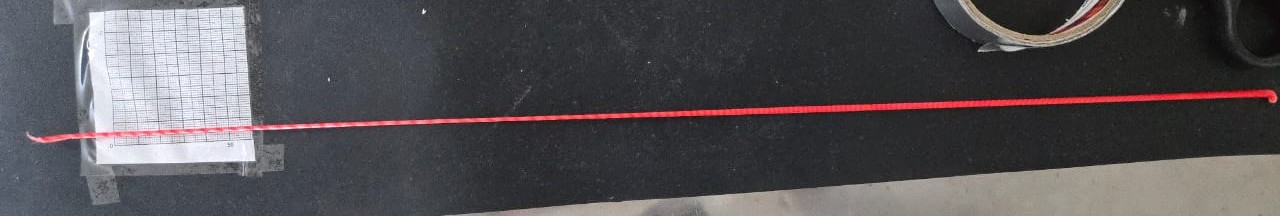
Relatorios de puxamento/PLT0022_no_core_petghf_vermelho_fdm/puxamento/segunda_tentativa_resultado.jpg
