IPrearo/PPOFs/Relatorios de puxamento/PLT0026_no_core_petghf_vermelho_fdm/puxamento/resultado2.jpg

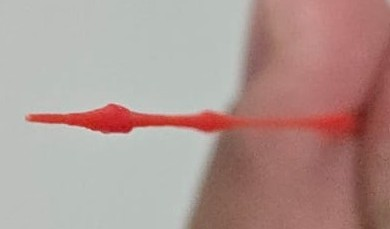
Relatorios de puxamento/PLT0026_no_core_petghf_vermelho_fdm/puxamento/resultado2.jpg
