IPrearo/PPOFs/Relatorios de puxamento/PLT0030_no_core_petghf_vermelho_fdm/puxamento/Resultado_0030.jpeg

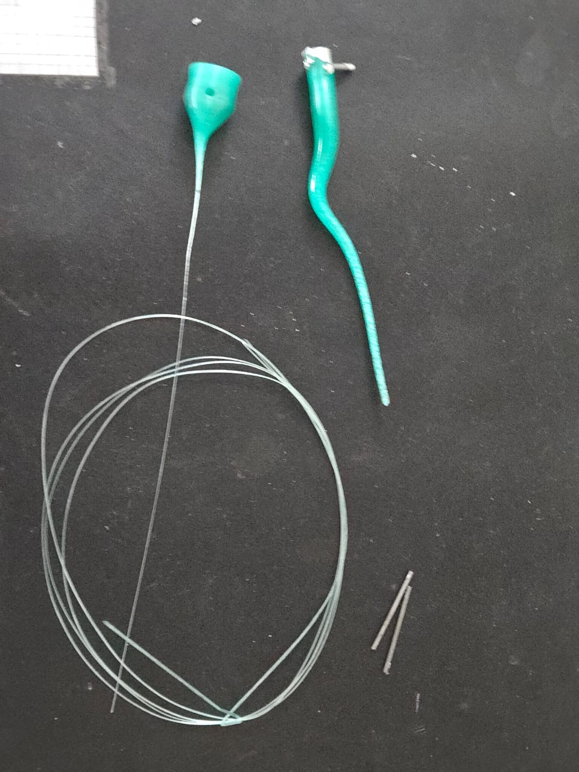
Relatorios de puxamento/PLT0030_no_core_petghf_vermelho_fdm/puxamento/Resultado_0030.jpeg
