IPrearo/PPOFs/Relatorios de puxamento/PLT0038_no_core_petg_translucido_fdm/puxamento/Zoom_resultado.jpeg

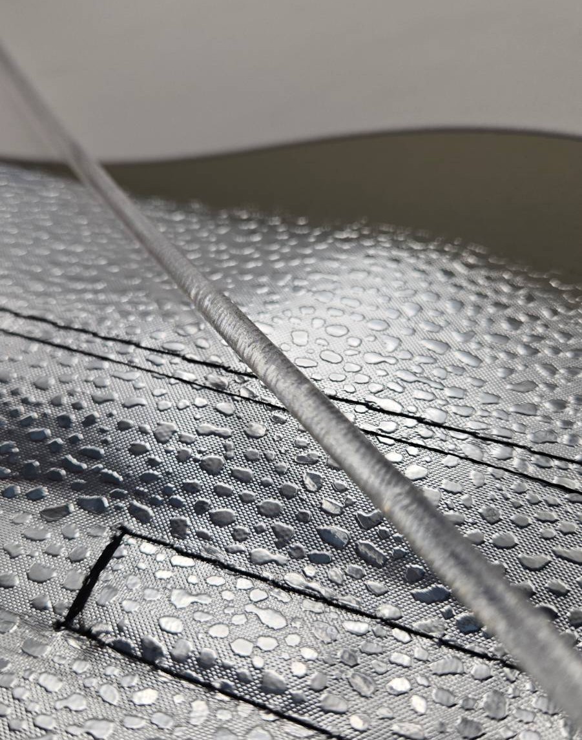
Relatorios de puxamento/PLT0038_no_core_petg_translucido_fdm/puxamento/Zoom_resultado.jpeg
