IPrearo/PPOFs/Relatorios de puxamento/PLT0039_no_core_petg_esverdeado_fdm/puxamento/Resultados(2).jpeg

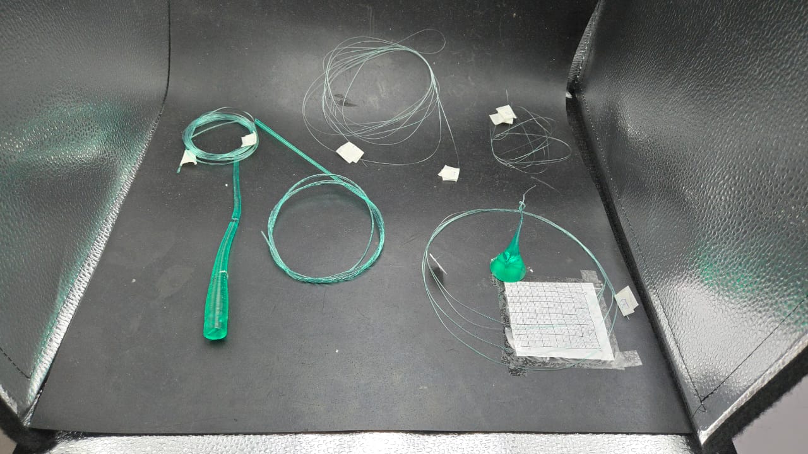
Relatorios de puxamento/PLT0039_no_core_petg_esverdeado_fdm/puxamento/Resultados(2).jpeg
