IPrearo/PPOFs/Testes de transparência/Images/PETG translucido/Cube/V1.10/Unfinished/Corner2.tiff

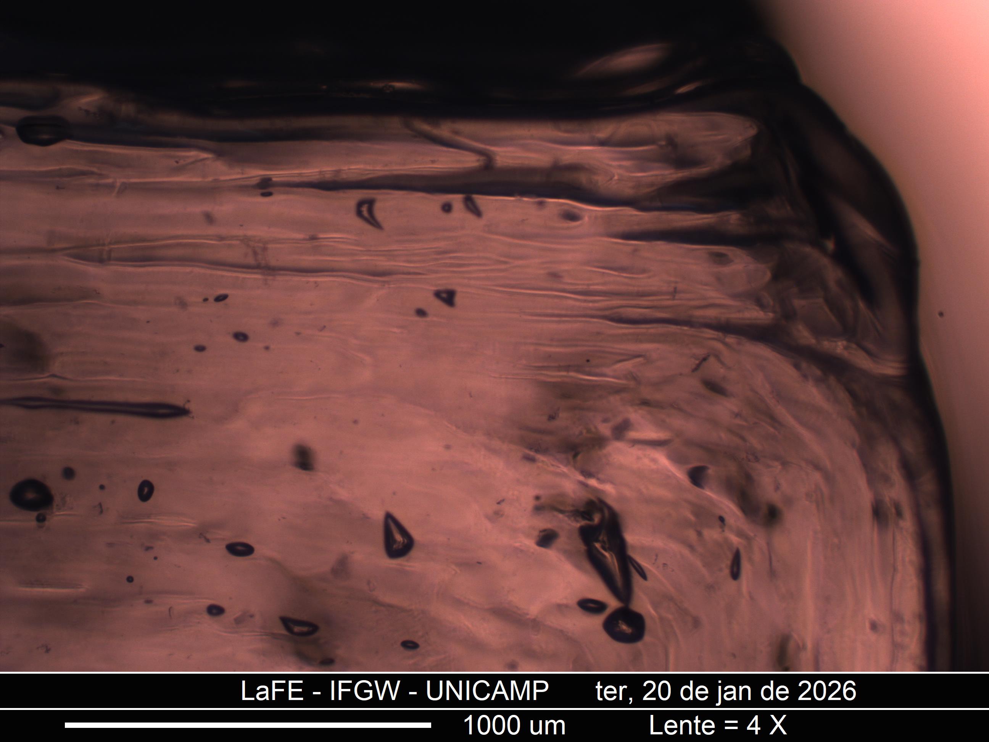
Testes de transparência/Images/PETG translucido/Cube/V1.10/Unfinished/Corner2.tiff
