IPrearo/PPOFs/Testes de transparência/Images/PETG translucido/Cube/V1.10/Unfinished/Figura.tiff

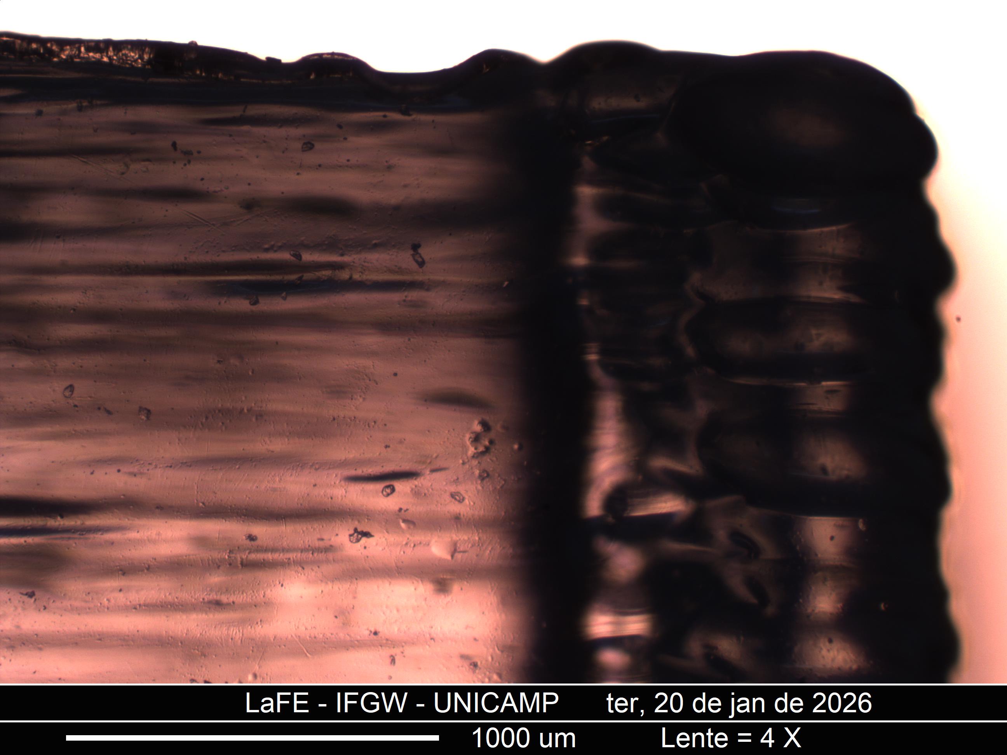
Testes de transparência/Images/PETG translucido/Cube/V1.10/Unfinished/Figura.tiff
