IPrearo/PPOFs/Testes de transparência/Images/PETG translucido/Cube/V1.10/Unfinished/Middle_layers.tiff

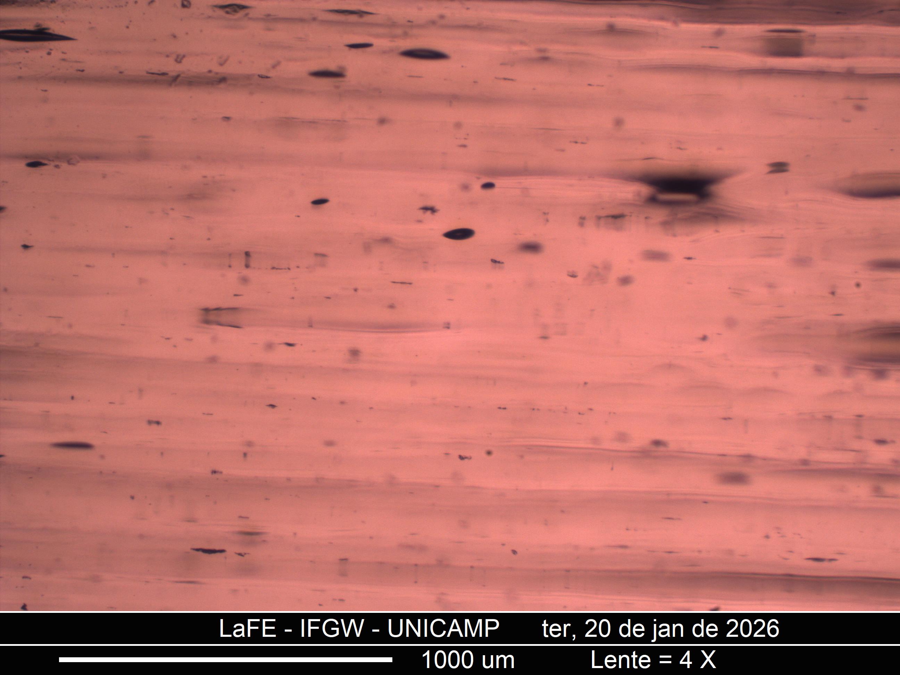
Testes de transparência/Images/PETG translucido/Cube/V1.10/Unfinished/Middle_layers.tiff
