IPrearo/PPOFs/(commit log)

2026-06-08 Adição de primeiros relatórios de puxamento
2026-06-08 Mudança de título no readme
2026-06-08 Adição de primeiro template de impressões
2026-06-10 Adicionados testes de transparencia
    [Cube.stl, Drawing.scad, Drawing.stl, Foot-likeV2.3mf, Foot-likeV2.scad, Foot-likeV2.stl, Foot.stl, Head-like.stl]
2026-06-10 Adicionados modelos de preformas para fibras
    [15mm_HC_test.gcode.3mf, ABS-V1.0.gcode.3mf, Headless_V1.0.3mf, Headless_V1.0.stl, Lid_test.stl, PETG-HF-V1.0.gcode.3mf, PETG-V1.0.gcode.3mf, PETG_HF_headless_V1.0.gcode.3mf]
2026-07-07 Reorganização
    [Lid_test.stl]
2026-07-07 Adicao biblioteca de microestruturas
    [Microstructures.scad]
2026-07-07 Adicionada tilted suspended core
    [RSC_direction_test.3mf, RSC_direction_test.gcode.3mf, RSC_direction_test.stl, RSC_direction_test_V2.1.3mf, RSC_direction_test_V2.1.gcode.3mf, RSC_direction_test_V2.1.stl, RSC_direction_test_V2.3mf, RSC_direction_test_V2.gcode.3mf]
2026-07-22 Novos relatorios de puxamento
    [Reg_suspended_core.scad, Tilted_suspended_core_V2.0.scad, suspended_core_V1.0.scad, tilted_suspended_core.scad]
2026-07-22 Adicao plots de dados de puxamento
2026-07-29 Atualizacao de modelos de fibra
    [HC3_15mm.gcode.3mf, Tilted_suspended_core_V2.0.scad, V2.0.scad, V2.5_HC3_15mm.3mf, V2.5_HC3_15mm.stl, V2.5_HC3_15mm_200mm.stl]
2026-07-29 Remoção de modelos desatualizados
    [ABS-V1.0.gcode.3mf, Headless_V1.0.3mf, Headless_V1.0.stl, PETG-HF-V1.0.gcode.3mf, PETG-V1.0.gcode.3mf, PETG_HF_headless_V1.0.gcode.3mf, Preforma_Guilherme_V2.stl, Preforma_impressa_V1.0.scad]
2026-07-29 Atualização de microestruturas
    [Microstructures.scad]
2026-08-20 Tilted core changed to Staircase Core
    [RSC_direction_test.3mf, RSC_direction_test.gcode.3mf, RSC_direction_test.stl, RSC_direction_test_V2.1.3mf, RSC_direction_test_V2.1.gcode.3mf, RSC_direction_test_V2.1.stl, RSC_direction_test_V2.3mf, RSC_direction_test_V2.gcode.3mf]
2026-08-20 Model updates
    [Microstructures.scad, V2.0.scad, V2.5_HC.3mf, V2.5_HC4_15mm_100mm.3mf, V2.5_HC4_15mm_100mm.gcode.3mf, V2.5_HC4_15mm_100mm.stl, V2.5_HC4_15mm_200mm.stl, V2.5_HC5_30mm_100mm.stl]
2026-08-20 Elefant foot compensation for preforms
    [Staircase-core_0deg.3mf, Staircase-core_0deg.gcode.3mf, Staircase-core_0deg.stl, Staircase-core_V2.0.scad, V2.0.scad]
2026-08-20 Added steps and ranges for parametric design
    [V2.0.scad, V2.5_Solid_core_resin.stl]
2026-08-20 New pressurization subgroup
    [V2.0.scad]
2026-08-21 Reports and small changes
    [HC3_pressurized.stl, Medidas.ods, Sitrcase_core_showmodel_V2.0.3mf, Sitrcase_core_showmodel_V2.0.gcode.3mf, Sitrcase_core_showmodel_V2.0.stl, Staircase-core_0deg.3mf, Staircase-core_0deg.gcode.3mf, Staircase-core_V2.0.scad]
2026-08-25 Added demonstration parameters for staircase core
    [Staircase-core_V2.0.scad, Water_test.gcode.3mf, Water_test.stl]
