IPrearo/PPOFs/(notices)

Notices in the files:
Relatorios de puxamento/PLT0028_no_core_petghf_vermelho_fdm/relatorio.pdf:
© 2025 LaFE. All rights reserved. | Ultima data de revis˜ao: 10/11/2025 ´
Relatorios de puxamento/PLT0026_no_core_petghf_vermelho_fdm/relatorio.pdf:
© 2025 LaFE. All rights reserved. | Ultima data de revis˜ao: 31/10/2025 ´
Relatorios de puxamento/PLT0024_no_core_petghf_vermelho_fdm/relatorio.pdf:
© 2025 LaFE. All rights reserved. | Ultima data de revis˜ao: 30/10/2025 ´
Relatorios de puxamento/PLT0038_no_core_petg_translucido_fdm/relatorio.pdf:
© 2025 LaFE. All rights reserved. | Ultima data de revis˜ao: 10/02/2026 ´
Relatorios de puxamento/PLT0021_no_core_petghf_vermelho_fdm/relatorio.pdf:
© 2025 LaFE. All rights reserved. | Ultima data de revis˜ao: 17/10/2025 ´
Relatorios de puxamento/PLT0072_suspended_core_petg_esverdeado_fdm/relatorio.pdf:
© 2026 LaFE. All rights reserved. | Ultima data de revis˜ao: 28/05/2026 ´
Relatorios de puxamento/PLT0033_no_core_petg_translucido_fdm/relatorio.pdf:
© 2025 LaFE. All rights reserved. | Ultima data de revis˜ao: 01/12/2025 ´
Relatorios de puxamento/PLT0030_no_core_petghf_vermelho_fdm/relatorio.pdf:
© 2025 LaFE. All rights reserved. | Ultima data de revis˜ao: 18/11/2025 ´
Relatorios de puxamento/PLT0065_suspended_core_petg_esverdeado_fdm/relatorio.pdf:
© 2026 LaFE. All rights reserved. | Ultima data de revis˜ao: 10/05/2026 ´
Relatorios de puxamento/PLT0022_no_core_petghf_vermelho_fdm/relatorio.pdf:
© 2025 LaFE. All rights reserved. | Ultima data de revis˜ao: 23/10/2025 ´
Relatorios de puxamento/PLT0015_suspended_core_petghf_vermelho_fdm/relatorio.pdf:
© 2025 LaFE. All rights reserved. | Ultima data de revis˜ao: 26/09/2025 ´
Relatorios de puxamento/PLT0077_HC3_eliptico_petg_esverdeado/relatorio.pdf:
© 2026 LaFE. All rights reserved. | Ultima data de revis˜ao: 30/07/2026 ´
Relatorios de puxamento/PLT0074_HC3_petg_esverdeado_fdm/relatorio.pdf:
© 2026 LaFE. All rights reserved. | Ultima data de revis˜ao: 17/07/2026 ´
Relatorios de puxamento/PLT0019_no_core_petghf_vermelho_fdm/relatorio.pdf:
© 2025 LaFE. All rights reserved. | Ultima data de revis˜ao: 10/10/2025 ´
